ctw-design-team/aiot-mask-de10-nano-v2/SCHEMATIC/Prop123456.pdf

Object | Property Name | Property Value
GND : GND_19036 (Wire ID = 19050 ) | Name | GND_19036
Object | Property Name | Property Value
GND : GND_19036 (Wire ID = 19064 ) | Name | GND_19036
Object | Property Name | Property Value
GND : GND_19036 (Wire ID = 19078 ) | Name | GND_19036
Object | Property Name | Property Value
GND : GND_19036 (Wire ID = 19092 ) | Name | GND_19036
Object | Property Name | Property Value
GND : GND_19036 (Wire ID = 19106 ) | Name | GND_19036
Object | Property Name | Property Value
GND : GND_19036 (Wire ID = 19120 ) | Name | GND_19036
Object | Property Name | Property Value
GND : GND_19036 (Wire ID = 19134 ) | Name | GND_19036
Object | Property Name | Property Value
GND : GND_19036 (Wire ID = 19148 ) | Name | GND_19036
Object | Property Name | Property Value
GND : GND_19036 (Wire ID = 19162 ) | Name | GND_19036
Object | Property Name | Property Value
GND : GND_19036 (Wire ID = 19176 ) | Name | GND_19036
Object | Property Name | Property Value
GND : GND_19036 (Wire ID = 19190 ) | Name | GND_19036
Object | Property Name | Property Value
GND : GND_19036 (Wire ID = 19204 ) | Name | GND_19036
Object | Property Name | Property Value
GND : GND_19036 (Wire ID = 19218 ) | Name | GND_19036
Object | Property Name | Property Value
GND : GND_19036 (Wire ID = 19232 ) | Name | GND_19036
Object | Property Name | Property Value
GND : GND_19036 (Wire ID = 19246 ) | Name | GND_19036

Object | Property Name | Property Value
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
Object | Property Name | Property Value
ESP_EN : ESP_EN (Wire ID = 22253 ) | Name | ESP_EN
Object | Property Name | Property Value
V3V3_SYS : V3V3_SYS (Wire ID = 22288 ) | Name | V3V3_SYS
Object | Property Name | Property Value
ESP_EN : ESP_EN (Wire ID = 22326 ) | Name | ESP_EN

Object | Property Name | Property Value
ESP_EN : ESP_EN (Wire ID = 22330 ) | Name | ESP_EN
Object | Property Name | Property Value
GND : GND_19036 (Wire ID = 22450 ) | Name | GND_19036
Object | Property Name | Property Value
N22696 : N22696 (Wire ID = 22696 ) | Name | N22696
Object | Property Name | Property Value
ESP_IO0 : ESP_IO0 (Wire ID = 22700 ) | Name | ESP_IO0
Object | Property Name | Property Value
V3V3_SYS : V3V3_SYS (Wire ID = 22825 ) | Name | V3V3_SYS
Object | Property Name | Property Value
ESP_EN : ESP_EN (Wire ID = 22897 ) | Name | ESP_EN
Object | Property Name | Property Value
ESP_IO0 : ESP_IO0 (Wire ID = 22943 ) | Name | ESP_IO0
Object | Property Name | Property Value
N22977 : N22977 (Wire ID = 22977 ) | Name | N22977
Object | Property Name | Property Value
N22987 : N22987 (Wire ID = 22987 ) | Name | N22987
Object | Property Name | Property Value
GND : GND_19036 (Wire ID = 23323 ) | Name | GND_19036
Object | Property Name | Property Value
V3V3_SYS : V3V3_SYS (Wire ID = 27149 ) | Name | V3V3_SYS
Object | Property Name | Property Value
ESP_EN : ESP_EN (Wire ID = 37821 ) | Name | ESP_EN
Object | Property Name | Property Value
ESP_EN : ESP_EN (Wire ID = 37823 ) | Name | ESP_EN
Object | Property Name | Property Value
ESP_EN : ESP_EN (Wire ID = 37827 ) | Name | ESP_EN
Object | Property Name | Property Value
GND | Name | GND
Source Library | C:\CADENCE\SPB_22.1\TOOLS\CAPTURE\LIBRARY\CAPSYM.OLB
Source Symbol | GND

Object | Property Name | Property Value
GND | Name | GND
Source Library | C:\CADENCE\SPB_22.1\TOOLS\CAPTURE\LIBRARY\CAPSYM.OLB
Source Symbol | GND
Object | Property Name | Property Value
GND | Name | GND
Source Library | C:\CADENCE\SPB_22.1\TOOLS\CAPTURE\LIBRARY\CAPSYM.OLB
Source Symbol | GND
Object | Property Name | Property Value
GND | Name | GND
Source Library | C:\CADENCE\SPB_22.1\TOOLS\CAPTURE\LIBRARY\CAPSYM.OLB
Source Symbol | GND
Object | Property Name | Property Value
V3V3_SYS : | Name | V3V3_SYS
Source Library | C:\CADENCE\SPB_22.1\TOOLS\CAPTURE\LIBRARY\CAPSYM.OLB
Source Symbol | OFFPAGELEFT-L
Object | Property Name | Property Value
FPGA_TX_TO_ESP_RX : | Name | FPGA_TX_TO_ESP_RX
Source Library | C:\CADENCE\SPB_22.1\TOOLS\CAPTURE\LIBRARY\CAPSYM.OLB
Source Symbol | OFFPAGELEFT-L
Object | Property Name | Property Value
FPGA_RX_FROM_ESP_TX : | Name | FPGA_RX_FROM_ESP_TX
Source Library | C:\CADENCE\SPB_22.1\TOOLS\CAPTURE\LIBRARY\CAPSYM.OLB
Source Symbol | OFFPAGELEFT-L
Object | Property Name | Property Value
V3V3_SYS : | Name | V3V3_SYS
Source Library | C:\CADENCE\SPB_22.1\TOOLS\CAPTURE\LIBRARY\CAPSYM.OLB
Source Symbol | OFFPAGELEFT-L
Object | Property Name | Property Value
ESP_EN : | Name | ESP_EN
Source Library | C:\CADENCE\SPB_22.1\TOOLS\CAPTURE\LIBRARY\CAPSYM.OLB
Source Symbol | OFFPAGELEFT-L
Object | Property Name | Property Value
ESP_IO0 : | Name | ESP_IO0
Source Library | C:\CADENCE\SPB_22.1\TOOLS\CAPTURE\LIBRARY\CAPSYM.OLB
Source Symbol | OFFPAGELEFT-L
Object | Property Name | Property Value
V3V3_SYS : | Name | V3V3_SYS
Source Library | C:\CADENCE\SPB_22.1\TOOLS\CAPTURE\LIBRARY\CAPSYM.OLB
Source Symbol | OFFPAGELEFT-L

Object | Property Name | Property Value
ESP_EN : | Name | ESP_EN
Source Library | C:\CADENCE\SPB_22.1\TOOLS\CAPTURE\LIBRARY\CAPSYM.OLB
Source Symbol | OFFPAGELEFT-L
Object | Property Name | Property Value
ESP_IO0 : | Name | ESP_IO0
Source Library | C:\CADENCE\SPB_22.1\TOOLS\CAPTURE\LIBRARY\CAPSYM.OLB
Source Symbol | OFFPAGELEFT-L
Object | Property Name | Property Value
| Path Name | TitleBlock0
| Schematic Path | /
| ID | 102
| OrgAddr4
| OrgAddr3
| OrgAddr2
| OrgAddr1
| OrgName
| Cage Code
| RevCode
| Name | TitleBlock0
| Design Name | 123456
| Design File Name | C:\2 3 2026\SCHEMATIC\123456.DSN
| Design Create Date | Thursday, February 26, 2026
| Design Modify Date | Monday, March 02, 2026
| Design Create Time | 10:43:25
| Design Modify Time | 17:44:23
| Schematic Name | SCHEMATIC1
| Schematic Create Date | Thursday, February 26, 2026
| Schematic Modify Date | Monday, March 02, 2026
| Schematic Create Time | 10:43:26
| Schematic Modify Time | 10:09:44
| Schematic Page Count | 0
| Schematic Page Number | 0
| Page Size | A
| Page Create Date | Thursday, February 26, 2026
| Page Modify Date | Monday, March 02, 2026
| Page Create Time | 10:46:14
| Page Modify Time | 17:44:23

TitleBlock0 : TitleBlock0

Source Library | C:\CADENCE\SPB_22.1\TOOLS\CAPTURE\LIBRARY\CAPSYM.OLB
Source Symbol | TitleBlock0
Page Name | S4_ESP32_MODULE
Doc
Title
Page Number | 1
Page Count | 1

Object | Property Name | Property Value
INS21421 : C21 | Name | INS21421
| ID | 987
| Reference | C21
| Designator
| Part Reference | C21
| Value | 0.1uf
| Primitive | DEFAULT
| Implementation Type | <none>
| Implementation
| Implementation Path
| PCB Footprint | CAPC2012X94N
| OriginalSymbolOrigin | (0,10000)
Object | Property Name | Property Value
1 : C21/1 | Name | 1
| Number | 1
| Swap Id | -1
| Type | Passive
| Net Name | GND
| Order | 0
| Is No Connect | False
Object | Property Name | Property Value
2 : C21/2 | Name | 2
| Number | 2
| Swap Id | -1
| Type | Passive
| Net Name | V3V3_SYS
| Order | 1
| Is No Connect | False
Object | Property Name | Property Value
INS22237 : R13 | Name | INS22237
| ID | 1011
| Reference | R13
| Designator
| Part Reference | R13
| Value | 10k
| Primitive | DEFAULT
| Implementation Type | Schematic View
| Implementation | RC0805JR-070RL
| Implementation Path
| PCB Footprint | RC0805N_YAG
| Description | RES, 0, 5p, 0.125 W, 0805
| Manufacturer_Part_Number | RC0805JR-070RL
| Manufacturer_Name | Yageo
| Copyright | Copyright (C) 2026 Ultra Librarian. All rights reserved.

Object | Property Name | Property Value
1 : R13/1 | Name | 1
| Number | 1
| Swap Id | -1
| Type | Passive
| Net Name | ESP_EN
| Order | 0
| Is No Connect | False
Object | Property Name | Property Value
2 : R13/2 | Name | 2
| Number | 2
| Swap Id | -1
| Type | Passive
| Net Name | V3V3_SYS
| Order | 1
| Is No Connect | False
Object | Property Name | Property Value
INS22140 : R11 | Name | INS22140
| ID | 1000
| Reference | R11
| Designator
| Part Reference | R11
| Value | 0 Ohm
| Primitive | DEFAULT
| Implementation Type | Schematic View
| Implementation | RC0805JR-070RL
| Implementation Path
| PCB Footprint | RC0805N_YAG
| Description | RES, 0, 5p, 0.125 W, 0805
| Manufacturer_Part_Number | RC0805JR-070RL
| Manufacturer_Name | Yageo
| Copyright | Copyright (C) 2026 Ultra Librarian. All rights reserved.
Object | Property Name | Property Value
1 : R11/1 | Name | 1
| Number | 1
| Swap Id | -1
| Type | Passive
| Net Name | FPGA_TX_TO_ESP_RX
| Order | 0
| Is No Connect | False
Object | Property Name | Property Value
2 : R11/2 | Name | 2
| Number | 2
| Swap Id | -1
| Type | Passive
| Net Name | N22172
| Order | 1
| Is No Connect | False

Object | Property Name | Property Value
INS18912 : U4 | Name | INS18912
| ID | 867
| Reference | U4
| Designator
| Part Reference | U4
| Value | ESP32-WROOM-32
| Primitive | DEFAULT
| Implementation Type | <none>
| Implementation
| Implementation Path
| PCB Footprint | MODULE_ESP32-WROOM-32
| OriginalSymbolOrigin | (-60000,140000)
Object | Property Name | Property Value
GND : U4/GND | Name | GND
| Number | 1
| Swap Id | -1
| Type | Power
| Net Name | GND
| Order | 0
| Is No Connect | False
Object | Property Name | Property Value
3V3 : U4/3V3 | Name | 3V3
| Number | 2
| Swap Id | -1
| Type | Power
| Net Name | V3V3_SYS
| Order | 1
| Is No Connect | False
Object | Property Name | Property Value
EN : U4/EN | Name | EN
| Number | 3
| Swap Id | -1
| Type | Input
| Net Name | ESP_EN
| Order | 2
| Is No Connect | False
Object | Property Name | Property Value
SENSOR_VP : U4/SENSOR_VP | Name | SENSOR_VP
| Number | 4
| Swap Id | -1
| Type | Input
| Net Name
| Order | 3
| Is No Connect | True

Object | Property Name | Property Value
SENSOR_VN : U4/SENSOR_VN | Name | SENSOR_VN
| Number | 5
| Swap Id | -1
| Type | Input
| Net Name
| Order | 4
| Is No Connect | True
Object | Property Name | Property Value
IO34 : U4/IO34 | Name | IO34
| Number | 6
| Swap Id | -1
| Type | Input
| Net Name
| Order | 5
| Is No Connect | True
Object | Property Name | Property Value
IO35 : U4/IO35 | Name | IO35
| Number | 7
| Swap Id | -1
| Type | Input
| Net Name
| Order | 6
| Is No Connect | True
Object | Property Name | Property Value
IO32 : U4/IO32 | Name | IO32
| Number | 8
| Swap Id | -1
| Type | Bidirectional
| Net Name
| Order | 7
| Is No Connect | True
Object | Property Name | Property Value
IO33 : U4/IO33 | Name | IO33
| Number | 9
| Swap Id | -1
| Type | Bidirectional
| Net Name
| Order | 8
| Is No Connect | True
Object | Property Name | Property Value
IO25 : U4/IO25 | Name | IO25
| Number | 10
| Swap Id | -1
| Type | Bidirectional
| Net Name
| Order | 9
| Is No Connect | True

Object | Property Name | Property Value
IO26 : U4/IO26 | Name | IO26
| Number | 11
| Swap Id | -1
| Type | Bidirectional
| Net Name
| Order | 10
| Is No Connect | True
Object | Property Name | Property Value
IO27 : U4/IO27 | Name | IO27
| Number | 12
| Swap Id | -1
| Type | Bidirectional
| Net Name
| Order | 11
| Is No Connect | True
Object | Property Name | Property Value
IO14 : U4/IO14 | Name | IO14
| Number | 13
| Swap Id | -1
| Type | Bidirectional
| Net Name
| Order | 12
| Is No Connect | True
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
02 : J_PROG/02 | Name | 02
| Number | 02
| Swap Id | -1
| Type | Passive
| Net Name | ESP_EN
| Order | 1
| Is No Connect | False
Object | Property Name | Property Value
03 : J_PROG/03 | Name | 03
| Number | 03
| Swap Id | -1
| Type | Passive
| Net Name | N22987
| Order | 2
| Is No Connect | False

Object | Property Name | Property Value
04 : J_PROG/04 | Name | 04
| Number | 04
| Swap Id | -1
| Type | Passive
| Net Name | N22977
| Order | 3
| Is No Connect | False
Object | Property Name | Property Value
05 : J_PROG/05 | Name | 05
| Number | 05
| Swap Id | -1
| Type | Passive
| Net Name | GND
| Order | 4
| Is No Connect | False
Object | Property Name | Property Value
06 : J_PROG/06 | Name | 06
| Number | 06
| Swap Id | -1
| Type | Passive
| Net Name | V3V3_SYS
| Order | 5
| Is No Connect | False
Object | Property Name | Property Value
INS22678 : R14 | Name | INS22678
| ID | 1023
| Reference | R14
| Designator
| Part Reference | R14
| Value | 10K
| Primitive | DEFAULT
| Implementation Type | Schematic View
| Implementation | RC0805JR-070RL
| Implementation Path
| PCB Footprint | RC0805N_YAG
| Description | RES, 0, 5p, 0.125 W, 0805
| Manufacturer_Part_Number | RC0805JR-070RL
| Manufacturer_Name | Yageo
| Copyright | Copyright (C) 2026 Ultra Librarian. All rights reserved.
Object | Property Name | Property Value
1 : R14/1 | Name | 1
| Number | 1
| Swap Id | -1
| Type | Passive
| Net Name | ESP_IO0
| Order | 0
| Is No Connect | False

Object | Property Name | Property Value
2 : R14/2 | Name | 2
| Number | 2
| Swap Id | -1
| Type | Passive
| Net Name | N22696
| Order | 1
| Is No Connect | False
Object | Property Name | Property Value
INS22190 : R12 | Name | INS22190
| ID | 1007
| Reference | R12
| Designator
| Part Reference | R12
| Value | 0 Ohm
| Primitive | DEFAULT
| Implementation Type | Schematic View
| Implementation | RC0805JR-070RL
| Implementation Path
| PCB Footprint | RC0805N_YAG
| Description | RES, 0, 5p, 0.125 W, 0805
| Manufacturer_Part_Number | RC0805JR-070RL
| Manufacturer_Name | Yageo
| Copyright | Copyright (C) 2026 Ultra Librarian. All rights reserved.
Object | Property Name | Property Value
1 : R12/1 | Name | 1
| Number | 1
| Swap Id | -1
| Type | Passive
| Net Name | FPGA_RX_FROM_ESP_TX
| Order | 0
| Is No Connect | False
Object | Property Name | Property Value
2 : R12/2 | Name | 2
| Number | 2
| Swap Id | -1
| Type | Passive
| Net Name | N22206
| Order | 1
| Is No Connect | False

Object | Property Name | Property Value
INS21493 : C22 | Name | INS21493
| ID | 990
| Reference | C22
| Designator
| Part Reference | C22
| Value | 10uf
| Primitive | DEFAULT
| Implementation Type | <none>
| Implementation
| Implementation Path
| PCB Footprint | CAPC2012X94N
| OriginalSymbolOrigin | (0,10000)
Object | Property Name | Property Value
1 : C22/1 | Name | 1
| Number | 1
| Swap Id | -1
| Type | Passive
| Net Name | V3V3_SYS
| Order | 0
| Is No Connect | False
Object | Property Name | Property Value
2 : C22/2 | Name | 2
| Number | 2
| Swap Id | -1
| Type | Passive
| Net Name | GND
| Order | 1
| Is No Connect | False
Object | Property Name | Property Value
INS22310 : C23 | Name | INS22310
| ID | 1016
| Reference | C23
| Designator
| Part Reference | C23
| Value | 0.1uf
| Primitive | DEFAULT
| Implementation Type | <none>
| Implementation
| Implementation Path
| PCB Footprint | CAPC2012X94N
| OriginalSymbolOrigin | (0,10000)
Object | Property Name | Property Value
1 : C23/1 | Name | 1
| Number | 1
| Swap Id | -1
| Type | Passive
| Net Name | GND
| Order | 0
| Is No Connect | False

Object | Property Name | Property Value
2 : C23/2 | Name | 2
| Number | 2
| Swap Id | -1
| Type | Passive
| Net Name | ESP_EN
| Order | 1
| Is No Connect | False
