ctw-design-team/aiot-mask-de10-nano-v2/SCHEMATIC/PropS0_TOP.pdf

Object | Property Name | Property Value
Rectangle | Name | I01663
| Left | 20
| Top | 90
| Right | 100
| Bottom | 210
| Fill Style | Hollow Fill
| Hatch Style | Horizontal Hatch
Object | Property Name | Property Value
Rectangle | Name | I01669
| Left | 30
| Top | 250
| Right | 110
| Bottom | 300
| Fill Style | Hollow Fill
| Hatch Style | Horizontal Hatch
Object | Property Name | Property Value
Rectangle | Name | I01673
| Left | 30
| Top | 330
| Right | 170
| Bottom | 380
| Fill Style | Hollow Fill
| Hatch Style | Horizontal Hatch
Object | Property Name | Property Value
Rectangle | Name | I01677
| Left | 740
| Top | 50
| Right | 880
| Bottom | 420
| Fill Style | Hollow Fill
| Hatch Style | Horizontal Hatch
Object | Property Name | Property Value
POWER | Name | I01667
| Bounding Box Left | 20
| Bounding Box Right | 47
| Bounding Box Top | 70
| Bounding Box Bottom | 79
| Text | POWER
| Text Location X-Coordinate | 20
| Text Location Y-Coordinate | 70
| Font | Courier New

Object | Property Name | Property Value
SENSOR I2C | Name | I01671
| Bounding Box Left | 30
| Bounding Box Right | 82
| Bounding Box Top | 240
| Bounding Box Bottom | 249
| Text | SENSOR I2C
| Text Location X-Coordinate | 30
| Text Location Y-Coordinate | 240
| Font | Courier New
Object | Property Name | Property Value
ESP32 UART | Name | I01675
| Bounding Box Left | 30
| Bounding Box Right | 82
| Bounding Box Top | 320
| Bounding Box Bottom | 329
| Text | ESP32 UART
| Text Location X-Coordinate | 30
| Text Location Y-Coordinate | 320
| Font | Courier New
Object | Property Name | Property Value
CAMERA 0V2640 | Name | I01679
| Bounding Box Left | 740
| Bounding Box Right | 807
| Bounding Box Top | 40
| Bounding Box Bottom | 49
| Text | CAMERA 0V2640
| Text Location X-Coordinate | 740
| Text Location Y-Coordinate | 40
| Font | Courier New
Object | Property Name | Property Value
GND : GND (Wire ID = 2646 ) | Name | GND
Object | Property Name | Property Value
GND : GND (Wire ID = 3256 ) | Name | GND
Object | Property Name | Property Value
FPGA_RX_FROM_ESP_TX : FPGA_RX_FROM_ESP_TX (Wire ID = 8939 ) Name | | FPGA_RX_FROM_ESP_TX
Object | Property Name | Property Value
FPGA_RX_FROM_ESP_TX : FPGA_RX_FROM_ESP_TX (Wire ID = 8941 ) Name | | FPGA_RX_FROM_ESP_TX
Object | Property Name | Property Value
CAM_D0 : CAM_D0 (Wire ID = 9169 ) | Name | CAM_D0
Object | Property Name | Property Value
CAM_D1 : CAM_D1 (Wire ID = 9211 ) | Name | CAM_D1

Object | Property Name | Property Value
CAM_D2 : CAM_D2 (Wire ID = 9234 ) | Name | CAM_D2
Object | Property Name | Property Value
CAM_D3 : CAM_D3 (Wire ID = 9253 ) | Name | CAM_D3
Object | Property Name | Property Value
CAM_D5 : CAM_D5 (Wire ID = 9272 ) | Name | CAM_D5
Object | Property Name | Property Value
CAM_D4 : CAM_D4 (Wire ID = 9317 ) | Name | CAM_D4
Object | Property Name | Property Value
CAM_D6 : CAM_D6 (Wire ID = 9344 ) | Name | CAM_D6
Object | Property Name | Property Value
CAM_D7 : CAM_D7 (Wire ID = 9391 ) | Name | CAM_D7
Object | Property Name | Property Value
CAM_PCLK : CAM_PCLK (Wire ID = 9399 ) | Name | CAM_PCLK
Object | Property Name | Property Value
CAM_HSYNC : CAM_HSYNC (Wire ID = 9475 ) | Name | CAM_HSYNC
Object | Property Name | Property Value
CAM_VSYNC : CAM_VSYNC (Wire ID = 9507 ) | Name | CAM_VSYNC
Object | Property Name | Property Value
CAM_XCLK : CAM_XCLK (Wire ID = 9553 ) | Name | CAM_XCLK
Object | Property Name | Property Value
CAM_RESET : CAM_RESET (Wire ID = 9574 ) | Name | CAM_RESET
Object | Property Name | Property Value
CAM_PWDN : CAM_PWDN (Wire ID = 9593 ) | Name | CAM_PWDN
Object | Property Name | Property Value
I2C_SCL : I2C_SCL (Wire ID = 9616 ) | Name | I2C_SCL
Object | Property Name | Property Value
FPGA_TX_TO_ESP_RX : FPGA_TX_TO_ESP_RX (Wire ID = 9699 ) Name | | FPGA_TX_TO_ESP_RX
Object | Property Name | Property Value
FPGA_TX_TO_ESP_RX : FPGA_TX_TO_ESP_RX (Wire ID = 9717 ) Name | | FPGA_TX_TO_ESP_RX

Object | Property Name | Property Value
V5_IN : V5_IN (Wire ID = 9875 ) | Name | V5_IN
Object | Property Name | Property Value
ESP_EN : ESP_EN (Wire ID = 31366 ) | Name | ESP_EN
Object | Property Name | Property Value
ESP_IO0 : ESP_IO0 (Wire ID = 31376 ) | Name | ESP_IO0
Object | Property Name | Property Value
I2C_SDA : I2C_SDA (Wire ID = 31483 ) | Name | I2C_SDA
Object | Property Name | Property Value
DE10_VCC3P3 : DE10_VCC3P3 (Wire ID = 37924 ) | Name | DE10_VCC3P3
Object | Property Name | Property Value
DE10_VCC3P3 : DE10_VCC3P3 (Wire ID = 37932 ) | Name | DE10_VCC3P3
Object | Property Name | Property Value
DE10_VCC3P3 : DE10_VCC3P3 (Wire ID = 37934 ) | Name | DE10_VCC3P3
Object | Property Name | Property Value
V3V3_SYS : | Name | V3V3_SYS
Source Library | C:\CADENCE\SPB_22.1\TOOLS\CAPTURE\LIBRARY\CAPSYM.OLB
Source Symbol | OFFPAGELEFT-L
Object | Property Name | Property Value
V2V8_CAM : | Name | V2V8_CAM
Source Library | C:\CADENCE\SPB_22.1\TOOLS\CAPTURE\LIBRARY\CAPSYM.OLB
Source Symbol | OFFPAGELEFT-L
Object | Property Name | Property Value
V1V2_CAM : | Name | V1V2_CAM
Source Library | C:\CADENCE\SPB_22.1\TOOLS\CAPTURE\LIBRARY\CAPSYM.OLB
Source Symbol | OFFPAGELEFT-L
Object | Property Name | Property Value
GND : | Name | GND
Source Library | C:\CADENCE\SPB_22.1\TOOLS\CAPTURE\LIBRARY\CAPSYM.OLB
Source Symbol | OFFPAGELEFT-L
Object | Property Name | Property Value
I2C_SCL : | Name | I2C_SCL
Source Library | C:\CADENCE\SPB_22.1\TOOLS\CAPTURE\LIBRARY\CAPSYM.OLB
Source Symbol | OFFPAGELEFT-L

Object | Property Name | Property Value
I2C_SDA : | Name | I2C_SDA
Source Library | C:\CADENCE\SPB_22.1\TOOLS\CAPTURE\LIBRARY\CAPSYM.OLB
Source Symbol | OFFPAGELEFT-L
Object | Property Name | Property Value
FPGA_TX_TO_ESP_RX : | Name | FPGA_TX_TO_ESP_RX
Source Library | C:\CADENCE\SPB_22.1\TOOLS\CAPTURE\LIBRARY\CAPSYM.OLB
Source Symbol | OFFPAGELEFT-L
Object | Property Name | Property Value
FPGA_RX_FROM_ESP_TX : | Name | FPGA_RX_FROM_ESP_TX
Source Library | C:\CADENCE\SPB_22.1\TOOLS\CAPTURE\LIBRARY\CAPSYM.OLB
Source Symbol | OFFPAGELEFT-L
Object | Property Name | Property Value
CAM_D0 : | Name | CAM_D0
Source Library | C:\CADENCE\SPB_22.1\TOOLS\CAPTURE\LIBRARY\CAPSYM.OLB
Source Symbol | OFFPAGELEFT-L
Object | Property Name | Property Value
CAM_D1 : | Name | CAM_D1
Source Library | C:\CADENCE\SPB_22.1\TOOLS\CAPTURE\LIBRARY\CAPSYM.OLB
Source Symbol | OFFPAGELEFT-L
Object | Property Name | Property Value
CAM_D2 : | Name | CAM_D2
Source Library | C:\CADENCE\SPB_22.1\TOOLS\CAPTURE\LIBRARY\CAPSYM.OLB
Source Symbol | OFFPAGELEFT-L
Object | Property Name | Property Value
CAM_D3 : | Name | CAM_D3
Source Library | C:\CADENCE\SPB_22.1\TOOLS\CAPTURE\LIBRARY\CAPSYM.OLB
Source Symbol | OFFPAGELEFT-L
Object | Property Name | Property Value
CAM_D4 : | Name | CAM_D4
Source Library | C:\CADENCE\SPB_22.1\TOOLS\CAPTURE\LIBRARY\CAPSYM.OLB
Source Symbol | OFFPAGELEFT-L
Object | Property Name | Property Value
CAM_D5 : | Name | CAM_D5
Source Library | C:\CADENCE\SPB_22.1\TOOLS\CAPTURE\LIBRARY\CAPSYM.OLB
Source Symbol | OFFPAGELEFT-L
Object | Property Name | Property Value
CAM_D6 : | Name | CAM_D6
Source Library | C:\CADENCE\SPB_22.1\TOOLS\CAPTURE\LIBRARY\CAPSYM.OLB
Source Symbol | OFFPAGELEFT-L

Object | Property Name | Property Value
CAM_D7 : | Name | CAM_D7
Source Library | C:\CADENCE\SPB_22.1\TOOLS\CAPTURE\LIBRARY\CAPSYM.OLB
Source Symbol | OFFPAGELEFT-L
Object | Property Name | Property Value
CAM_PCLK : | Name | CAM_PCLK
Source Library | C:\CADENCE\SPB_22.1\TOOLS\CAPTURE\LIBRARY\CAPSYM.OLB
Source Symbol | OFFPAGELEFT-L
Object | Property Name | Property Value
CAM_HSYNC : | Name | CAM_HSYNC
Source Library | C:\CADENCE\SPB_22.1\TOOLS\CAPTURE\LIBRARY\CAPSYM.OLB
Source Symbol | OFFPAGELEFT-L
Object | Property Name | Property Value
CAM_VSYNC : | Name | CAM_VSYNC
Source Library | C:\CADENCE\SPB_22.1\TOOLS\CAPTURE\LIBRARY\CAPSYM.OLB
Source Symbol | OFFPAGELEFT-L
Object | Property Name | Property Value
CAM_XCLK : | Name | CAM_XCLK
Source Library | C:\CADENCE\SPB_22.1\TOOLS\CAPTURE\LIBRARY\CAPSYM.OLB
Source Symbol | OFFPAGELEFT-L
Object | Property Name | Property Value
CAM_RESET : | Name | CAM_RESET
Source Library | C:\CADENCE\SPB_22.1\TOOLS\CAPTURE\LIBRARY\CAPSYM.OLB
Source Symbol | OFFPAGELEFT-L
Object | Property Name | Property Value
CAM_PWDN : | Name | CAM_PWDN
Source Library | C:\CADENCE\SPB_22.1\TOOLS\CAPTURE\LIBRARY\CAPSYM.OLB
Source Symbol | OFFPAGELEFT-L
Object | Property Name | Property Value
CAM_SCCB_SCL : | Name | CAM_SCCB_SCL
Source Library | C:\CADENCE\SPB_22.1\TOOLS\CAPTURE\LIBRARY\CAPSYM.OLB
Source Symbol | OFFPAGELEFT-L
Object | Property Name | Property Value
CAM_SCCB_SDA : | Name | CAM_SCCB_SDA
Source Library | C:\CADENCE\SPB_22.1\TOOLS\CAPTURE\LIBRARY\CAPSYM.OLB
Source Symbol | OFFPAGELEFT-L
Object | Property Name | Property Value
GND : | Name | GND
Source Library | C:\CADENCE\SPB_22.1\TOOLS\CAPTURE\LIBRARY\CAPSYM.OLB
Source Symbol | OFFPAGELEFT-L

Object | Property Name | Property Value
GND : | Name | GND
Source Library | C:\CADENCE\SPB_22.1\TOOLS\CAPTURE\LIBRARY\CAPSYM.OLB
Source Symbol | OFFPAGELEFT-L
Object | Property Name | Property Value
FPGA_TX_TO_ESP_RX : | Name | FPGA_TX_TO_ESP_RX
Source Library | C:\CADENCE\SPB_22.1\TOOLS\CAPTURE\LIBRARY\CAPSYM.OLB
Source Symbol | OFFPAGELEFT-L
Object | Property Name | Property Value
FPGA_RX_FROM_ESP_TX : | Name | FPGA_RX_FROM_ESP_TX
Source Library | C:\CADENCE\SPB_22.1\TOOLS\CAPTURE\LIBRARY\CAPSYM.OLB
Source Symbol | OFFPAGELEFT-L
Object | Property Name | Property Value
CAM_D0 : | Name | CAM_D0
Source Library | C:\CADENCE\SPB_22.1\TOOLS\CAPTURE\LIBRARY\CAPSYM.OLB
Source Symbol | OFFPAGELEFT-L
Object | Property Name | Property Value
CAM_D1 : | Name | CAM_D1
Source Library | C:\CADENCE\SPB_22.1\TOOLS\CAPTURE\LIBRARY\CAPSYM.OLB
Source Symbol | OFFPAGELEFT-L
Object | Property Name | Property Value
CAM_D2 : | Name | CAM_D2
Source Library | C:\CADENCE\SPB_22.1\TOOLS\CAPTURE\LIBRARY\CAPSYM.OLB
Source Symbol | OFFPAGELEFT-L
Object | Property Name | Property Value
CAM_D3 : | Name | CAM_D3
Source Library | C:\CADENCE\SPB_22.1\TOOLS\CAPTURE\LIBRARY\CAPSYM.OLB
Source Symbol | OFFPAGELEFT-L
Object | Property Name | Property Value
CAM_D5 : | Name | CAM_D5
Source Library | C:\CADENCE\SPB_22.1\TOOLS\CAPTURE\LIBRARY\CAPSYM.OLB
Source Symbol | OFFPAGELEFT-L
Object | Property Name | Property Value
CAM_D4 : | Name | CAM_D4
Source Library | C:\CADENCE\SPB_22.1\TOOLS\CAPTURE\LIBRARY\CAPSYM.OLB
Source Symbol | OFFPAGELEFT-L
Object | Property Name | Property Value
CAM_D6 : | Name | CAM_D6
Source Library | C:\CADENCE\SPB_22.1\TOOLS\CAPTURE\LIBRARY\CAPSYM.OLB
Source Symbol | OFFPAGELEFT-L

Object | Property Name | Property Value
CAM_PCLK : | Name | CAM_PCLK
Source Library | C:\CADENCE\SPB_22.1\TOOLS\CAPTURE\LIBRARY\CAPSYM.OLB
Source Symbol | OFFPAGELEFT-L
Object | Property Name | Property Value
CAM_VSYNC : | Name | CAM_VSYNC
Source Library | C:\CADENCE\SPB_22.1\TOOLS\CAPTURE\LIBRARY\CAPSYM.OLB
Source Symbol | OFFPAGELEFT-L
Object | Property Name | Property Value
CAM_XCLK : | Name | CAM_XCLK
Source Library | C:\CADENCE\SPB_22.1\TOOLS\CAPTURE\LIBRARY\CAPSYM.OLB
Source Symbol | OFFPAGELEFT-L
Object | Property Name | Property Value
CAM_HSYNC : | Name | CAM_HSYNC
Source Library | C:\CADENCE\SPB_22.1\TOOLS\CAPTURE\LIBRARY\CAPSYM.OLB
Source Symbol | OFFPAGELEFT-L
Object | Property Name | Property Value
CAM_D7 : | Name | CAM_D7
Source Library | C:\CADENCE\SPB_22.1\TOOLS\CAPTURE\LIBRARY\CAPSYM.OLB
Source Symbol | OFFPAGELEFT-L
Object | Property Name | Property Value
CAM_RESET : | Name | CAM_RESET
Source Library | C:\CADENCE\SPB_22.1\TOOLS\CAPTURE\LIBRARY\CAPSYM.OLB
Source Symbol | OFFPAGELEFT-L
Object | Property Name | Property Value
CAM_PWDN : | Name | CAM_PWDN
Source Library | C:\CADENCE\SPB_22.1\TOOLS\CAPTURE\LIBRARY\CAPSYM.OLB
Source Symbol | OFFPAGELEFT-L
Object | Property Name | Property Value
V5_IN : | Name | V5_IN
Source Library | C:\CADENCE\SPB_22.1\TOOLS\CAPTURE\LIBRARY\CAPSYM.OLB
Source Symbol | OFFPAGELEFT-L
Object | Property Name | Property Value
V5_IN : | Name | V5_IN
Source Library | C:\CADENCE\SPB_22.1\TOOLS\CAPTURE\LIBRARY\CAPSYM.OLB
Source Symbol | OFFPAGELEFT-L
Object | Property Name | Property Value
ESP_EN : | Name | ESP_EN
Source Library | C:\CADENCE\SPB_22.1\TOOLS\CAPTURE\LIBRARY\CAPSYM.OLB
Source Symbol | OFFPAGELEFT-L

Object | Property Name | Property Value
ESP_IO0 : | Name | ESP_IO0
Source Library | C:\CADENCE\SPB_22.1\TOOLS\CAPTURE\LIBRARY\CAPSYM.OLB
Source Symbol | OFFPAGELEFT-L
Object | Property Name | Property Value
I2C_SCL : | Name | I2C_SCL
Source Library | C:\CADENCE\SPB_22.1\TOOLS\CAPTURE\LIBRARY\CAPSYM.OLB
Source Symbol | OFFPAGELEFT-L
Object | Property Name | Property Value
I2C_SDA : | Name | I2C_SDA
Source Library | C:\CADENCE\SPB_22.1\TOOLS\CAPTURE\LIBRARY\CAPSYM.OLB
Source Symbol | OFFPAGELEFT-L
Object | Property Name | Property Value
DE10_VCC3P3 : | Name | DE10_VCC3P3
Source Library | C:\CADENCE\SPB_22.1\TOOLS\CAPTURE\LIBRARY\CAPSYM.OLB
Source Symbol | OFFPAGELEFT-L

Object | Property Name | Property Value
| Path Name | TitleBlock0
| Schematic Path | /
| ID | 197
| Title | S0_TOP
| RevCode
| Cage Code
| OrgName
| OrgAddr1
| OrgAddr2
| OrgAddr3
| OrgAddr4
| Name | TitleBlock0
| Design Name | 123456
| Design File Name | C:\2 3 2026\SCHEMATIC\123456.DSN
| Design Create Date | Thursday, February 26, 2026
| Design Modify Date | Tuesday, March 03, 2026
| Design Create Time | 10:43:25
| Design Modify Time | 11:20:44
| Schematic Name | SCHEMATIC1
| Schematic Create Date | Thursday, February 26, 2026
| Schematic Modify Date | Monday, March 02, 2026
| Schematic Create Time | 10:43:26
| Schematic Modify Time | 11:20:46
| Schematic Page Count | 0
| Schematic Page Number | 0
| Page Size | A
| Page Create Date | Thursday, February 26, 2026
| Page Modify Date | Monday, March 02, 2026
| Page Create Time | 10:56:03
| Page Modify Time | 17:04:33

TitleBlock0 : TitleBlock0

Source Library | C:\CADENCE\SPB_22.1\TOOLS\CAPTURE\LIBRARY\CAPSYM.OLB
Source Symbol | TitleBlock0
Page Name | S0_TOP
Doc
Page Number | 1
Page Count | 1
Object | Property Name | Property Value
INS1021 : JP1 | Name | INS1021
| ID | 198
| Reference | JP1
| Designator
| Part Reference | JP1
| Value | TSW-120-07-G-D-LL
| Primitive | DEFAULT
| Implementation Type | <none>
| Implementation
| Implementation Path
| PCB Footprint | SAMTEC_TSW-120-07-G-D-LL
| OriginalSymbolOrigin | (-30000,110000)

Object | Property Name | Property Value
01 : JP1/01 | Name | 01
| Number | 01
| Swap Id | -1
| Type | Passive
| Net Name | FPGA_TX_TO_ESP_RX
| Order | 0
| Is No Connect | True
Object | Property Name | Property Value
02 : JP1/02 | Name | 02
| Number | 02
| Swap Id | -1
| Type | Passive
| Net Name | FPGA_RX_FROM_ESP_TX
| Order | 1
| Is No Connect | True
Object | Property Name | Property Value
03 : JP1/03 | Name | 03
| Number | 03
| Swap Id | -1
| Type | Passive
| Net Name | ESP_EN
| Order | 2
| Is No Connect | True
Object | Property Name | Property Value
04 : JP1/04 | Name | 04
| Number | 04
| Swap Id | -1
| Type | Passive
| Net Name | ESP_IO0
| Order | 3
| Is No Connect | True
Object | Property Name | Property Value
05 : JP1/05 | Name | 05
| Number | 05
| Swap Id | -1
| Type | Passive
| Net Name
| Order | 4
| Is No Connect | True
Object | Property Name | Property Value
06 : JP1/06 | Name | 06
| Number | 06
| Swap Id | -1
| Type | Passive
| Net Name
| Order | 5
| Is No Connect | True

Object | Property Name | Property Value
07 : JP1/07 | Name | 07
| Number | 07
| Swap Id | -1
| Type | Passive
| Net Name
| Order | 6
| Is No Connect | True
Object | Property Name | Property Value
08 : JP1/08 | Name | 08
| Number | 08
| Swap Id | -1
| Type | Passive
| Net Name
| Order | 7
| Is No Connect | True
Object | Property Name | Property Value
09 : JP1/09 | Name | 09
| Number | 09
| Swap Id | -1
| Type | Passive
| Net Name
| Order | 8
| Is No Connect | True
Object | Property Name | Property Value
10 : JP1/10 | Name | 10
| Number | 10
| Swap Id | -1
| Type | Passive
| Net Name
| Order | 9
| Is No Connect | True
Object | Property Name | Property Value
11 : JP1/11 | Name | 11
| Number | 11
| Swap Id | -1
| Type | Passive
| Net Name | V5_IN
| Order | 10
| Is No Connect | True
Object | Property Name | Property Value
12 : JP1/12 | Name | 12
| Number | 12
| Swap Id | -1
| Type | Passive
| Net Name
| Order | 11
| Is No Connect | True

Object | Property Name | Property Value
13 : JP1/13 | Name | 13
| Number | 13
| Swap Id | -1
| Type | Passive
| Net Name
| Order | 12
| Is No Connect | True
Object | Property Name | Property Value
14 : JP1/14 | Name | 14
| Number | 14
| Swap Id | -1
| Type | Passive
| Net Name
| Order | 13
| Is No Connect | True
Object | Property Name | Property Value
15 : JP1/15 | Name | 15
| Number | 15
| Swap Id | -1
| Type | Passive
| Net Name
| Order | 14
| Is No Connect | True
Object | Property Name | Property Value
16 : JP1/16 | Name | 16
| Number | 16
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
35 : JP7/35 | Name | 35
| Number | 35
| Swap Id | -1
| Type | Passive
| Net Name
| Order | 34
| Is No Connect | True
Object | Property Name | Property Value
36 : JP7/36 | Name | 36
| Number | 36
| Swap Id | -1
| Type | Passive
| Net Name
| Order | 35
| Is No Connect | True

Object | Property Name | Property Value
37 : JP7/37 | Name | 37
| Number | 37
| Swap Id | -1
| Type | Passive
| Net Name
| Order | 36
| Is No Connect | True
Object | Property Name | Property Value
38 : JP7/38 | Name | 38
| Number | 38
| Swap Id | -1
| Type | Passive
| Net Name
| Order | 37
| Is No Connect | True
Object | Property Name | Property Value
39 : JP7/39 | Name | 39
| Number | 39
| Swap Id | -1
| Type | Passive
| Net Name
| Order | 38
| Is No Connect | True
Object | Property Name | Property Value
40 : JP7/40 | Name | 40
| Number | 40
| Swap Id | -1
| Type | Passive
| Net Name
| Order | 39
| Is No Connect | True
