ctw-design-team/aiot-mask-de10-nano-v2/SCHEMATIC/PropS1_POWER_TREE.pdf

Object | Property Name | Property Value
MOUNT ONLY ONE: V5->3V3 OR DE10_3V3 | Name | I12386
| Bounding Box Left | 190
| Bounding Box Right | 367
| Bounding Box Top | 90
| Bounding Box Bottom | 99
| Text | MOUNT ONLY ONE: V5->3V3 OR DE10_3V3
| Text Location X-Coordinate | 190
| Text Location Y-Coordinate | 90
| Font | Courier New
Object | Property Name | Property Value
V5_IN : V5_IN (Wire ID = 11490 ) | Name | V5_IN
Object | Property Name | Property Value
GND : GND (Wire ID = 11636 ) | Name | GND
Object | Property Name | Property Value
GND : GND (Wire ID = 11654 ) | Name | GND
Object | Property Name | Property Value
V5_IN : V5_IN (Wire ID = 11662 ) | Name | V5_IN
Object | Property Name | Property Value
V5_IN : V5_IN (Wire ID = 11666 ) | Name | V5_IN
Object | Property Name | Property Value
GND : GND (Wire ID = 11673 ) | Name | GND
Object | Property Name | Property Value
V5_IN : V5_IN (Wire ID = 11805 ) | Name | V5_IN
Object | Property Name | Property Value
GND : GND (Wire ID = 11814 ) | Name | GND
Object | Property Name | Property Value
GND : GND (Wire ID = 11858 ) | Name | GND
Object | Property Name | Property Value
GND : GND (Wire ID = 11877 ) | Name | GND
Object | Property Name | Property Value
GND : GND (Wire ID = 12041 ) | Name | GND
Object | Property Name | Property Value
V3V3_SYS : V3V3_SYS (Wire ID = 12055 ) | Name | V3V3_SYS

Object | Property Name | Property Value
V3V3_SYS : V3V3_SYS (Wire ID = 12057 ) | Name | V3V3_SYS
Object | Property Name | Property Value
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
Object | Property Name | Property Value
V1V2_CAM : V1V2_CAM (Wire ID = 13982 ) | Name | V1V2_CAM
Object | Property Name | Property Value
V1V2_CAM : V1V2_CAM (Wire ID = 13992 ) | Name | V1V2_CAM
Object | Property Name | Property Value
V3V3_CAM : V3V3_CAM (Wire ID = 14107 ) | Name | V3V3_CAM

Object | Property Name | Property Value
V3V3_CAM : V3V3_CAM (Wire ID = 14115 ) | Name | V3V3_CAM
Object | Property Name | Property Value
GND : GND (Wire ID = 14132 ) | Name | GND
Object | Property Name | Property Value
V3V3_CAM : V3V3_CAM (Wire ID = 14195 ) | Name | V3V3_CAM
Object | Property Name | Property Value
V3V3_CAM : V3V3_CAM (Wire ID = 14199 ) | Name | V3V3_CAM
Object | Property Name | Property Value
GND : GND (Wire ID = 14214 ) | Name | GND
Object | Property Name | Property Value
V5_IN : V5_IN (Wire ID = 36909 ) | Name | V5_IN
Object | Property Name | Property Value
V5_IN : V5_IN (Wire ID = 36913 ) | Name | V5_IN
Object | Property Name | Property Value
V5_IN : V5_IN (Wire ID = 36917 ) | Name | V5_IN
Object | Property Name | Property Value
V3V3_SYS : V3V3_SYS (Wire ID = 36957 ) | Name | V3V3_SYS
Object | Property Name | Property Value
V3V3_SYS : V3V3_SYS (Wire ID = 36961 ) | Name | V3V3_SYS
Object | Property Name | Property Value
V3V3_CAM : V3V3_CAM (Wire ID = 36981 ) | Name | V3V3_CAM
Object | Property Name | Property Value
V2V8_CAM : V2V8_CAM (Wire ID = 37007 ) | Name | V2V8_CAM
Object | Property Name | Property Value
GND : GND (Wire ID = 37019 ) | Name | GND
Object | Property Name | Property Value
GND : GND (Wire ID = 37028 ) | Name | GND
Object | Property Name | Property Value
GND : GND (Wire ID = 37030 ) | Name | GND

Object | Property Name | Property Value
V1V2_CAM : V1V2_CAM (Wire ID = 37109 ) | Name | V1V2_CAM
Object | Property Name | Property Value
V1V2_CAM : V1V2_CAM (Wire ID = 37113 ) | Name | V1V2_CAM
Object | Property Name | Property Value
V1V2_CAM : V1V2_CAM (Wire ID = 37115 ) | Name | V1V2_CAM
Object | Property Name | Property Value
V2V8_CAM : | Name | V2V8_CAM
Source Library | C:\CADENCE\SPB_22.1\TOOLS\CAPTURE\LIBRARY\CAPSYM.OLB
Source Symbol | OFFPAGELEFT-L
Object | Property Name | Property Value
V3V3_SYS : | Name | V3V3_SYS
Source Library | C:\CADENCE\SPB_22.1\TOOLS\CAPTURE\LIBRARY\CAPSYM.OLB
Source Symbol | OFFPAGELEFT-L
Object | Property Name | Property Value
V5_IN : | Name | V5_IN
Source Library | C:\CADENCE\SPB_22.1\TOOLS\CAPTURE\LIBRARY\CAPSYM.OLB
Source Symbol | OFFPAGELEFT-L
Object | Property Name | Property Value
GND : | Name | GND
Source Library | C:\CADENCE\SPB_22.1\TOOLS\CAPTURE\LIBRARY\CAPSYM.OLB
Source Symbol | OFFPAGELEFT-L
Object | Property Name | Property Value
V3V3_CAM : | Name | V3V3_CAM
Source Library | C:\CADENCE\SPB_22.1\TOOLS\CAPTURE\LIBRARY\CAPSYM.OLB
Source Symbol | OFFPAGELEFT-L
Object | Property Name | Property Value
V3V3_CAM : | Name | V3V3_CAM
Source Library | C:\CADENCE\SPB_22.1\TOOLS\CAPTURE\LIBRARY\CAPSYM.OLB
Source Symbol | OFFPAGELEFT-L
Object | Property Name | Property Value
GND : | Name | GND
Source Library | C:\CADENCE\SPB_22.1\TOOLS\CAPTURE\LIBRARY\CAPSYM.OLB
Source Symbol | OFFPAGELEFT-L
Object | Property Name | Property Value
V1V2_CAM : | Name | V1V2_CAM
Source Library | C:\CADENCE\SPB_22.1\TOOLS\CAPTURE\LIBRARY\CAPSYM.OLB
Source Symbol | OFFPAGELEFT-L

Object | Property Name | Property Value
V3V3_CAM : | Name | V3V3_CAM
Source Library | C:\CADENCE\SPB_22.1\TOOLS\CAPTURE\LIBRARY\CAPSYM.OLB
Source Symbol | OFFPAGELEFT-L
Object | Property Name | Property Value
GND : | Name | GND
Source Library | C:\CADENCE\SPB_22.1\TOOLS\CAPTURE\LIBRARY\CAPSYM.OLB
Source Symbol | OFFPAGELEFT-L
Object | Property Name | Property Value
| Path Name | TitleBlock0
| Schematic Path | /
| ID | 101
| Title | S1_POWER_TREE
| OrgAddr4
| OrgAddr3
| OrgAddr2
| OrgAddr1
| OrgName
| Cage Code
| RevCode
| Name | TitleBlock0
| Design Name | 123456
| Design File Name | C:\2 3 2026\SCHEMATIC\123456.DSN
| Design Create Date | Thursday, February 26, 2026
| Design Modify Date | Tuesday, March 03, 2026
| Design Create Time | 10:43:25
| Design Modify Time | 11:20:44
| Schematic Name | SCHEMATIC1
| Schematic Create Date | Thursday, February 26, 2026
| Schematic Modify Date | Tuesday, March 03, 2026
| Schematic Create Time | 10:43:26
| Schematic Modify Time | 11:20:46
| Schematic Page Count | 0
| Schematic Page Number | 0
| Page Size | A
| Page Create Date | Thursday, February 26, 2026
| Page Modify Date | Tuesday, March 03, 2026
| Page Create Time | 10:45:37
| Page Modify Time | 11:14:38

TitleBlock0 : TitleBlock0

Source Library | C:\CADENCE\SPB_22.1\TOOLS\CAPTURE\LIBRARY\CAPSYM.OLB
Source Symbol | TitleBlock0
Page Name | S1_POWER_TREE
Doc
Page Number | 1
Page Count | 1

Object | Property Name | Property Value
INS11412 : U1 | Name | INS11412
| ID | 579
| Reference | U1
| Designator
| Part Reference | U1
| Value | PMIC-XC6206P
| Primitive | DEFAULT
| Implementation Type | <none>
| Implementation
| Implementation Path
| PCB Footprint | SOT-23
| OriginalSymbolOrigin | (-40000,20000)
Object | Property Name | Property Value
VSS : U1/VSS | Name | VSS
| Number | 1
| Swap Id | -1
| Type | Output
| Net Name | GND
| Order | 0
| Is No Connect | False
Object | Property Name | Property Value
VOUT : U1/VOUT | Name | VOUT
| Number | 2
| Swap Id | -1
| Type | Output
| Net Name | N12343
| Order | 1
| Is No Connect | False
Object | Property Name | Property Value
VIN : U1/VIN | Name | VIN
| Number | 3
| Swap Id | -1
| Type | Input
| Net Name | V5_IN
| Order | 2
| Is No Connect | False
Object | Property Name | Property Value
INS11789 : C4 | Name | INS11789
| ID | 597
| Reference | C4
| Designator
| Part Reference | C4
| Value | 0.1uf
| Primitive | DEFAULT
| Implementation Type | <none>
| Implementation
| Implementation Path
| PCB Footprint | CAPC2012X94N
| OriginalSymbolOrigin | (0,10000)

Object | Property Name | Property Value
1 : C4/1 | Name | 1
| Number | 1
| Swap Id | -1
| Type | Passive
| Net Name | GND
| Order | 0
| Is No Connect | False
Object | Property Name | Property Value
2 : C4/2 | Name | 2
| Number | 2
| Swap Id | -1
| Type | Passive
| Net Name | V3V3_SYS
| Order | 1
| Is No Connect | False
Object | Property Name | Property Value
INS12657 : C6 | Name | INS12657
| ID | 619
| Reference | C6
| Designator
| Part Reference | C6
| Value | 0.1uf
| Primitive | DEFAULT
| Implementation Type | <none>
| Implementation
| Implementation Path
| PCB Footprint | CAPC2012X94N
| OriginalSymbolOrigin | (0,10000)
Object | Property Name | Property Value
1 : C6/1 | Name | 1
| Number | 1
| Swap Id | -1
| Type | Passive
| Net Name | V3V3_SYS
| Order | 0
| Is No Connect | False
Object | Property Name | Property Value
2 : C6/2 | Name | 2
| Number | 2
| Swap Id | -1
| Type | Passive
| Net Name | V3V3_CAM
| Order | 1
| Is No Connect | False

Object | Property Name | Property Value
INS36851 : TP4 | Name | INS36851
| ID | 1146
| Reference | TP4
| Designator
| Part Reference | TP4
| Value | TP_V2V8_CAM
| Primitive | DEFAULT
| Implementation Type | <none>
| Implementation
| Implementation Path
| PCB Footprint
Object | Property Name | Property Value
1 : TP4/1 | Name | 1
| Number | 1
| Swap Id | -1
| Type | Passive
| Net Name | V2V8_CAM
| Order | 0
| Is No Connect | False
Object | Property Name | Property Value
INS11519 : C2 | Name | INS11519
| ID | 588
| Reference | C2
| Designator
| Part Reference | C2
| Value | 10uf
| Primitive | DEFAULT
| Implementation Type | <none>
| Implementation
| Implementation Path
| PCB Footprint | CAPC2012X94N
| OriginalSymbolOrigin | (0,10000)
Object | Property Name | Property Value
1 : C2/1 | Name | 1
| Number | 1
| Swap Id | -1
| Type | Passive
| Net Name | V5_IN
| Order | 0
| Is No Connect | False
Object | Property Name | Property Value
2 : C2/2 | Name | 2
| Number | 2
| Swap Id | -1
| Type | Passive
| Net Name | GND
| Order | 1
| Is No Connect | False

Object | Property Name | Property Value
INS11503 : C1 | Name | INS11503
| ID | 585
| Reference | C1
| Designator
| Part Reference | C1
| Value | 10uf
| Primitive | DEFAULT
| Implementation Type | <none>
| Implementation
| Implementation Path
| PCB Footprint | CAPC2012X94N
| OriginalSymbolOrigin | (0,10000)
Object | Property Name | Property Value
1 : C1/1 | Name | 1
| Number | 1
| Swap Id | -1
| Type | Passive
| Net Name | GND
| Order | 0
| Is No Connect | False
Object | Property Name | Property Value
2 : C1/2 | Name | 2
| Number | 2
| Swap Id | -1
| Type | Passive
| Net Name | V3V3_SYS
| Order | 1
| Is No Connect | False
Object | Property Name | Property Value
INS12268 : R2 | Name | INS12268
| ID | 607
| Reference | R2
| Designator
| Part Reference | R2
| Value | 0 ohm
| Primitive | DEFAULT
| Implementation Type | Schematic View
| Implementation | RC0805JR-070RL
| Implementation Path
| PCB Footprint | RC0805N_YAG
| Description | RES, 0, 5p, 0.125 W, 0805
| Manufacturer_Part_Number | RC0805JR-070RL
| Manufacturer_Name | Yageo
| Copyright | Copyright (C) 2026 Ultra Librarian. All rights reserved.

Object | Property Name | Property Value
1 : R2/1 | Name | 1
| Number | 1
| Swap Id | -1
| Type | Passive
| Net Name | V3V3_SYS
| Order | 0
| Is No Connect | False
Object | Property Name | Property Value
2 : R2/2 | Name | 2
| Number | 2
| Swap Id | -1
| Type | Passive
| Net Name | N12343
| Order | 1
| Is No Connect | False
Object | Property Name | Property Value
INS13269 : U2 | Name | INS13269
| ID | 627
| Reference | U2
| Designator
| Part Reference | U2
| Value | 2.8V
| Primitive | DEFAULT
| Implementation Type | <none>
| Implementation
| Implementation Path
| PCB Footprint | SOT-23
| OriginalSymbolOrigin | (-40000,20000)
Object | Property Name | Property Value
VSS : U2/VSS | Name | VSS
| Number | 1
| Swap Id | -1
| Type | Output
| Net Name | GND
| Order | 0
| Is No Connect | False
Object | Property Name | Property Value
VOUT : U2/VOUT | Name | VOUT
| Number | 2
| Swap Id | -1
| Type | Output
| Net Name | V2V8_CAM
| Order | 1
| Is No Connect | False

Object | Property Name | Property Value
VIN : U2/VIN | Name | VIN
| Number | 3
| Swap Id | -1
| Type | Input
| Net Name | V3V3_CAM
| Order | 2
| Is No Connect | False
Object | Property Name | Property Value
INS13610 : U3 | Name | INS13610
| ID | 640
| Reference | U3
| Designator
| Part Reference | U3
| Value | 1.2V
| Primitive | DEFAULT
| Implementation Type | <none>
| Implementation
| Implementation Path
| PCB Footprint | SOT-23
| OriginalSymbolOrigin | (-40000,20000)
Object | Property Name | Property Value
VSS : U3/VSS | Name | VSS
| Number | 1
| Swap Id | -1
| Type | Output
| Net Name | GND
| Order | 0
| Is No Connect | False
Object | Property Name | Property Value
VOUT : U3/VOUT | Name | VOUT
| Number | 2
| Swap Id | -1
| Type | Output
| Net Name | V1V2_CAM
| Order | 1
| Is No Connect | False
Object | Property Name | Property Value
VIN : U3/VIN | Name | VIN
| Number | 3
| Swap Id | -1
| Type | Input
| Net Name | V3V3_CAM
| Order | 2
| Is No Connect | False

Object | Property Name | Property Value
INS14175 : C12 | Name | INS14175
| ID | 660
| Reference | C12
| Designator
| Part Reference | C12
| Value | 4.7 uf
| Primitive | DEFAULT
| Implementation Type | <none>
| Implementation
| Implementation Path
| PCB Footprint | CAPC2012X94N
| OriginalSymbolOrigin | (0,10000)
Object | Property Name | Property Value
1 : C12/1 | Name | 1
| Number | 1
| Swap Id | -1
| Type | Passive
| Net Name | V3V3_CAM
| Order | 0
| Is No Connect | False
Object | Property Name | Property Value
2 : C12/2 | Name | 2
| Number | 2
| Swap Id | -1
| Type | Passive
| Net Name | GND
| Order | 1
| Is No Connect | False
Object | Property Name | Property Value
INS14091 : C11 | Name | INS14091
| ID | 657
| Reference | C11
| Designator
| Part Reference | C11
| Value | 4.7 uf
| Primitive | DEFAULT
| Implementation Type | <none>
| Implementation
| Implementation Path
| PCB Footprint | CAPC2012X94N
| OriginalSymbolOrigin | (0,10000)
Object | Property Name | Property Value
1 : C11/1 | Name | 1
| Number | 1
| Swap Id | -1
| Type | Passive
| Net Name | V3V3_CAM
| Order | 0
| Is No Connect | False

Object | Property Name | Property Value
2 : C11/2 | Name | 2
| Number | 2
| Swap Id | -1
| Type | Passive
| Net Name
| Order | 1
| Is No Connect | False
Object | Property Name | Property Value
INS36873 : TP5 | Name | INS36873
| ID | 1148
| Reference | TP5
| Designator
| Part Reference | TP5
| Value | TP_V1V2_CAM
| Primitive | DEFAULT
| Implementation Type | <none>
| Implementation
| Implementation Path
| PCB Footprint
Object | Property Name | Property Value
1 : TP5/1 | Name | 1
| Number | 1
| Swap Id | -1
| Type | Passive
| Net Name | V1V2_CAM
| Order | 0
| Is No Connect | False
Object | Property Name | Property Value
INS11763 : C3 | Name | INS11763
| ID | 594
| Reference | C3
| Designator
| Part Reference | C3
| Value | 0.1uf
| Primitive | DEFAULT
| Implementation Type | <none>
| Implementation
| Implementation Path
| PCB Footprint | CAPC2012X94N
| OriginalSymbolOrigin | (0,10000)
Object | Property Name | Property Value
1 : C3/1 | Name | 1
| Number | 1
| Swap Id | -1
| Type | Passive
| Net Name | V5_IN
| Order | 0
| Is No Connect | False

Object | Property Name | Property Value
2 : C3/2 | Name | 2
| Number | 2
| Swap Id | -1
| Type | Passive
| Net Name | GND
| Order | 1
| Is No Connect | False
Object | Property Name | Property Value
INS36807 : TP2 | Name | INS36807
| ID | 1142
| Reference | TP2
| Designator
| Part Reference | TP2
| Value | TP_V3V3_SYS
| Primitive | DEFAULT
| Implementation Type | <none>
| Implementation
| Implementation Path
| PCB Footprint
Object | Property Name | Property Value
1 : TP2/1 | Name | 1
| Number | 1
| Swap Id | -1
| Type | Passive
| Net Name | V3V3_SYS
| Order | 0
| Is No Connect | False
Object | Property Name | Property Value
INS12631 : C5 | Name | INS12631
| ID | 616
| Reference | C5
| Designator
| Part Reference | C5
| Value | 4.7 uf
| Primitive | DEFAULT
| Implementation Type | <none>
| Implementation
| Implementation Path
| PCB Footprint | CAPC2012X94N
| OriginalSymbolOrigin | (0,10000)
Object | Property Name | Property Value
1 : C5/1 | Name | 1
| Number | 1
| Swap Id | -1
| Type | Passive
| Net Name | V3V3_SYS
| Order | 0
| Is No Connect | False

Object | Property Name | Property Value
2 : C5/2 | Name | 2
| Number | 2
| Swap Id | -1
| Type | Passive
| Net Name | V3V3_CAM
| Order | 1
| Is No Connect | False
Object | Property Name | Property Value
INS13416 : C8 | Name | INS13416
| ID | 635
| Reference | C8
| Designator
| Part Reference | C8
| Value | 0.1uf
| Primitive | DEFAULT
| Implementation Type | <none>
| Implementation
| Implementation Path
| PCB Footprint | CAPC2012X94N
| OriginalSymbolOrigin | (0,10000)
Object | Property Name | Property Value
1 : C8/1 | Name | 1
| Number | 1
| Swap Id | -1
| Type | Passive
| Net Name | GND
| Order | 0
| Is No Connect | False
Object | Property Name | Property Value
2 : C8/2 | Name | 2
| Number | 2
| Swap Id | -1
| Type | Passive
| Net Name | V2V8_CAM
| Order | 1
| Is No Connect | False
Object | Property Name | Property Value
INS36895 : TP6 | Name | INS36895
| ID | 1150
| Reference | TP6
| Designator
| Part Reference | TP6
| Value | TP_GND
| Primitive | DEFAULT
| Implementation Type | <none>
| Implementation
| Implementation Path
| PCB Footprint

Object | Property Name | Property Value
1 : TP6/1 | Name | 1
| Number | 1
| Swap Id | -1
| Type | Passive
| Net Name | GND
| Order | 0
| Is No Connect | False
Object | Property Name | Property Value
INS13400 : C7 | Name | INS13400
| ID | 632
| Reference | C7
| Designator
| Part Reference | C7
| Value | 4.7 uf
| Primitive | DEFAULT
| Implementation Type | <none>
| Implementation
| Implementation Path
| PCB Footprint | CAPC2012X94N
| OriginalSymbolOrigin | (0,10000)
Object | Property Name | Property Value
1 : C7/1 | Name | 1
| Number | 1
| Swap Id | -1
| Type | Passive
| Net Name | GND
| Order | 0
| Is No Connect | False
Object | Property Name | Property Value
2 : C7/2 | Name | 2
| Number | 2
| Swap Id | -1
| Type | Passive
| Net Name | V2V8_CAM
| Order | 1
| Is No Connect | False
Object | Property Name | Property Value
INS12482 : L1 | Name | INS12482
| ID | 611
| Reference | L1
| Designator
| Part Reference | L1
| Value | B82477R4154M100
| Primitive | DEFAULT
| Implementation Type | <none>
| Implementation
| Implementation Path
| PCB Footprint | IND_B82477R4154M100
| OriginalSymbolOrigin | (-30000,10000)

Object | Property Name | Property Value
1 : L1/1 | Name | 1
| Number | 1
| Swap Id | -1
| Type | Passive
| Net Name | V3V3_SYS
| Order | 0
| Is No Connect | False
Object | Property Name | Property Value
2 : L1/2 | Name | 2
| Number | 2
| Swap Id | -1
| Type | Passive
| Net Name | V3V3_CAM
| Order | 1
| Is No Connect | False
Object | Property Name | Property Value
INS13842 : C10 | Name | INS13842
| ID | 650
| Reference | C10
| Designator
| Part Reference | C10
| Value | 0.1uf
| Primitive | DEFAULT
| Implementation Type | <none>
| Implementation
| Implementation Path
| PCB Footprint | CAPC2012X94N
| OriginalSymbolOrigin | (0,10000)
Object | Property Name | Property Value
1 : C10/1 | Name | 1
| Number | 1
| Swap Id | -1
| Type | Passive
| Net Name | GND
| Order | 0
| Is No Connect | False
Object | Property Name | Property Value
2 : C10/2 | Name | 2
| Number | 2
| Swap Id | -1
| Type | Passive
| Net Name | V1V2_CAM
| Order | 1
| Is No Connect | False

Object | Property Name | Property Value
INS36829 : TP3 | Name | INS36829
| ID | 1144
| Reference | TP3
| Designator
| Part Reference | TP3
| Value | TP_V3V3_CAM
| Primitive | DEFAULT
| Implementation Type | <none>
| Implementation
| Implementation Path
| PCB Footprint
Object | Property Name | Property Value
1 : TP3/1 | Name | 1
| Number | 1
| Swap Id | -1
| Type | Passive
| Net Name | V3V3_CAM
| Order | 0
| Is No Connect | False
Object | Property Name | Property Value
INS35554 : TP1 | Name | INS35554
| ID | 1134
| Reference | TP1
| Designator
| Part Reference | TP1
| Value | TP_V5_IN
| Primitive | DEFAULT
| Implementation Type | <none>
| Implementation
| Implementation Path
| PCB Footprint
Object | Property Name | Property Value
1 : TP1/1 | Name | 1
| Number | 1
| Swap Id | -1
| Type | Passive
| Net Name | V5_IN
| Order | 0
| Is No Connect | False

Object | Property Name | Property Value
INS13810 : C9 | Name | INS13810
| ID | 647
| Reference | C9
| Designator
| Part Reference | C9
| Value | 4.7 uf
| Primitive | DEFAULT
| Implementation Type | <none>
| Implementation
| Implementation Path
| PCB Footprint | CAPC2012X94N
| OriginalSymbolOrigin | (0,10000)
Object | Property Name | Property Value
1 : C9/1 | Name | 1
| Number | 1
| Swap Id | -1
| Type | Passive
| Net Name | GND
| Order | 0
| Is No Connect | False
Object | Property Name | Property Value
2 : C9/2 | Name | 2
| Number | 2
| Swap Id | -1
| Type | Passive
| Net Name | V1V2_CAM
| Order | 1
| Is No Connect | False
