ctw-design-team/aiot-mask-de10-nano-v2/SCHEMATIC/PropS2_CAMERA_OV2640_FPC.pdf

Object | Property Name | Property Value
GND : GND (Wire ID = 15300 ) | Name | GND
Object | Property Name | Property Value
V2V8_CAM : V2V8_CAM (Wire ID = 15533 ) | Name | V2V8_CAM
Object | Property Name | Property Value
V2V8_CAM : V2V8_CAM (Wire ID = 15535 ) | Name | V2V8_CAM
Object | Property Name | Property Value
V2V8_CAM : V2V8_CAM (Wire ID = 15540 ) | Name | V2V8_CAM
Object | Property Name | Property Value
V2V8_CAM : V2V8_CAM (Wire ID = 15550 ) | Name | V2V8_CAM
Object | Property Name | Property Value
V2V8_CAM : V2V8_CAM (Wire ID = 15561 ) | Name | V2V8_CAM
Object | Property Name | Property Value
GND : GND (Wire ID = 15571 ) | Name | GND
Object | Property Name | Property Value
GND : GND (Wire ID = 15576 ) | Name | GND
Object | Property Name | Property Value
GND : GND (Wire ID = 15582 ) | Name | GND
Object | Property Name | Property Value
GND : GND (Wire ID = 15592 ) | Name | GND
Object | Property Name | Property Value
GND : GND (Wire ID = 15604 ) | Name | GND
Object | Property Name | Property Value
V1V2_CAM : V1V2_CAM (Wire ID = 15684 ) | Name | V1V2_CAM
Object | Property Name | Property Value
V1V2_CAM : V1V2_CAM (Wire ID = 15688 ) | Name | V1V2_CAM
Object | Property Name | Property Value
V1V2_CAM : V1V2_CAM (Wire ID = 15703 ) | Name | V1V2_CAM
Object | Property Name | Property Value
GND : GND (Wire ID = 15727 ) | Name | GND

Object | Property Name | Property Value
GND : GND (Wire ID = 15731 ) | Name | GND
Object | Property Name | Property Value
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
Object | Property Name | Property Value
N33833 : N33833 (Wire ID = 33835 ) | Name | N33833
Object | Property Name | Property Value
N33833 : N33833 (Wire ID = 33840 ) | Name | N33833
Object | Property Name | Property Value
GND : GND (Wire ID = 34032 ) | Name | GND

Object | Property Name | Property Value
GND : GND (Wire ID = 34034 ) | Name | GND
Object | Property Name | Property Value
V3V3_CAM : V3V3_CAM (Wire ID = 34063 ) | Name | V3V3_CAM
Object | Property Name | Property Value
CAM_SCCB_SDA : CAM_SCCB_SDA (Wire ID = 34370 )Name | | CAM_SCCB_SDA
Object | Property Name | Property Value
CAM_SCCB_SDA : CAM_SCCB_SDA (Wire ID = 34372 )Name | | CAM_SCCB_SDA
Object | Property Name | Property Value
V1V2_CAM : V1V2_CAM (Wire ID = 34476 ) | Name | V1V2_CAM
Object | Property Name | Property Value
CAM_PCLK : CAM_PCLK (Wire ID = 34520 ) | Name | CAM_PCLK
Object | Property Name | Property Value
CAM_D2 : CAM_D2 (Wire ID = 34576 ) | Name | CAM_D2
Object | Property Name | Property Value
CAM_D5 : CAM_D5 (Wire ID = 34729 ) | Name | CAM_D5
Object | Property Name | Property Value
CAM_D6 : CAM_D6 (Wire ID = 34739 ) | Name | CAM_D6
Object | Property Name | Property Value
CAM_D6 : CAM_D6 (Wire ID = 34741 ) | Name | CAM_D6
Object | Property Name | Property Value
CAM_XCLK : CAM_XCLK (Wire ID = 35250 ) | Name | CAM_XCLK
Object | Property Name | Property Value
GND : GND (Wire ID = 35479 ) | Name | GND
Object | Property Name | Property Value
GND : GND (Wire ID = 35483 ) | Name | GND
Object | Property Name | Property Value
GND : GND (Wire ID = 35485 ) | Name | GND
Object | Property Name | Property Value
GND : GND (Wire ID = 35513 ) | Name | GND

Object | Property Name | Property Value
GND : GND (Wire ID = 35515 ) | Name | GND
Object | Property Name | Property Value
CAM_HSYNC : CAM_HSYNC (Wire ID = 37246 ) | Name | CAM_HSYNC
Object | Property Name | Property Value
CAM_PCLK : CAM_PCLK (Wire ID = 37268 ) | Name | CAM_PCLK
Object | Property Name | Property Value
CAM_VSYNC : CAM_VSYNC (Wire ID = 37313 ) | Name | CAM_VSYNC
Object | Property Name | Property Value
CAM_XCLK : CAM_XCLK (Wire ID = 37362 ) | Name | CAM_XCLK
Object | Property Name | Property Value
GND | Name | GND
Source Library | C:\CADENCE\SPB_22.1\TOOLS\CAPTURE\LIBRARY\CAPSYM.OLB
Source Symbol | GND
Object | Property Name | Property Value
GND : | Name | GND
Source Library | C:\CADENCE\SPB_22.1\TOOLS\CAPTURE\LIBRARY\CAPSYM.OLB
Source Symbol | OFFPAGELEFT-L
Object | Property Name | Property Value
GND : | Name | GND
Source Library | C:\CADENCE\SPB_22.1\TOOLS\CAPTURE\LIBRARY\CAPSYM.OLB
Source Symbol | OFFPAGELEFT-L
Object | Property Name | Property Value
V3V3_CAM : | Name | V3V3_CAM
Source Library | C:\CADENCE\SPB_22.1\TOOLS\CAPTURE\LIBRARY\CAPSYM.OLB
Source Symbol | OFFPAGELEFT-L
Object | Property Name | Property Value
V2V8_CAM : | Name | V2V8_CAM
Source Library | C:\CADENCE\SPB_22.1\TOOLS\CAPTURE\LIBRARY\CAPSYM.OLB
Source Symbol | OFFPAGELEFT-L
Object | Property Name | Property Value
V1V2_CAM : | Name | V1V2_CAM
Source Library | C:\CADENCE\SPB_22.1\TOOLS\CAPTURE\LIBRARY\CAPSYM.OLB
Source Symbol | OFFPAGELEFT-L
Object | Property Name | Property Value
CAM_SCCB_SDA : | Name | CAM_SCCB_SDA
Source Library | C:\CADENCE\SPB_22.1\TOOLS\CAPTURE\LIBRARY\CAPSYM.OLB
Source Symbol | OFFPAGELEFT-L

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

Object | Property Name | Property Value
| Path Name | TitleBlock0
| Schematic Path | /
| ID | 1210
| Title | S2_CAMERA_OV2640
| RevCode
| Cage Code
| OrgName
| OrgAddr1
| OrgAddr2
| OrgAddr3
| OrgAddr4
| Name | TitleBlock0
| Design Name | 123456
| Design File Name | C:\2 3 2026\SCHEMATIC\123456.DSN
| Design Create Date | Thursday, February 26, 2026
| Design Modify Date | Tuesday, March 03, 2026
| Design Create Time | 10:43:25
| Design Modify Time | 11:20:44
| Schematic Name | SCHEMATIC1
| Schematic Create Date | Thursday, February 26, 2026
| Schematic Modify Date | Tuesday, March 03, 2026
| Schematic Create Time | 10:43:26
| Schematic Modify Time | 11:20:46
| Schematic Page Count | 0
| Schematic Page Number | 0
| Page Size | A
| Page Create Date | Thursday, February 26, 2026
| Page Modify Date | Tuesday, March 03, 2026
| Page Create Time | 10:43:25
| Page Modify Time | 11:20:44

TitleBlock0 : TitleBlock0

Source Library | C:\CADENCE\SPB_22.1\TOOLS\CAPTURE\LIBRARY\CAPSYM.OLB
Source Symbol | TitleBlock0
Page Name | S2_CAMERA_OV2640_FPC
Doc
Page Number | 1
Page Count | 1
Object | Property Name | Property Value
INS32919 : R22 | Name | INS32919
| ID | 1104
| Reference | R22
| Designator
| Part Reference | R22
| Value | 33 Ohm
| Primitive | DEFAULT
| Implementation Type | <none>
| Implementation
| Implementation Path
| PCB Footprint | R0603
| OriginalSymbolOrigin | (-15000,10000)

Object | Property Name | Property Value
1 : R22/1 | Name | 1
| Number | 1
| Swap Id | -1
| Type | Passive
| Net Name | CAM_D3
| Order | 0
| Is No Connect | False
Object | Property Name | Property Value
2 : R22/2 | Name | 2
| Number | 2
| Swap Id | -1
| Type | Passive
| Net Name | N33809
| Order | 1
| Is No Connect | False
Object | Property Name | Property Value
INS37172 : TP8 | Name | INS37172
| ID | 1157
| Reference | TP8
| Designator
| Part Reference | TP8
| Value | TP_VSYNC
| Primitive | DEFAULT
| Implementation Type | <none>
| Implementation
| Implementation Path
| PCB Footprint
Object | Property Name | Property Value
1 : TP8/1 | Name | 1
| Number | 1
| Swap Id | -1
| Type | Passive
| Net Name | CAM_VSYNC
| Order | 0
| Is No Connect | False
Object | Property Name | Property Value
INS32971 : R24 | Name | INS32971
| ID | 1110
| Reference | R24
| Designator
| Part Reference | R24
| Value | 33 Ohm
| Primitive | DEFAULT
| Implementation Type | <none>
| Implementation
| Implementation Path
| PCB Footprint | R0603
| OriginalSymbolOrigin | (-15000,10000)

Object | Property Name | Property Value
1 : R24/1 | Name | 1
| Number | 1
| Swap Id | -1
| Type | Passive
| Net Name | CAM_D2
| Order | 0
| Is No Connect | False
Object | Property Name | Property Value
2 : R24/2 | Name | 2
| Number | 2
| Swap Id | -1
| Type | Passive
| Net Name | N33833
| Order | 1
| Is No Connect | False
Object | Property Name | Property Value
INS17027 : R4 | Name | INS17027
| ID | 810
| Reference | R4
| Designator
| Part Reference | R4
| Value | 0 Ohm
| Primitive | DEFAULT
| Implementation Type | Schematic View
| Implementation | RC0805JR-070RL
| Implementation Path
| PCB Footprint | RC0805N_YAG
| Description | RES, 0, 5p, 0.125 W, 0805
| Manufacturer_Part_Number | RC0805JR-070RL
| Manufacturer_Name | Yageo
| Copyright | Copyright (C) 2026 Ultra Librarian. All rights reserved.
Object | Property Name | Property Value
1 : R4/1 | Name | 1
| Number | 1
| Swap Id | -1
| Type | Passive
| Net Name | N17349
| Order | 0
| Is No Connect | False
Object | Property Name | Property Value
2 : R4/2 | Name | 2
| Number | 2
| Swap Id | -1
| Type | Passive
| Net Name | CAM_PCLK
| Order | 1
| Is No Connect | False

Object | Property Name | Property Value
INS15668 : C16 | Name | INS15668
| ID | 775
| Reference | C16
| Designator
| Part Reference | C16
| Value | 4.7 uf
| Primitive | DEFAULT
| Implementation Type | <none>
| Implementation
| Implementation Path
| PCB Footprint | CAPC2012X94N
| OriginalSymbolOrigin | (0,10000)
Object | Property Name | Property Value
1 : C16/1 | Name | 1
| Number | 1
| Swap Id | -1
| Type | Passive
| Net Name | GND
| Order | 0
| Is No Connect | False
Object | Property Name | Property Value
2 : C16/2 | Name | 2
| Number | 2
| Swap Id | -1
| Type | Passive
| Net Name | V1V2_CAM
| Order | 1
| Is No Connect | False
Object | Property Name | Property Value
INS17011 : R3 | Name | INS17011
| ID | 807
| Reference | R3
| Designator
| Part Reference | R3
| Value | 0 Ohm
| Primitive | DEFAULT
| Implementation Type | Schematic View
| Implementation | RC0805JR-070RL
| Implementation Path
| PCB Footprint | RC0805N_YAG
| Description | RES, 0, 5p, 0.125 W, 0805
| Manufacturer_Part_Number | RC0805JR-070RL
| Manufacturer_Name | Yageo
| Copyright | Copyright (C) 2026 Ultra Librarian. All rights reserved.

Object | Property Name | Property Value
1 : R3/1 | Name | 1
| Number | 1
| Swap Id | -1
| Type | Passive
| Net Name | N17329
| Order | 0
| Is No Connect | False
Object | Property Name | Property Value
2 : R3/2 | Name | 2
| Number | 2
| Swap Id | -1
| Type | Passive
| Net Name | CAM_XCLK
| Order | 1
| Is No Connect | False
Object | Property Name | Property Value
INS15804 : C18 | Name | INS15804
| ID | 782
| Reference | C18
| Designator
| Part Reference | C18
| Value | 4.7 uf
| Primitive | DEFAULT
| Implementation Type | <none>
| Implementation
| Implementation Path
| PCB Footprint | CAPC2012X94N
| OriginalSymbolOrigin | (0,10000)
Object | Property Name | Property Value
1 : C18/1 | Name | 1
| Number | 1
| Swap Id | -1
| Type | Passive
| Net Name | V3V3_CAM
| Order | 0
| Is No Connect | False
Object | Property Name | Property Value
2 : C18/2 | Name | 2
| Number | 2
| Swap Id | -1
| Type | Passive
| Net Name | GND
| Order | 1
| Is No Connect | False

Object | Property Name | Property Value
INS15161 : J1 | Name | INS15161
| ID | 731
| Reference | J1
| Designator
| Part Reference | J1
| Value | 2-1734839-4
| Primitive | DEFAULT
| Implementation Type | <none>
| Implementation
| Implementation Path
| PCB Footprint | TE_2-1734839-4
| OriginalSymbolOrigin | (-40000,130000)
Object | Property Name | Property Value
SHIELD : J1/SHIELD | Name | SHIELD
| Number | SH1
| Swap Id | -1
| Type | Passive
| Net Name | GND
| Order | 0
| Is No Connect | True
Object | Property Name | Property Value
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
INS32893 : R21 | Name | INS32893
| ID | 1101
| Reference | R21
| Designator
| Part Reference | R21
| Value | 33 Ohm
| Primitive | DEFAULT
| Implementation Type | <none>
| Implementation
| Implementation Path
| PCB Footprint | R0603
| OriginalSymbolOrigin | (-15000,10000)

Object | Property Name | Property Value
1 : R21/1 | Name | 1
| Number | 1
| Swap Id | -1
| Type | Passive
| Net Name | CAM_D0
| Order | 0
| Is No Connect | False
Object | Property Name | Property Value
2 : R21/2 | Name | 2
| Number | 2
| Swap Id | -1
| Type | Passive
| Net Name | N33780
| Order | 1
| Is No Connect | False
Object | Property Name | Property Value
INS32945 : R23 | Name | INS32945
| ID | 1107
| Reference | R23
| Designator
| Part Reference | R23
| Value | 33 Ohm
| Primitive | DEFAULT
| Implementation Type | <none>
| Implementation
| Implementation Path
| PCB Footprint | R0603
| OriginalSymbolOrigin | (-15000,10000)
Object | Property Name | Property Value
1 : R23/1 | Name | 1
| Number | 1
| Swap Id | -1
| Type | Passive
| Net Name | CAM_D1
| Order | 0
| Is No Connect | False
Object | Property Name | Property Value
2 : R23/2 | Name | 2
| Number | 2
| Swap Id | -1
| Type | Passive
| Net Name | N33821
| Order | 1
| Is No Connect | False

Object | Property Name | Property Value
INS15487 : C13 | Name | INS15487
| ID | 767
| Reference | C13
| Designator
| Part Reference | C13
| Value | 4.7 uf
| Primitive | DEFAULT
| Implementation Type | <none>
| Implementation
| Implementation Path
| PCB Footprint | CAPC2012X94N
| OriginalSymbolOrigin | (0,10000)
Object | Property Name | Property Value
1 : C13/1 | Name | 1
| Number | 1
| Swap Id | -1
| Type | Passive
| Net Name | GND
| Order | 0
| Is No Connect | False
Object | Property Name | Property Value
2 : C13/2 | Name | 2
| Number | 2
| Swap Id | -1
| Type | Passive
| Net Name | V2V8_CAM
| Order | 1
| Is No Connect | False
Object | Property Name | Property Value
INS37216 : TP10 | Name | INS37216
| ID | 1161
| Reference | TP10
| Designator
| Part Reference | TP10
| Value | TP_PCLK
| Primitive | DEFAULT
| Implementation Type | <none>
| Implementation
| Implementation Path
| PCB Footprint
Object | Property Name | Property Value
1 : TP10/1 | Name | 1
| Number | 1
| Swap Id | -1
| Type | Passive
| Net Name | CAM_PCLK
| Order | 0
| Is No Connect | False

Object | Property Name | Property Value
INS15778 : C17 | Name | INS15778
| ID | 779
| Reference | C17
| Designator
| Part Reference | C17
| Value | 0.1uf
| Primitive | DEFAULT
| Implementation Type | <none>
| Implementation
| Implementation Path
| PCB Footprint | CAPC2012X94N
| OriginalSymbolOrigin | (0,10000)
Object | Property Name | Property Value
1 : C17/1 | Name | 1
| Number | 1
| Swap Id | -1
| Type | Passive
| Net Name | V3V3_CAM
| Order | 0
| Is No Connect | False
Object | Property Name | Property Value
2 : C17/2 | Name | 2
| Number | 2
| Swap Id | -1
| Type | Passive
| Net Name | GND
| Order | 1
| Is No Connect | False
Object | Property Name | Property Value
INS15642 : C15 | Name | INS15642
| ID | 772
| Reference | C15
| Designator
| Part Reference | C15
| Value | 0.1uf
| Primitive | DEFAULT
| Implementation Type | <none>
| Implementation
| Implementation Path
| PCB Footprint | CAPC2012X94N
| OriginalSymbolOrigin | (0,10000)
Object | Property Name | Property Value
1 : C15/1 | Name | 1
| Number | 1
| Swap Id | -1
| Type | Passive
| Net Name | GND
| Order | 0
| Is No Connect | False

Object | Property Name | Property Value
2 : C15/2 | Name | 2
| Number | 2
| Swap Id | -1
| Type | Passive
| Net Name | V1V2_CAM
| Order | 1
| Is No Connect | False
Object | Property Name | Property Value
INS15507 : C14 | Name | INS15507
| ID | 764
| Reference | C14
| Designator
| Part Reference | C14
| Value | 0.1uf
| Primitive | DEFAULT
| Implementation Type | <none>
| Implementation
| Implementation Path
| PCB Footprint | CAPC2012X94N
| OriginalSymbolOrigin | (0,10000)
Object | Property Name | Property Value
1 : C14/1 | Name | 1
| Number | 1
| Swap Id | -1
| Type | Passive
| Net Name | GND
| Order | 0
| Is No Connect | False
Object | Property Name | Property Value
2 : C14/2 | Name | 2
| Number | 2
| Swap Id | -1
| Type | Passive
| Net Name | V2V8_CAM
| Order | 1
| Is No Connect | False
Object | Property Name | Property Value
INS32815 : R18 | Name | INS32815
| ID | 1092
| Reference | R18
| Designator
| Part Reference | R18
| Value | 33 Ohm
| Primitive | DEFAULT
| Implementation Type | <none>
| Implementation
| Implementation Path
| PCB Footprint | R0603
| OriginalSymbolOrigin | (-15000,10000)

Object | Property Name | Property Value
1 : R18/1 | Name | 1
| Number | 1
| Swap Id | -1
| Type | Passive
| Net Name | CAM_D6
| Order | 0
| Is No Connect | False
Object | Property Name | Property Value
2 : R18/2 | Name | 2
| Number | 2
| Swap Id | -1
| Type | Passive
| Net Name | N33743
| Order | 1
| Is No Connect | False
Object | Property Name | Property Value
INS32867 : R20 | Name | INS32867
| ID | 1098
| Reference | R20
| Designator
| Part Reference | R20
| Value | 33 Ohm
| Primitive | DEFAULT
| Implementation Type | <none>
| Implementation
| Implementation Path
| PCB Footprint | R0603
| OriginalSymbolOrigin | (-15000,10000)
Object | Property Name | Property Value
1 : R20/1 | Name | 1
| Number | 1
| Swap Id | -1
| Type | Passive
| Net Name | CAM_D4
| Order | 0
| Is No Connect | False
Object | Property Name | Property Value
2 : R20/2 | Name | 2
| Number | 2
| Swap Id | -1
| Type | Passive
| Net Name | N33771
| Order | 1
| Is No Connect | False
