ctw-design-team/aiot-mask-de10-nano-v2/SCHEMATIC/PropS3_SCCB_LEVEL_SHIFTER.pdf

Object | Property Name | Property Value
V2V8_CAM : V2V8_CAM (Wire ID = 17898 ) | Name | V2V8_CAM
Object | Property Name | Property Value
V2V8_CAM : V2V8_CAM (Wire ID = 17902 ) | Name | V2V8_CAM
Object | Property Name | Property Value
V2V8_CAM : V2V8_CAM (Wire ID = 17904 ) | Name | V2V8_CAM
Object | Property Name | Property Value
V2V8_CAM : V2V8_CAM (Wire ID = 18082 ) | Name | V2V8_CAM
Object | Property Name | Property Value
V2V8_CAM : V2V8_CAM (Wire ID = 18086 ) | Name | V2V8_CAM
Object | Property Name | Property Value
CAM_SCCB_SCL : CAM_SCCB_SCL (Wire ID = 18115 )Name | | CAM_SCCB_SCL
Object | Property Name | Property Value
CAM_SCCB_SCL : CAM_SCCB_SCL (Wire ID = 18117 )Name | | CAM_SCCB_SCL
Object | Property Name | Property Value
CAM_SIOD : CAM_SIOD (Wire ID = 18126 ) | Name | CAM_SIOD
Object | Property Name | Property Value
CAM_SIOD : CAM_SIOD (Wire ID = 18128 ) | Name | CAM_SIOD
Object | Property Name | Property Value
CAM_SIOC : CAM_SIOC (Wire ID = 18151 ) | Name | CAM_SIOC
Object | Property Name | Property Value
CAM_SCCB_SDA : CAM_SCCB_SDA (Wire ID = 18159 )Name | | CAM_SCCB_SDA
Object | Property Name | Property Value
CAM_SCCB_SCL : CAM_SCCB_SCL (Wire ID = 18299 )Name | | CAM_SCCB_SCL
Object | Property Name | Property Value
CAM_SCCB_SDA : CAM_SCCB_SDA (Wire ID = 18333 )Name | | CAM_SCCB_SDA
Object | Property Name | Property Value
CAM_SCCB_SDA : CAM_SCCB_SDA (Wire ID = 18337 )Name | | CAM_SCCB_SDA
Object | Property Name | Property Value
CAM_SCCB_SDA : CAM_SCCB_SDA (Wire ID = 18343 )Name | | CAM_SCCB_SDA

Object | Property Name | Property Value
CAM_SCCB_SDA : CAM_SCCB_SDA (Wire ID = 18345 )Name | | CAM_SCCB_SDA
Object | Property Name | Property Value
V3V3_SYS : V3V3_SYS (Wire ID = 18370 ) | Name | V3V3_SYS
Object | Property Name | Property Value
V3V3_SYS : V3V3_SYS (Wire ID = 18391 ) | Name | V3V3_SYS
Object | Property Name | Property Value
V2V8_CAM : V2V8_CAM (Wire ID = 18459 ) | Name | V2V8_CAM
Object | Property Name | Property Value
CAM_SIOD : CAM_SIOD (Wire ID = 18470 ) | Name | CAM_SIOD
Object | Property Name | Property Value
CAM_SIOD : CAM_SIOD (Wire ID = 18474 ) | Name | CAM_SIOD
Object | Property Name | Property Value
V2V8_CAM : V2V8_CAM (Wire ID = 18528 ) | Name | V2V8_CAM
Object | Property Name | Property Value
CAM_SIOC : CAM_SIOC (Wire ID = 18554 ) | Name | CAM_SIOC
Object | Property Name | Property Value
CAM_SIOC : CAM_SIOC (Wire ID = 18556 ) | Name | CAM_SIOC
Object | Property Name | Property Value
CAM_SIOC : CAM_SIOC (Wire ID = 18560 ) | Name | CAM_SIOC
Object | Property Name | Property Value
CAM_SCCB_SCL : CAM_SCCB_SCL (Wire ID = 39867 )Name | | CAM_SCCB_SCL
Object | Property Name | Property Value
TP_CAM_SCCB_SDA : TP_CAM_SCCB_SDA (Wire ID = 39893 ) Name | | TP_CAM_SCCB_SDA
Object | Property Name | Property Value
CAM_SIOC : CAM_SIOC (Wire ID = 39909 ) | Name | CAM_SIOC
Object | Property Name | Property Value
CAM_SIOD : CAM_SIOD (Wire ID = 39921 ) | Name | CAM_SIOD
Object | Property Name | Property Value
V2V8_CAM : | Name | V2V8_CAM
Source Library | C:\CADENCE\SPB_22.1\TOOLS\CAPTURE\LIBRARY\CAPSYM.OLB
Source Symbol | OFFPAGELEFT-L

Object | Property Name | Property Value
CAM_SCCB_SDA : | Name | CAM_SCCB_SDA
Source Library | C:\CADENCE\SPB_22.1\TOOLS\CAPTURE\LIBRARY\CAPSYM.OLB
Source Symbol | OFFPAGELEFT-L
Object | Property Name | Property Value
CAM_SIOD : | Name | CAM_SIOD
Source Library | C:\CADENCE\SPB_22.1\TOOLS\CAPTURE\LIBRARY\CAPSYM.OLB
Source Symbol | OFFPAGELEFT-L
Object | Property Name | Property Value
CAM_SIOC : | Name | CAM_SIOC
Source Library | C:\CADENCE\SPB_22.1\TOOLS\CAPTURE\LIBRARY\CAPSYM.OLB
Source Symbol | OFFPAGELEFT-L
Object | Property Name | Property Value
CAM_SCCB_SCL : | Name | CAM_SCCB_SCL
Source Library | C:\CADENCE\SPB_22.1\TOOLS\CAPTURE\LIBRARY\CAPSYM.OLB
Source Symbol | OFFPAGELEFT-L
Object | Property Name | Property Value
V3V3_SYS : | Name | V3V3_SYS
Source Library | C:\CADENCE\SPB_22.1\TOOLS\CAPTURE\LIBRARY\CAPSYM.OLB
Source Symbol | OFFPAGELEFT-L
Object | Property Name | Property Value
V3V3_SYS : | Name | V3V3_SYS
Source Library | C:\CADENCE\SPB_22.1\TOOLS\CAPTURE\LIBRARY\CAPSYM.OLB
Source Symbol | OFFPAGELEFT-L
Object | Property Name | Property Value
V2V8_CAM : | Name | V2V8_CAM
Source Library | C:\CADENCE\SPB_22.1\TOOLS\CAPTURE\LIBRARY\CAPSYM.OLB
Source Symbol | OFFPAGELEFT-L
Object | Property Name | Property Value
V2V8_CAM : | Name | V2V8_CAM
Source Library | C:\CADENCE\SPB_22.1\TOOLS\CAPTURE\LIBRARY\CAPSYM.OLB
Source Symbol | OFFPAGELEFT-L
Object | Property Name | Property Value
TP_CAM_SCCB_SCL : | Name | TP_CAM_SCCB_SCL
Source Library | C:\CADENCE\SPB_22.1\TOOLS\CAPTURE\LIBRARY\CAPSYM.OLB
Source Symbol | OFFPAGELEFT-L
Object | Property Name | Property Value
TP_CAM_SCCB_SDA : | Name | TP_CAM_SCCB_SDA
Source Library | C:\CADENCE\SPB_22.1\TOOLS\CAPTURE\LIBRARY\CAPSYM.OLB
Source Symbol | OFFPAGELEFT-L

Object | Property Name | Property Value
TP_CAM_SIOC : | Name | TP_CAM_SIOC
Source Library | C:\CADENCE\SPB_22.1\TOOLS\CAPTURE\LIBRARY\CAPSYM.OLB
Source Symbol | OFFPAGELEFT-L
Object | Property Name | Property Value
TP_CAM_SIOD : | Name | TP_CAM_SIOD
Source Library | C:\CADENCE\SPB_22.1\TOOLS\CAPTURE\LIBRARY\CAPSYM.OLB
Source Symbol | OFFPAGELEFT-L
Object | Property Name | Property Value
| Path Name | TitleBlock0
| Schematic Path | /
| ID | 520
| Title | S3_SCCB_LEVEL_SHIFTER
| OrgAddr4
| OrgAddr3
| OrgAddr2
| OrgAddr1
| OrgName
| Cage Code
| RevCode
| Name | TitleBlock0
| Design Name | 123456
| Design File Name | C:\2 3 2026\SCHEMATIC\123456.DSN
| Design Create Date | Thursday, February 26, 2026
| Design Modify Date | Tuesday, March 03, 2026
| Design Create Time | 10:43:25
| Design Modify Time | 11:20:44
| Schematic Name | SCHEMATIC1
| Schematic Create Date | Thursday, February 26, 2026
| Schematic Modify Date | Tuesday, March 03, 2026
| Schematic Create Time | 10:43:26
| Schematic Modify Time | 11:20:46
| Schematic Page Count | 0
| Schematic Page Number | 0
| Page Size | A
| Page Create Date | Sunday, March 01, 2026
| Page Modify Date | Tuesday, March 03, 2026
| Page Create Time | 17:31:16
| Page Modify Time | 10:43:29

TitleBlock0 : TitleBlock0

Source Library | C:\CADENCE\SPB_22.1\TOOLS\CAPTURE\LIBRARY\CAPSYM.OLB
Source Symbol | TitleBlock0
Page Name | S3_SCCB_LEVEL_SHIFTER
Doc
Page Number | 1
Page Count | 1

Object | Property Name | Property Value
INS18435 : R7 | Name | INS18435
| ID | 854
| Reference | R7
| Designator
| Part Reference | R7
| Value | 2K2
| Primitive | DEFAULT
| Implementation Type | Schematic View
| Implementation | RC0805JR-070RL
| Implementation Path
| PCB Footprint | RC0805N_YAG
| Description | RES, 0, 5p, 0.125 W, 0805
| Manufacturer_Part_Number | RC0805JR-070RL
| Manufacturer_Name | Yageo
| Copyright | Copyright (C) 2026 Ultra Librarian. All rights reserved.
Object | Property Name | Property Value
1 : R7/1 | Name | 1
| Number | 1
| Swap Id | -1
| Type | Passive
| Net Name | CAM_SIOD
| Order | 0
| Is No Connect | False
Object | Property Name | Property Value
2 : R7/2 | Name | 2
| Number | 2
| Swap Id | -1
| Type | Passive
| Net Name | V2V8_CAM
| Order | 1
| Is No Connect | False
Object | Property Name | Property Value
INS18283 : R5 | Name | INS18283
| ID | 845
| Reference | R5
| Designator
| Part Reference | R5
| Value | 2K2
| Primitive | DEFAULT
| Implementation Type | Schematic View
| Implementation | RC0805JR-070RL
| Implementation Path
| PCB Footprint | RC0805N_YAG
| Description | RES, 0, 5p, 0.125 W, 0805
| Manufacturer_Part_Number | RC0805JR-070RL
| Manufacturer_Name | Yageo
| Copyright | Copyright (C) 2026 Ultra Librarian. All rights reserved.

Object | Property Name | Property Value
1 : R5/1 | Name | 1
| Number | 1
| Swap Id | -1
| Type | Passive
| Net Name | CAM_SCCB_SCL
| Order | 0
| Is No Connect | False
Object | Property Name | Property Value
2 : R5/2 | Name | 2
| Number | 2
| Swap Id | -1
| Type | Passive
| Net Name | V3V3_SYS
| Order | 1
| Is No Connect | False
Object | Property Name | Property Value
INS18317 : R6 | Name | INS18317
| ID | 848
| Reference | R6
| Designator
| Part Reference | R6
| Value | 2K2
| Primitive | DEFAULT
| Implementation Type | Schematic View
| Implementation | RC0805JR-070RL
| Implementation Path
| PCB Footprint | RC0805N_YAG
| Description | RES, 0, 5p, 0.125 W, 0805
| Manufacturer_Part_Number | RC0805JR-070RL
| Manufacturer_Name | Yageo
| Copyright | Copyright (C) 2026 Ultra Librarian. All rights reserved.
Object | Property Name | Property Value
1 : R6/1 | Name | 1
| Number | 1
| Swap Id | -1
| Type | Passive
| Net Name | V3V3_SYS
| Order | 0
| Is No Connect | False
Object | Property Name | Property Value
2 : R6/2 | Name | 2
| Number | 2
| Swap Id | -1
| Type | Passive
| Net Name | CAM_SCCB_SDA
| Order | 1
| Is No Connect | False

Object | Property Name | Property Value
INS18510 : R8 | Name | INS18510
| ID | 857
| Reference | R8
| Designator
| Part Reference | R8
| Value | 2K2
| Primitive | DEFAULT
| Implementation Type | Schematic View
| Implementation | RC0805JR-070RL
| Implementation Path
| PCB Footprint | RC0805N_YAG
| Description | RES, 0, 5p, 0.125 W, 0805
| Manufacturer_Part_Number | RC0805JR-070RL
| Manufacturer_Name | Yageo
| Copyright | Copyright (C) 2026 Ultra Librarian. All rights reserved.
Object | Property Name | Property Value
1 : R8/1 | Name | 1
| Number | 1
| Swap Id | -1
| Type | Passive
| Net Name | CAM_SIOC
| Order | 0
| Is No Connect | False
Object | Property Name | Property Value
2 : R8/2 | Name | 2
| Number | 2
| Swap Id | -1
| Type | Passive
| Net Name | V2V8_CAM
| Order | 1
| Is No Connect | False
Object | Property Name | Property Value
INS17880 : Q2 | Name | INS17880
| ID | 819
| Reference | Q2
| Designator
| Part Reference | Q2
| Value | EMOS-ND
| Primitive | DEFAULT
| Implementation Type | <none>
| Implementation
| Implementation Path
| PCB Footprint | SSOT-3
SnapEDA_Link | https://www.snapeda.com/parts/FDN337N/Onsemi/view-part/?ref=snap
Description | N-Channel 30V 2.2A (Ta) 500mW (Ta) Surface Mount SuperSOT-3
Package | TO-236-3 ON
MF | ON Semiconductor
MP | FDN337N
Check_prices | https://www.snapeda.com/parts/FDN337N/Onsemi/view-part/?ref=eda
OriginalSymbolOrigin | (-20000,20000)

Object | Property Name | Property Value
G : Q2/G | Name | G
| Number | 1
| Swap Id | -1
| Type | Passive
| Net Name | V2V8_CAM
| Order | 0
| Is No Connect | False
Object | Property Name | Property Value
S : Q2/S | Name | S
| Number | 2
| Swap Id | -1
| Type | Passive
| Net Name | CAM_SIOD
| Order | 1
| Is No Connect | False
Object | Property Name | Property Value
D : Q2/D | Name | D
| Number | 3
| Swap Id | -1
| Type | Passive
| Net Name | CAM_SCCB_SDA
| Order | 2
| Is No Connect | False
Object | Property Name | Property Value
INS17850 : Q1 | Name | INS17850
| ID | 815
| Reference | Q1
| Designator
| Part Reference | Q1
| Value | EMOS-ND
| Primitive | DEFAULT
| Implementation Type | <none>
| Implementation
| Implementation Path
| PCB Footprint | SSOT-3
SnapEDA_Link | https://www.snapeda.com/parts/FDN337N/Onsemi/view-part/?ref=snap
Description | N-Channel 30V 2.2A (Ta) 500mW (Ta) Surface Mount SuperSOT-3
Package | TO-236-3 ON
MF | ON Semiconductor
MP | FDN337N
Check_prices | https://www.snapeda.com/parts/FDN337N/Onsemi/view-part/?ref=eda
OriginalSymbolOrigin | (-20000,20000)
Object | Property Name | Property Value
G : Q1/G | Name | G
| Number | 1
| Swap Id | -1
| Type | Passive
| Net Name | V2V8_CAM
| Order | 0
| Is No Connect | False

Object | Property Name | Property Value
S : Q1/S | Name | S
| Number | 2
| Swap Id | -1
| Type | Passive
| Net Name | CAM_SIOC
| Order | 1
| Is No Connect | False
Object | Property Name | Property Value
D : Q1/D | Name | D
| Number | 3
| Swap Id | -1
| Type | Passive
| Net Name | CAM_SCCB_SCL
| Order | 2
| Is No Connect | False
