ctw-design-team/aiot-mask-de10-nano-v2/SCHEMATIC/PropS5_SENSORS_I2C.pdf

Object | Property Name | Property Value
I2C_SCL : I2C_SCL (Wire ID = 27286 ) | Name | I2C_SCL
Object | Property Name | Property Value
V3V3_SYS : V3V3_SYS (Wire ID = 27290 ) | Name | V3V3_SYS
Object | Property Name | Property Value
V3V3_SYS : V3V3_SYS (Wire ID = 27292 ) | Name | V3V3_SYS
Object | Property Name | Property Value
V3V3_SYS : V3V3_SYS (Wire ID = 27297 ) | Name | V3V3_SYS
Object | Property Name | Property Value
I2C_SDA : I2C_SDA (Wire ID = 27306 ) | Name | I2C_SDA
Object | Property Name | Property Value
GND : GND_19036 (Wire ID = 27349 ) | Name | GND_19036
Object | Property Name | Property Value
I2C_SDA : I2C_SDA (Wire ID = 27394 ) | Name | I2C_SDA
Object | Property Name | Property Value
I2C_SCL : I2C_SCL (Wire ID = 27414 ) | Name | I2C_SCL
Object | Property Name | Property Value
V3V3_SYS : V3V3_SYS (Wire ID = 27436 ) | Name | V3V3_SYS
Object | Property Name | Property Value
V3V3_SYS : V3V3_SYS (Wire ID = 27438 ) | Name | V3V3_SYS
Object | Property Name | Property Value
V3V3_SYS : V3V3_SYS (Wire ID = 27547 ) | Name | V3V3_SYS
Object | Property Name | Property Value
V3V3_SYS : V3V3_SYS (Wire ID = 27577 ) | Name | V3V3_SYS
Object | Property Name | Property Value
V3V3_SYS : V3V3_SYS (Wire ID = 27581 ) | Name | V3V3_SYS
Object | Property Name | Property Value
GND : GND_19036 (Wire ID = 27594 ) | Name | GND_19036
Object | Property Name | Property Value
GND : GND_19036 (Wire ID = 27598 ) | Name | GND_19036

Object | Property Name | Property Value
V3V3_SYS : V3V3_SYS (Wire ID = 27640 ) | Name | V3V3_SYS
Object | Property Name | Property Value
V3V3_SYS : V3V3_SYS (Wire ID = 27642 ) | Name | V3V3_SYS
Object | Property Name | Property Value
I2C_SCL : I2C_SCL (Wire ID = 37429 ) | Name | I2C_SCL
Object | Property Name | Property Value
I2C_SDA : I2C_SDA (Wire ID = 37441 ) | Name | I2C_SDA
Object | Property Name | Property Value
GND | Name | GND
Source Library | C:\CADENCE\SPB_22.1\TOOLS\CAPTURE\LIBRARY\CAPSYM.OLB
Source Symbol | GND
Object | Property Name | Property Value
V3V3_SYS : | Name | V3V3_SYS
Source Library | C:\CADENCE\SPB_22.1\TOOLS\CAPTURE\LIBRARY\CAPSYM.OLB
Source Symbol | OFFPAGELEFT-L
Object | Property Name | Property Value
I2C_SCL : | Name | I2C_SCL
Source Library | C:\CADENCE\SPB_22.1\TOOLS\CAPTURE\LIBRARY\CAPSYM.OLB
Source Symbol | OFFPAGELEFT-L
Object | Property Name | Property Value
I2C_SDA : | Name | I2C_SDA
Source Library | C:\CADENCE\SPB_22.1\TOOLS\CAPTURE\LIBRARY\CAPSYM.OLB
Source Symbol | OFFPAGELEFT-L
Object | Property Name | Property Value
I2C_SDA : | Name | I2C_SDA
Source Library | C:\CADENCE\SPB_22.1\TOOLS\CAPTURE\LIBRARY\CAPSYM.OLB
Source Symbol | OFFPAGELEFT-L
Object | Property Name | Property Value
I2C_SCL : | Name | I2C_SCL
Source Library | C:\CADENCE\SPB_22.1\TOOLS\CAPTURE\LIBRARY\CAPSYM.OLB
Source Symbol | OFFPAGELEFT-L
Object | Property Name | Property Value
V3V3_SYS : | Name | V3V3_SYS
Source Library | C:\CADENCE\SPB_22.1\TOOLS\CAPTURE\LIBRARY\CAPSYM.OLB
Source Symbol | OFFPAGELEFT-L

Object | Property Name | Property Value
| Path Name | TitleBlock0
| Schematic Path | /
| ID | 505
| Title | S5_SENSORS_I2C
| OrgAddr4
| OrgAddr3
| OrgAddr2
| OrgAddr1
| OrgName
| Cage Code
| RevCode
| Name | TitleBlock0
| Design Name | 123456
| Design File Name | C:\2 3 2026\SCHEMATIC\123456.DSN
| Design Create Date | Thursday, February 26, 2026
| Design Modify Date | Tuesday, March 03, 2026
| Design Create Time | 10:43:25
| Design Modify Time | 11:20:44
| Schematic Name | SCHEMATIC1
| Schematic Create Date | Thursday, February 26, 2026
| Schematic Modify Date | Tuesday, March 03, 2026
| Schematic Create Time | 10:43:26
| Schematic Modify Time | 11:20:46
| Schematic Page Count | 0
| Schematic Page Number | 0
| Page Size | A
| Page Create Date | Sunday, March 01, 2026
| Page Modify Date | Tuesday, March 03, 2026
| Page Create Time | 17:02:12
| Page Modify Time | 10:52:55

TitleBlock0 : TitleBlock0

Source Library | C:\CADENCE\SPB_22.1\TOOLS\CAPTURE\LIBRARY\CAPSYM.OLB
Source Symbol | TitleBlock0
Page Name | S5_SENSORS_I2C
Doc
Page Number | 1
Page Count | 1
Object | Property Name | Property Value
INS27323 : J_SENSOR | Name | INS27323
| ID | 1058
| Reference | J_SENSOR
| Designator
| Part Reference | J_SENSOR
| Value | TS-104-G-AA
| Primitive | DEFAULT
| Implementation Type | <none>
| Implementation
| Implementation Path
| PCB Footprint | SAMTEC_TS-104-G-AA
| OriginalSymbolOrigin | (-30000,30000)

Object | Property Name | Property Value
01 : J_SENSOR/01 | Name | 01
| Number | 01
| Swap Id | -1
| Type | Passive
| Net Name | V3V3_SYS
| Order | 0
| Is No Connect | False
Object | Property Name | Property Value
02 : J_SENSOR/02 | Name | 02
| Number | 02
| Swap Id | -1
| Type | Passive
| Net Name | GND
| Order | 1
| Is No Connect | False
Object | Property Name | Property Value
03 : J_SENSOR/03 | Name | 03
| Number | 03
| Swap Id | -1
| Type | Passive
| Net Name | I2C_SCL
| Order | 2
| Is No Connect | False
Object | Property Name | Property Value
04 : J_SENSOR/04 | Name | 04
| Number | 04
| Swap Id | -1
| Type | Passive
| Net Name | I2C_SDA
| Order | 3
| Is No Connect | False
Object | Property Name | Property Value
INS27264 : R16 | Name | INS27264
| ID | 1055
| Reference | R16
| Designator
| Part Reference | R16
| Value | 4K7
| Primitive | DEFAULT
| Implementation Type | Schematic View
| Implementation | RC0805JR-070RL
| Implementation Path
| DNP | YES
| PCB Footprint | RC0805N_YAG
| Description | RES, 0, 5p, 0.125 W, 0805
| Manufacturer_Part_Number | RC0805JR-070RL
| Manufacturer_Name | Yageo
| Copyright | Copyright (C) 2026 Ultra Librarian. All rights reserved.

Object | Property Name | Property Value
1 : R16/1 | Name | 1
| Number | 1
| Swap Id | -1
| Type | Passive
| Net Name | V3V3_SYS
| Order | 0
| Is No Connect | False
Object | Property Name | Property Value
2 : R16/2 | Name | 2
| Number | 2
| Swap Id | -1
| Type | Passive
| Net Name | I2C_SDA
| Order | 1
| Is No Connect | False
Object | Property Name | Property Value
INS37401 : TP12 | Name | INS37401
| ID | 1173
| Reference | TP12
| Designator
| Part Reference | TP12
| Value | TP_I2C_SDA
| Primitive | DEFAULT
| Implementation Type | <none>
| Implementation
| Implementation Path
| PCB Footprint
Object | Property Name | Property Value
1 : TP12/1 | Name | 1
| Number | 1
| Swap Id | -1
| Type | Passive
| Net Name | I2C_SDA
| Order | 0
| Is No Connect | False
Object | Property Name | Property Value
INS37387 : TP11 | Name | INS37387
| ID | 1171
| Reference | TP11
| Designator
| Part Reference | TP11
| Value | TP_I2C_SCL
| Primitive | DEFAULT
| Implementation Type | <none>
| Implementation
| Implementation Path
| PCB Footprint

Object | Property Name | Property Value
1 : TP11/1 | Name | 1
| Number | 1
| Swap Id | -1
| Type | Passive
| Net Name | I2C_SCL
| Order | 0
| Is No Connect | False
Object | Property Name | Property Value
INS27527 : C24 | Name | INS27527
| ID | 1067
| Reference | C24
| Designator
| Part Reference | C24
| Value | 0.1UF
| Primitive | DEFAULT
| Implementation Type | <none>
| Implementation
| Implementation Path
| PCB Footprint | CAPC2012X94N
| OriginalSymbolOrigin | (0,10000)
Object | Property Name | Property Value
1 : C24/1 | Name | 1
| Number | 1
| Swap Id | -1
| Type | Passive
| Net Name | V3V3_SYS
| Order | 0
| Is No Connect | False
Object | Property Name | Property Value
2 : C24/2 | Name | 2
| Number | 2
| Swap Id | -1
| Type | Passive
| Net Name | GND
| Order | 1
| Is No Connect | False

Object | Property Name | Property Value
INS27238 : R15 | Name | INS27238
| ID | 1052
| Reference | R15
| Designator
| Part Reference | R15
| Value | 4K7
| Primitive | DEFAULT
| Implementation Type | Schematic View
| Implementation | RC0805JR-070RL
| Implementation Path
| DNP | YES
| PCB Footprint | RC0805N_YAG
| Description | RES, 0, 5p, 0.125 W, 0805
| Manufacturer_Part_Number | RC0805JR-070RL
| Manufacturer_Name | Yageo
| Copyright | Copyright (C) 2026 Ultra Librarian. All rights reserved.
Object | Property Name | Property Value
1 : R15/1 | Name | 1
| Number | 1
| Swap Id | -1
| Type | Passive
| Net Name | V3V3_SYS
| Order | 0
| Is No Connect | False
Object | Property Name | Property Value
2 : R15/2 | Name | 2
| Number | 2
| Swap Id | -1
| Type | Passive
| Net Name | I2C_SCL
| Order | 1
| Is No Connect | False
