ctw-design-team/aiot-mask-de10-nano-v2/DATASHEET/Schematic_AHT20.png

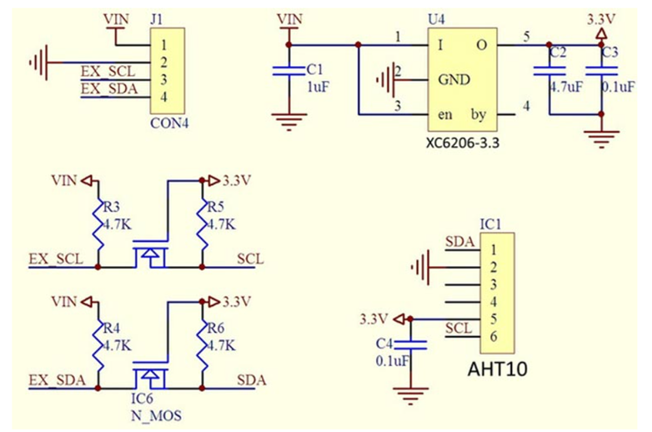
DATASHEET/Schematic_AHT20.png
