ctw-design-team/aiot-mask-de10-nano-v2/SCHEMATIC/123456.png

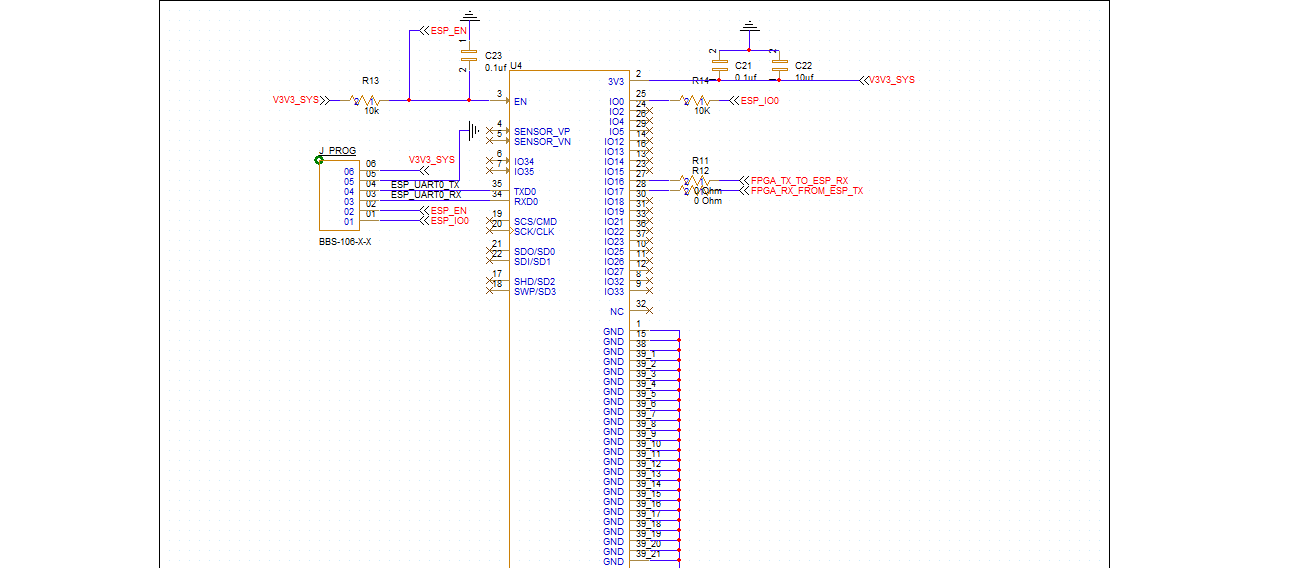
SCHEMATIC/123456.png
