ctw-design-team/aiot-mask-de10-nano-v2/BOM/BOM.xlsx

Tuesday, March 03, 2026
Bill Of Materials March 4,2026 23:16:06 | Page1
Item | Quantity | Reference | Value | PCB Footprint
1 | 3 | C1 | 10uf | CAPC2012X94N
 |  | C2 | 10uf | CAPC2012X94N
 |  | C22 | 10uf | CAPC2012X94N
2 | 11 | C3 | 0.1uf | CAPC2012X94N
 |  | C4 | 0.1uf | CAPC2012X94N
 |  | C6 | 0.1uf | CAPC2012X94N
 |  | C8 | 0.1uf | CAPC2012X94N
 |  | C10 | 0.1uf | CAPC2012X94N
 |  | C14 | 0.1uf | CAPC2012X94N
 |  | C15 | 0.1uf | CAPC2012X94N
 |  | C17 | 0.1uf | CAPC2012X94N
 |  | C21 | 0.1uf | CAPC2012X94N
 |  | C23 | 0.1uf | CAPC2012X94N
 |  | C24 | 0.1UF | CAPC2012X94N
3 | 8 | C5 | 4.7 uf | CAPC2012X94N
 |  | C7 | 4.7 uf | CAPC2012X94N
 |  | C9 | 4.7 uf | CAPC2012X94N
 |  | C11 | 4.7 uf | CAPC2012X94N
 |  | C12 | 4.7 uf | CAPC2012X94N
 |  | C13 | 4.7 uf | CAPC2012X94N
 |  | C16 | 4.7 uf | CAPC2012X94N
 |  | C18 | 4.7 uf | CAPC2012X94N
4 | 2 | JP1 | TSW-120-07-G-D-LL | SAMTEC_TSW-120-07-G-D-LL
 |  | JP7 | TSW-120-07-G-D-LL | SAMTEC_TSW-120-07-G-D-LL
5 | 1 | J_PROG | BBS-106-X-X | SAMTEC_BBS-106-X-X
6 | 1 | J_SENSOR | TS-104-G-AA | SAMTEC_TS-104-G-AA
7 | 1 | J1 | 2-1734839-4 | TE_2-1734839-4
8 | 1 | L1 | B82477R4154M100 | IND_B82477R4154M100
9 | 2 | Q1 | EMOS-ND | SSOT-3
 |  | Q2 | EMOS-ND | SSOT-3
10 | 5 | R2 | 0 ohm | RC0805N_YAG
 |  | R3 | 0 Ohm | RC0805N_YAG
 |  | R4 | 0 Ohm | RC0805N_YAG
 |  | R11 | 0 Ohm | RC0805N_YAG
 |  | R12 | 0 Ohm | RC0805N_YAG
11 | 4 | R5 | 2K2 | RC0805N_YAG
 |  | R6 | 2K2 | RC0805N_YAG
 |  | R7 | 2K2 | RC0805N_YAG
 |  | R8 | 2K2 | RC0805N_YAG
12 | 2 | R13 | 10k | RC0805N_YAG
 |  | R14 | 10K | RC0805N_YAG
13 | 2 | R15 | 4K7 | RC0805N_YAG
 |  | R16 | 4K7 | RC0805N_YAG
14 | 8 | R17 | 33 Ohm | R0603
 |  | R18 | 33 Ohm | R0603
 |  | R19 | 33 Ohm | R0603
 |  | R20 | 33 Ohm | R0603
 |  | R21 | 33 Ohm | R0603
 |  | R22 | 33 Ohm | R0603
 |  | R23 | 33 Ohm | R0603
 |  | R24 | 33 Ohm | R0603
15 | 1 | TP1 | TP_V5_IN
16 | 1 | TP2 | TP_V3V3_SYS
17 | 1 | TP3 | TP_V3V3_CAM
18 | 1 | TP4 | TP_V2V8_CAM
19 | 1 | TP5 | TP_V1V2_CAM
20 | 1 | TP6 | TP_GND
21 | 1 | TP7 | TP_HSYNC
22 | 1 | TP8 | TP_VSYNC
23 | 1 | TP9 | TP_XCLK
24 | 1 | TP10 | TP_PCLK
25 | 1 | TP11 | TP_I2C_SCL
26 | 1 | TP12 | TP_I2C_SDA
27 | 1 | U1 | PMIC-XC6206P | SOT-23
28 | 1 | U2 | 2.8V | SOT-23
29 | 1 | U3 | 1.2V | SOT-23
30 | 1 | U4 | ESP32-WROOM-32 | MODULE_ESP32-WROOM-32
