ctw-design-team/aiot-mask-de10-nano-v2/FOOTPRINT/FDN337N.STEP

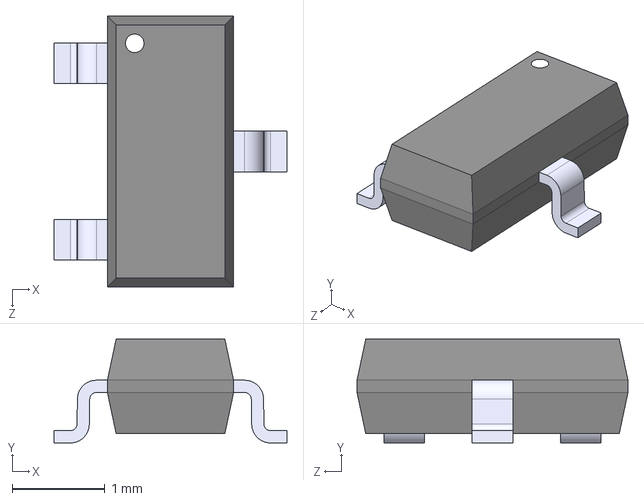
[picture p3: CAD file, 2026-03-16]
FOOTPRINT/FDN337N.STEP
2.51 x 1.12 x 2.92 mm
