ctw-design-team/aiot-mask-de10-nano-v2/SCHEMATIC/SMASeries_LTF.step

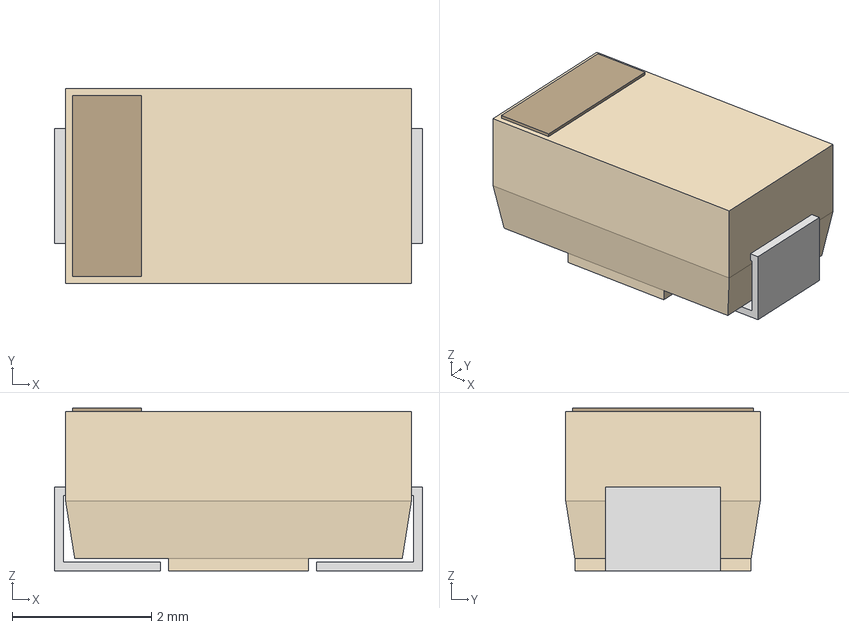
[picture p4: CAD file, 2026-03-16]
SCHEMATIC/SMASeries_LTF.step
5.28 x 2.79 x 2.34 mm
