ctw-design-team/aiot-mask-de10-nano-v2/SYMBOL/BH1750FVI-TR--3DModel-STEP-56544.STEP

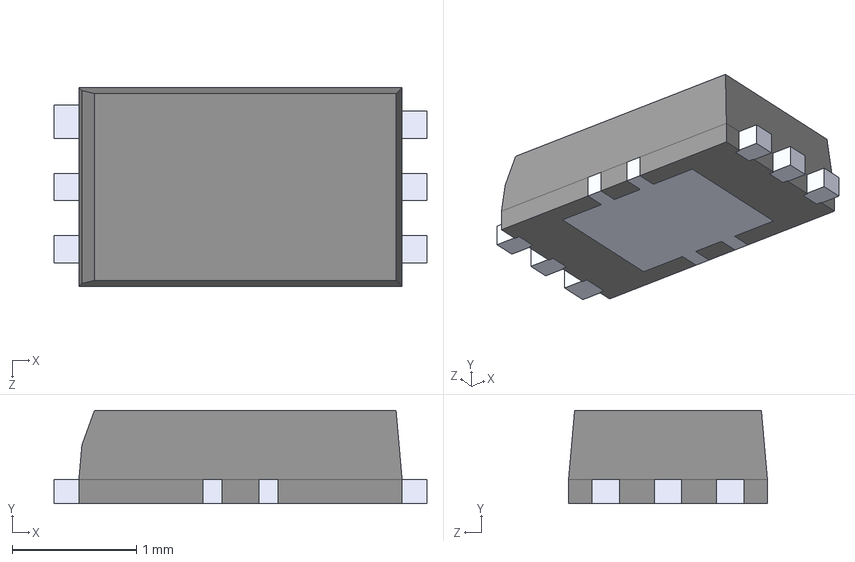
[picture p5: CAD file, 2026-03-16]
SYMBOL/BH1750FVI-TR--3DModel-STEP-56544.STEP
3.00 x 0.75 x 1.60 mm
