ctw-design-team/aiot-mask-de10-nano-v2/SCHEMATIC/S2_CAMERA_OV2640_FPC.DXF

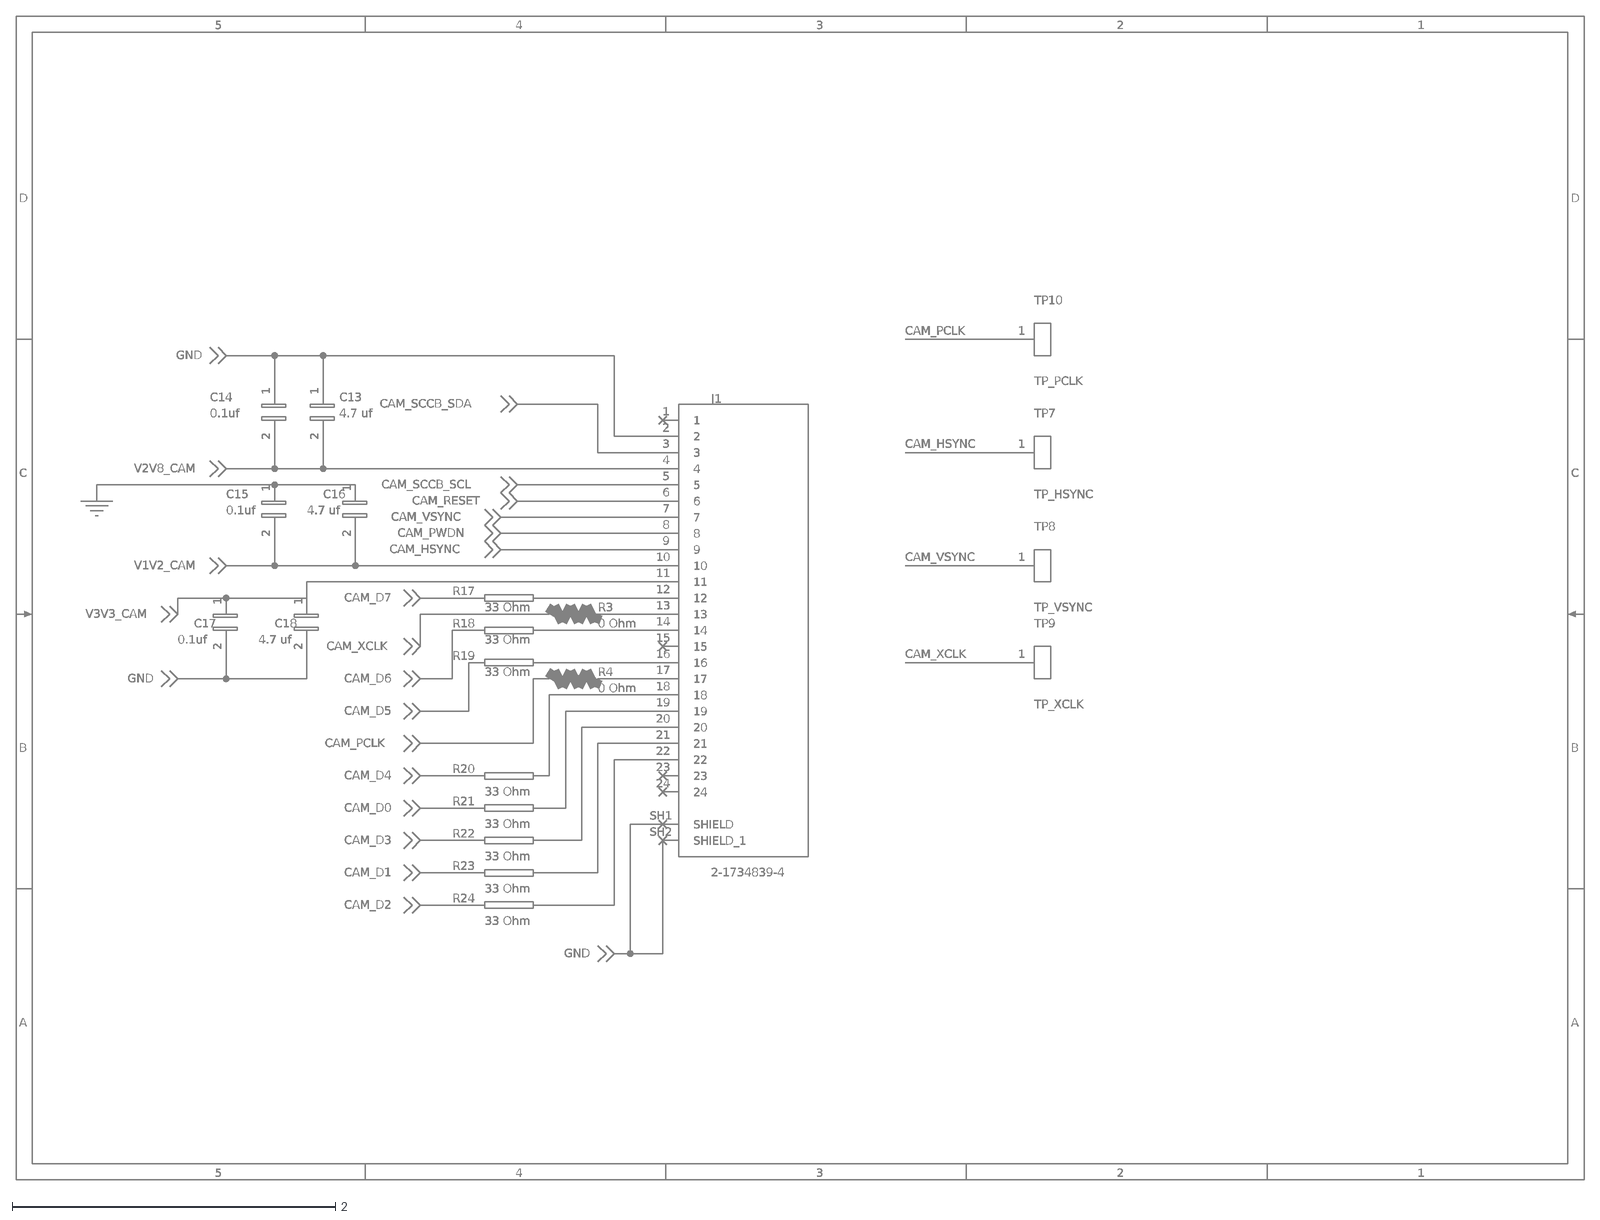
[picture p6: CAD file, 2026-03-16]
SCHEMATIC/S2_CAMERA_OV2640_FPC.DXF
5
4
3
2
1
D
C
B
A
R22
33 Ohm
TP8
TP_VSYNC
R24
0 Ohm
R4
J1
2-1734839-4
SHIELD
SH1
SHIELD_1
SH2
6
7
8
9
10
11
12
13
14
15
16
17
18
19
20
21
22
23
24
C18
4.7 uf
R3
C16
TP7
TP_HSYNC
R17
TP9
TP_XCLK
R19
R21
R23
C13
TP10
TP_PCLK
C15
0.1uf
C17
C14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
