ctw-design-team/aiot-mask-de10-nano-v2/SYMBOL/AHT20--3DModel-STEP-269445.STEP

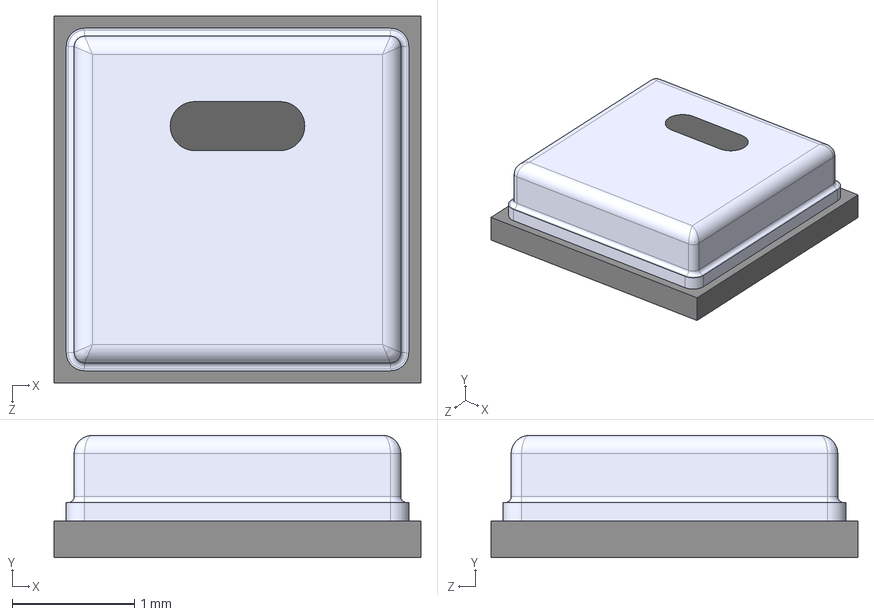
[picture p7: CAD file, 2026-03-16]
SYMBOL/AHT20--3DModel-STEP-269445.STEP
3.00 x 1.00 x 3.00 mm
