ctw-design-team/aiot-mask-de10-nano-v2/SCHEMATIC/FH34SRJ-24S-0.5SH(99).STEP

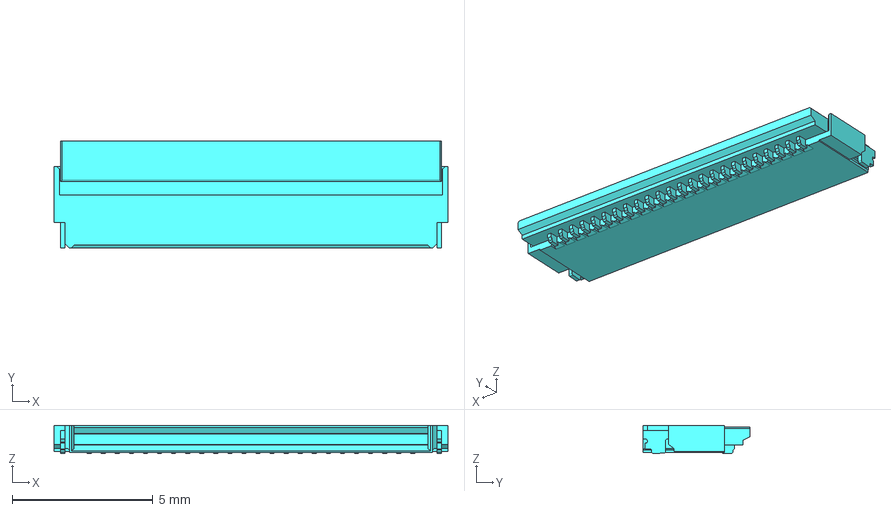
[picture p8: CAD file, 2026-03-16]
SCHEMATIC/FH34SRJ-24S-0.5SH(99).STEP
14.0 x 3.80 x 1.00 mm
