ctw-design-team/aiot-mask-de10-nano-v2/FOOTPRINT/XC6206P332MR-G.STEP

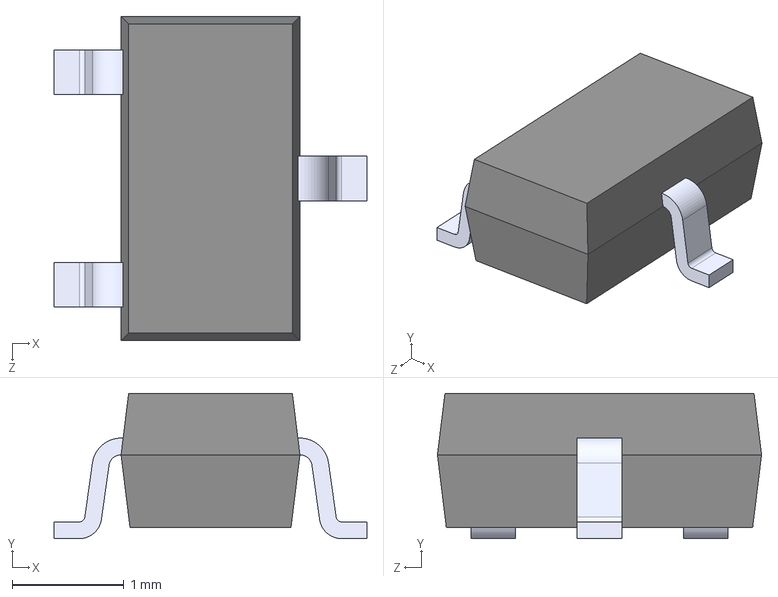
[picture p9: CAD file, 2026-03-16]
FOOTPRINT/XC6206P332MR-G.STEP
2.80 x 1.30 x 2.90 mm
