ctw-design-team/aiot-mask-de10-nano-v2/SCHEMATIC/TD-120-G-AA.stp

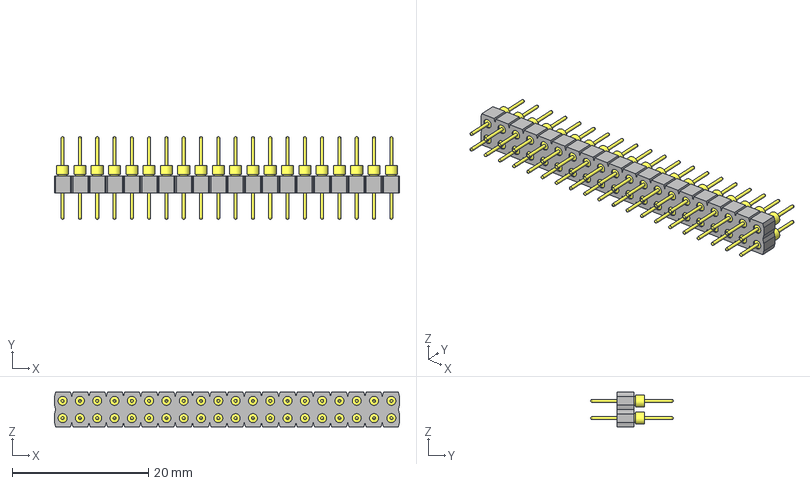
[picture p10: CAD file, 2026-03-16]
SCHEMATIC/TD-120-G-AA.stp
50.6 x 12.1 x 5.08 mm
TD-120-G-AA_socket
-101-G-AA_pins x 40
