ctw-design-team/aiot-mask-de10-nano-v2/FOOTPRINT/RC0805N_YAG.step

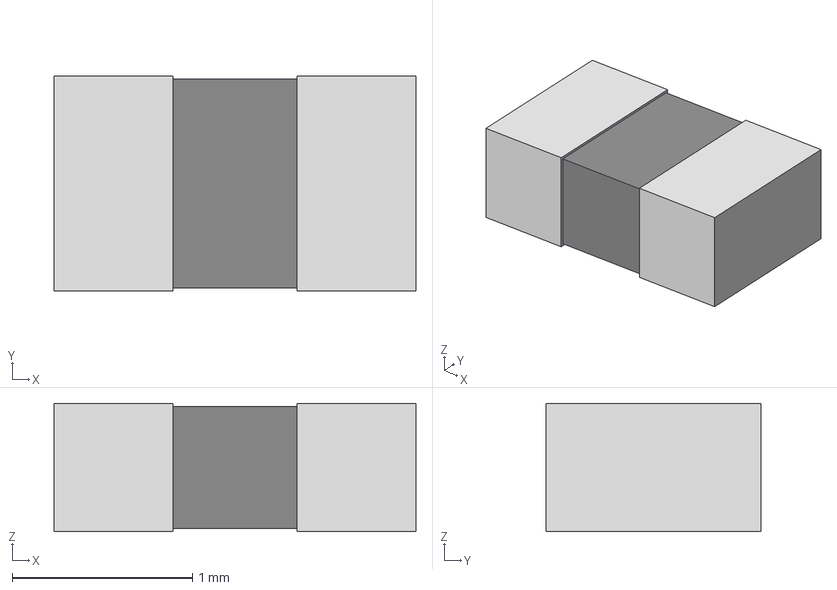
[picture p11: CAD file, 2026-03-16]
FOOTPRINT/RC0805N_YAG.step
2.01 x 1.19 x 0.711 mm
