ctw-design-team/aiot-mask-de10-nano-v2/SCHEMATIC/ESP-WROOM-32--3DModel-STEP-56544.STEP

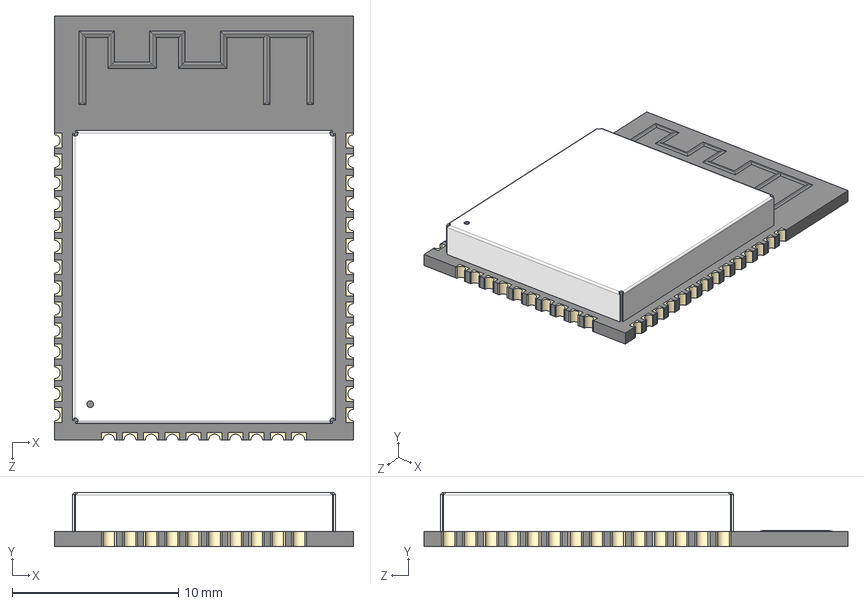
[picture p12: CAD file, 2026-03-16]
SCHEMATIC/ESP-WROOM-32--3DModel-STEP-56544.STEP
18.0 x 3.25 x 25.5 mm
