ctw-design-team/aiot-mask-de10-nano-v2/SCHEMATIC/0805YC103J4T2A.STEP

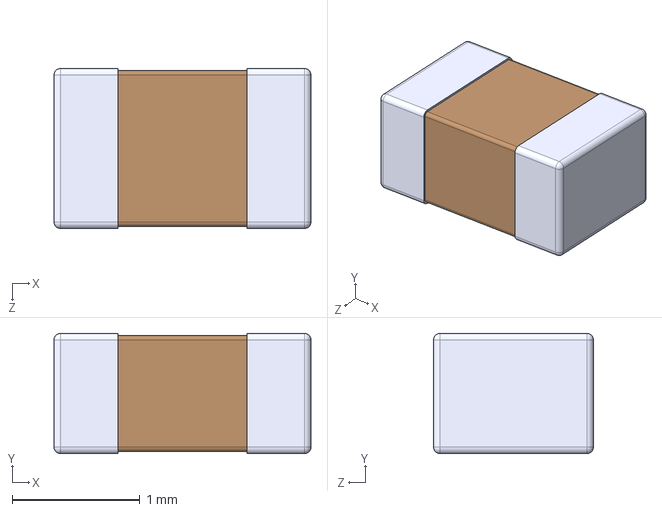
[picture p13: CAD file, 2026-03-16]
SCHEMATIC/0805YC103J4T2A.STEP
2.01 x 0.94 x 1.25 mm
