ctw-design-team/aiot-mask-de10-nano-v2/SCHEMATIC/S5_SENSORS_I2C.DXF

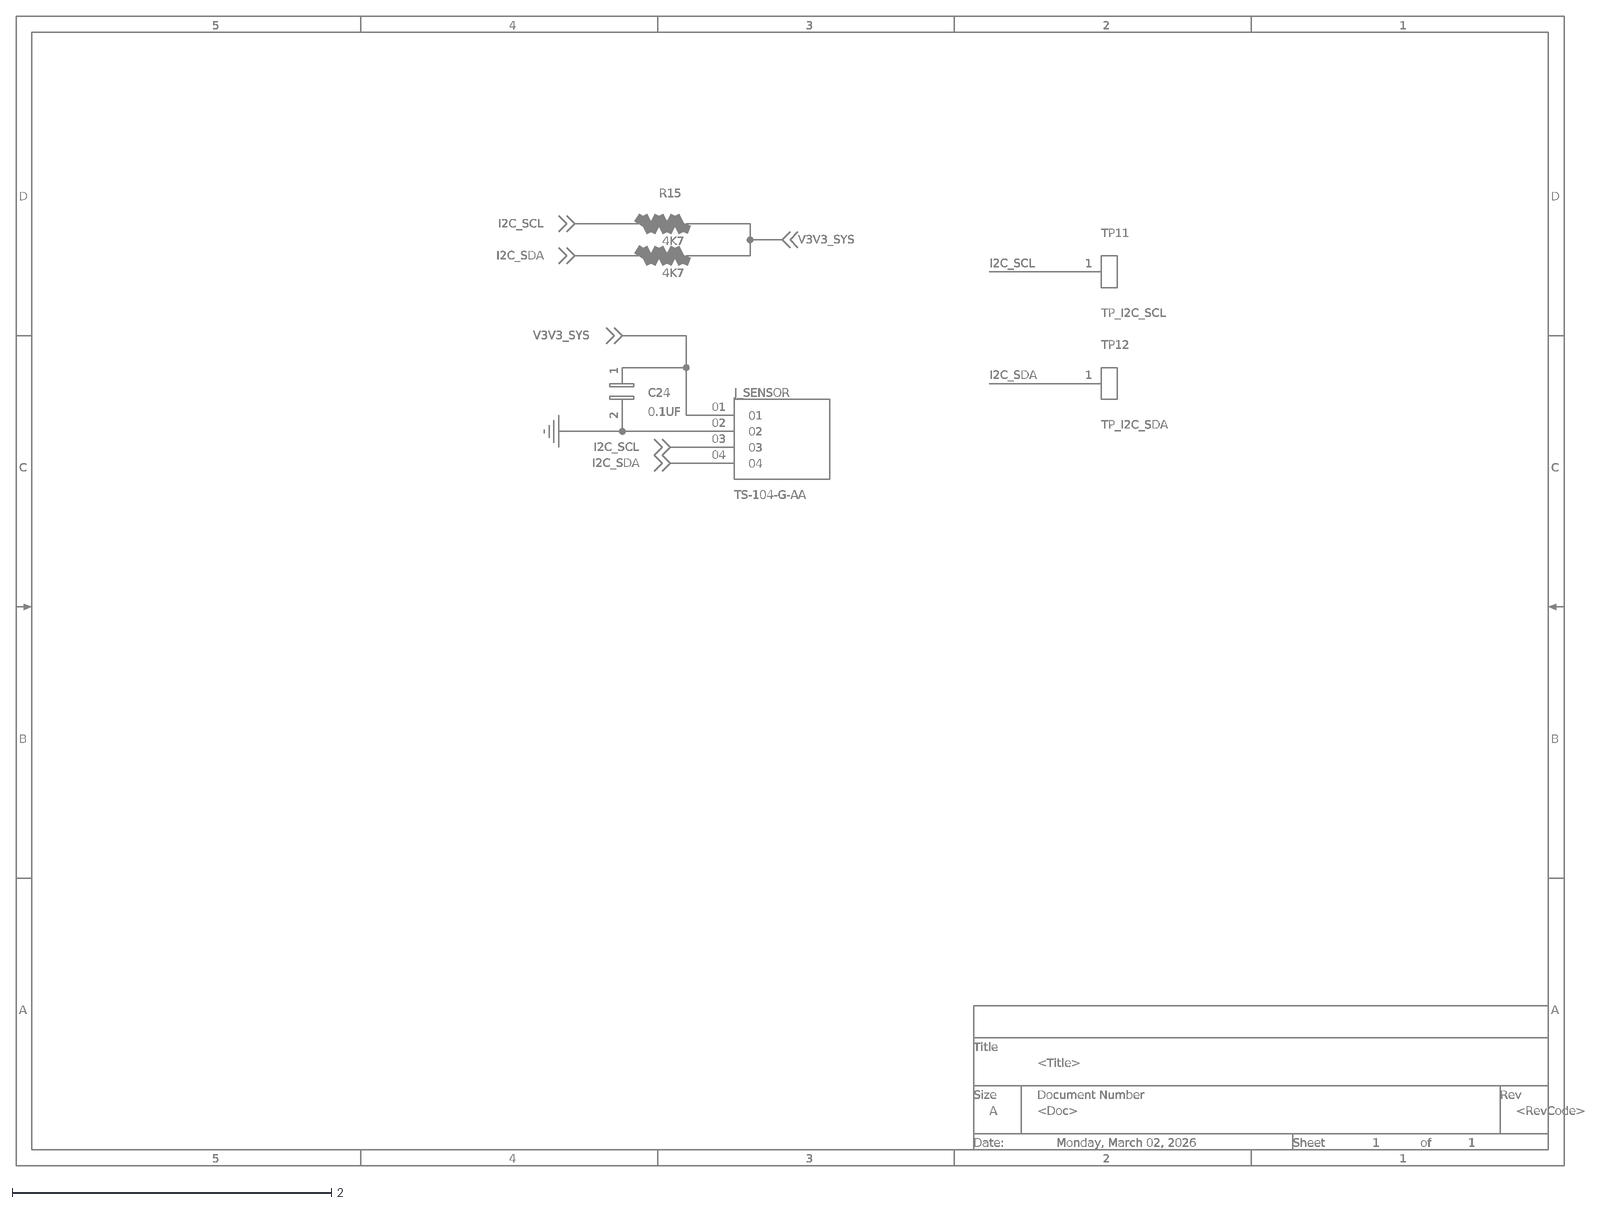
[picture p14: CAD file, 2026-03-16]
SCHEMATIC/S5_SENSORS_I2C.DXF
5
4
3
2
1
D
C
B
A
<Doc>
<RevCode>
<Title>
Monday, March 02, 2026
Title
Size
Document Number
Rev
Date:
Sheet
of
J_SENSOR
TS-104-G-AA
01
02
03
04
4K7
R16
TP12
TP_I2C_SDA
TP11
TP_I2C_SCL
R15
C24
0.1UF
I2C_SCL
I2C_SDA
V3V3_SYS
