ctw-design-team/aiot-mask-de10-nano-v2/FOOTPRINT/FCB-0402-101A.stp

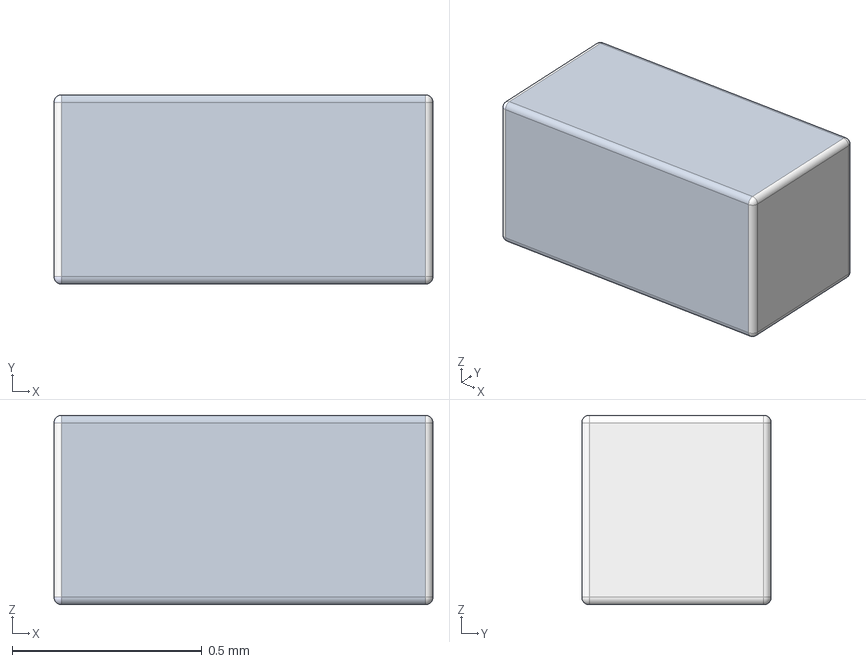
[picture p15: CAD file, 2026-03-16]
FOOTPRINT/FCB-0402-101A.stp
1.00 x 0.5 x 0.5 mm
