ctw-design-team/aiot-mask-de10-nano-v2/FOOTPRINT/SOT-223_3MC_MCH.step

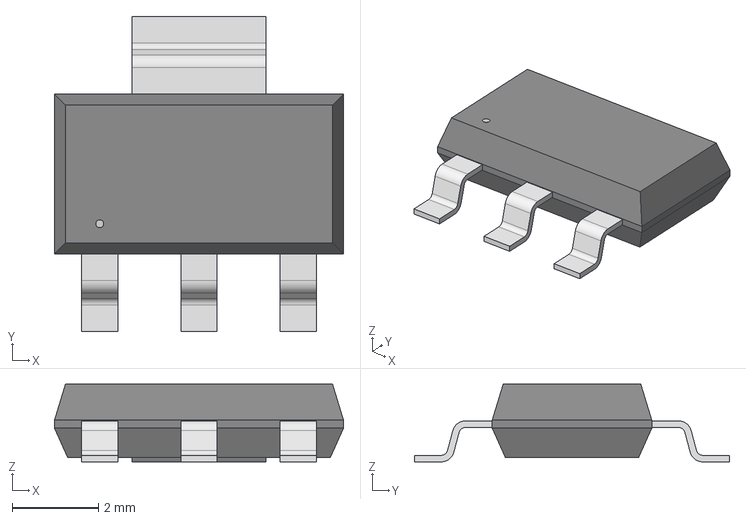
[picture p16: CAD file, 2026-03-16]
FOOTPRINT/SOT-223_3MC_MCH.step
6.70 x 7.30 x 1.80 mm
