ctw-design-team/aiot-mask-de10-nano-v2/(list of files, cad)

Other CAD files:
FOOTPRINT/capc2012x94n.psm
FOOTPRINT/con40_2x20_tu_hts_sai.psm
FOOTPRINT/fb_fcb-0402-101a.psm
FOOTPRINT/hrs_fh34srj-24s-05sh99.psm
FOOTPRINT/ind_b82477r4154m100.psm
FOOTPRINT/module_esp32-wroom-32.psm
FOOTPRINT/pson100p300x300x110-6n.psm
FOOTPRINT/r0603.psm
FOOTPRINT/rc0805n_yag-l.psm
FOOTPRINT/rc0805n_yag-m.psm
FOOTPRINT/rc0805n_yag.psm
FOOTPRINT/samtec_bbs-106-x-x.psm
FOOTPRINT/samtec_ts-104-g-aa.psm
FOOTPRINT/samtec_tsw-120-07-g-d-ll.psm
FOOTPRINT/smaseries_ltf-l.psm
FOOTPRINT/smaseries_ltf-m.psm
FOOTPRINT/smaseries_ltf.psm
FOOTPRINT/sot-223_3mc_mch-l.psm
FOOTPRINT/sot-223_3mc_mch-m.psm
FOOTPRINT/sot-223_3mc_mch.psm
FOOTPRINT/sot-23.psm
FOOTPRINT/ssot-3.psm
FOOTPRINT/te_2-1734839-4.psm
FOOTPRINT/tp_1mm.psm
FOOTPRINT/tp_new.psm
FOOTPRINT/xdcr_bh1750fvi-tr.psm
SCHEMATIC/capc2012x94n.psm
SCHEMATIC/con40_2x20_tu_hts_sai.psm
SCHEMATIC/hrs_fh34srj-24s-05sh99.psm
SCHEMATIC/module_esp32-wroom-32.psm
SCHEMATIC/pson100p300x300x110-6n.psm
SCHEMATIC/r0603.psm
SCHEMATIC/rc0805n_yag-l.psm
SCHEMATIC/rc0805n_yag-m.psm
SCHEMATIC/rc0805n_yag.psm
SCHEMATIC/samtec_bbs-106-x-x.psm
SCHEMATIC/samtec_ts-104-g-aa.psm
SCHEMATIC/samtec_tsw-120-07-g-d-ll.psm
SCHEMATIC/smaseries_ltf-l.psm
SCHEMATIC/smaseries_ltf-m.psm
SCHEMATIC/smaseries_ltf.psm
SCHEMATIC/sot-23.psm
SCHEMATIC/ssot-3.psm
SCHEMATIC/te_2-1734839-4.psm
SCHEMATIC/xdcr_bh1750fvi-tr.psm
