ctw-design-team/aiot-mask-de10-nano-v2/Manual/AIoT_Vision_Mask_Lab_Manual.docx

TÀI LIỆU HƯỚNG DẪN THỰC HÀNH
HỆ THỐNG NHÚNG VÀ IoT ỨNG DỤNG
AIoT VISION MASK TRÊN DE10-NANO

Bản dành cho sinh viên - manual 2 phần: Sensor + MQTT và Camera AI + FPGA DE10

Mục đích của tài liệu này

Tài liệu dùng để hướng dẫn sinh viên thao tác đúng theo thứ tự phần cứng - phần mềm - mạng.

Phần 1 tập trung vào chuỗi dữ liệu cảm biến và vai trò của ESP32 như MQTT gateway.

Phần 2 tập trung vào camera OV2640, khối xử lý trên FPGA DE10-Nano, và quy trình nạp cấu hình qua cổng Joint Test Action Group (JTAG).

Manual giả định giảng viên đã cung cấp sẵn file cấu hình .sof cho từng bài lab.

Phiên bản: v7.3 | Ngày cập nhật: 17-03-2026

Tài liệu này ưu tiên tính chính xác thao tác trong phòng lab, vì vậy mỗi bước đều nêu rõ vai trò của DE10-Nano, ESP32 gateway, bus cảm biến, camera và đường truyền MQTT.

# Mục lục nhanh

• 0. Kiến trúc dùng chung và quy ước đọc manual

• 1. Quy trình nạp cấu hình DE10-Nano qua cổng Joint Test Action Group (JTAG)

• 2. Phần 1 - Hệ thống IoT cơ bản: Sensor + ESP32 + MQTT -> Web

• 3. Phần 2 - Hệ thống AI Camera Edge: OV2640 + FPGA DE10 + AI Light + MQTT -> Web

• 4. Phụ lục - Checklist cho sinh viên và lưu ý cho giảng viên

Cách đọc tài liệu để tránh nhầm kiến trúc

Một dây nối vật lý và một luồng dữ liệu logic không phải lúc nào cũng giống nhau.

Trong manual này, DE10-Nano là endpoint xử lý phần cứng; ESP32 là gateway mạng.

Vì vậy sinh viên phải tách bạch ba lớp: mapping phần cứng, luồng runtime, và luồng đẩy dữ liệu lên web.

# 0. Kiến trúc dùng chung và quy ước đọc manual

Manual này sử dụng một kiến trúc nhất quán cho cả hai bài lab. Board DE10-Nano đóng vai trò nền phần cứng và endpoint xử lý. Mask board đặt phía trên DE10-Nano, mang theo các khối ngoại vi như cụm cảm biến, camera, mạch chuyển mức và khối ESP32 gateway. ESP32 không phải là nơi xử lý AI trong bài lab này; ESP32 chủ yếu giữ kết nối Wi-Fi, nhận dữ liệu runtime từ DE10-Nano qua Universal Asynchronous Receiver/Transmitter (UART) và publish lên Message Queuing Telemetry Transport (MQTT).

Khối | Vai trò chính trong bài lab | Điểm sinh viên cần nhớ
DE10-Nano | Nhận cấu hình .sof qua JTAG; thực thi logic phần cứng; đọc hoặc gom dữ liệu runtime; xuất kết quả qua UART. | Nếu mất nguồn thì cấu hình .sof bị mất và phải nạp lại.
Mask board | Mang power tree, connector, bus cảm biến, bus camera và mạch chuyển mức. | Không xem mask như kit độc lập; luôn đặt trong ngữ cảnh gắn trên DE10-Nano.
ESP32 gateway | Nhận payload runtime qua UART, kết nối Wi-Fi, publish MQTT, hỗ trợ quan sát trên web. | Không nhầm UART runtime với cổng debug hoặc cổng nạp.
AHT20 / BH1750 | Cấp dữ liệu nhiệt độ, độ ẩm và độ sáng cho bài lab môi trường. | Bus Inter-Integrated Circuit (I2C) dùng mức 3.3 V và cần Ground chung.
OV2640 | Cấp dữ liệu hình ảnh qua bus song song 8-bit và nhận cấu hình qua bus SCCB. | Phía camera có miền 2.8 V; không được ép mức 3.3 V trực tiếp vào chân 2.8 V.

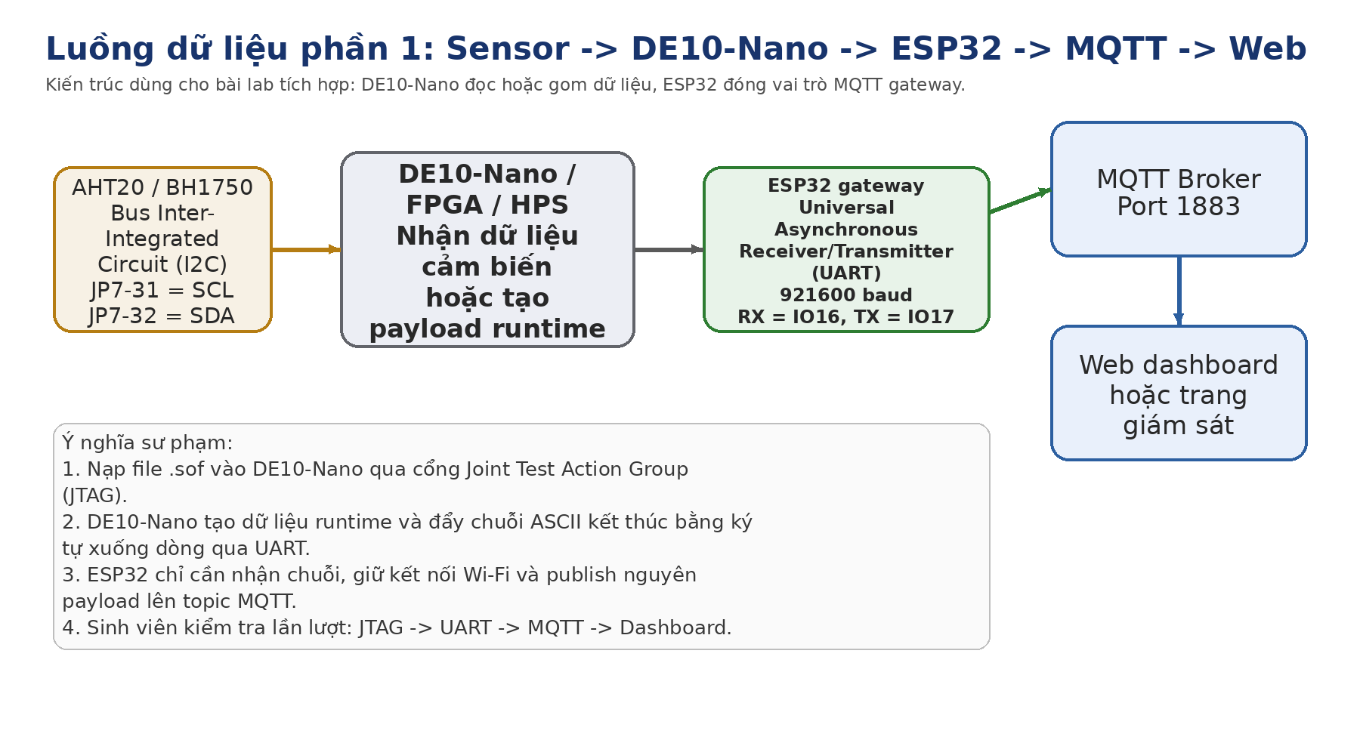
[picture p17: figure]

Hình 1. Luồng dữ liệu của phần 1.

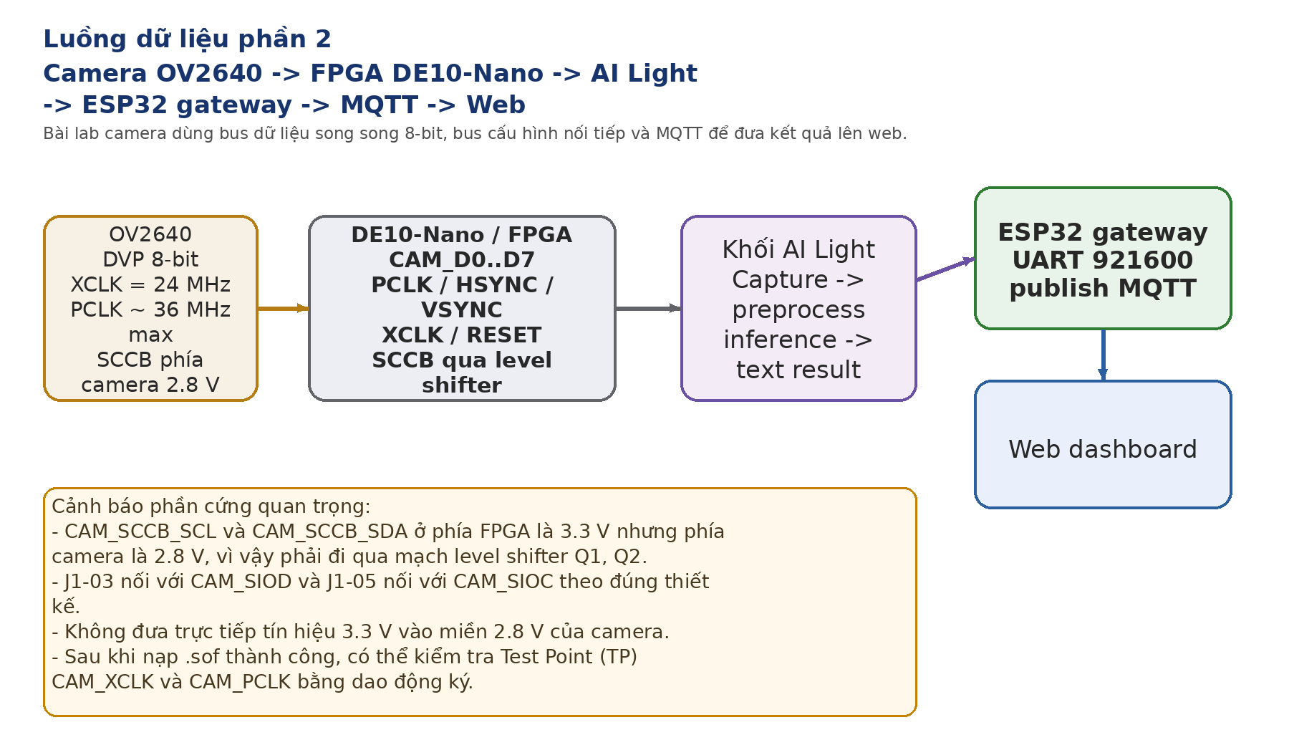
[picture p18: figure]

Hình 2. Luồng dữ liệu của phần 2.

# 1. Quy trình nạp cấu hình DE10-Nano qua cổng Joint Test Action Group (JTAG)

Quy trình này dùng cho cả bài lab cảm biến và bài lab camera. Sinh viên cần hiểu rằng file .sof là cấu hình tạm thời cho FPGA. Sau khi tắt nguồn hoặc reset mạnh hệ thống, cấu hình này không còn hiệu lực. Vì vậy nếu board không hoạt động như mong đợi sau khi mất nguồn, bước đầu tiên phải kiểm tra lại là nạp lại file .sof.

## 1.1. Chuẩn bị trước khi nạp

• Board DE10-Nano đã được cấp nguồn đúng theo yêu cầu của bộ kit.

• Cáp Universal Serial Bus (USB) nối từ máy tính vào cổng USB-Blaster II / JTAG của board.

• Máy tính đã cài Intel Quartus Prime và đã có sẵn file .sof cho bài lab.

• Mask board gắn chắc chắn, không lệch header, không chạm chập cơ khí.

## 1.2. Trình tự thao tác trong Intel Quartus Prime

1. Mở Intel Quartus Prime, sau đó vào Tools -> Programmer.

2. Nhấn Hardware Setup..., chọn đúng thiết bị DE-SoC [USB-1] hoặc tên cáp USB-Blaster đang xuất hiện trên máy tính, rồi đóng cửa sổ Hardware Setup.

3. Nhấn Add File..., chọn file .sof mà giảng viên cung cấp cho đúng bài lab.

4. Kiểm tra cột Program/Configure đã được đánh dấu ở cùng hàng với file .sof.

5. Nhấn Start và quan sát thanh Progress.

6. Khi trạng thái hiển thị 100% (Successful), coi như FPGA đã nhận cấu hình thành công.

7. Giữ nguyên nguồn và tiếp tục các bước của bài lab. Nếu power-cycle board, phải nạp lại .sof.

Những lỗi rất hay gặp khi nạp JTAG

Không thấy thiết bị trong Hardware Setup: kiểm tra lại cáp USB-Blaster, driver, quyền truy cập thiết bị, và nguồn board.

Nhấn Start nhưng không chạy: thường do chưa chọn đúng hardware hoặc chưa tick Program/Configure.

Nạp xong nhưng hệ thống không có phản ứng: có thể đã chọn nhầm file .sof hoặc file không khớp project.

Lúc đầu chạy được, sau đó mất tác dụng sau khi tắt nguồn: đây là hành vi bình thường của file .sof.

## 1.3. Checklist xác nhận nạp thành công

Hạng mục | Dấu hiệu đúng | Nếu sai thì làm gì
Quartus Programmer | Progress = 100% (Successful). | Quay lại kiểm tra Hardware Setup và file .sof.
Cáp JTAG | Tên cáp xuất hiện trong Hardware Setup. | Thử cắm lại cáp, đổi cổng USB, kiểm tra driver.
Board sau nạp | Có tín hiệu runtime hoặc tín hiệu test point đúng với bài lab. | Kiểm tra lại file cấu hình và trạng thái nguồn.

# 2. Phần 1 - Hệ thống IoT cơ bản: Sensor + ESP32 + MQTT -> Web

## 2.1. Mục tiêu

• Hiểu kiến trúc cấp nguồn và giao tiếp Inter-Integrated Circuit (I2C) cho cụm cảm biến môi trường AHT20 và BH1750.

• Thiết lập giao tiếp runtime giữa DE10-Nano và ESP32 gateway qua Universal Asynchronous Receiver/Transmitter (UART) ở 921600 baud.

• Nạp code cho ESP32 để giữ kết nối Wi-Fi, publish dữ liệu lên MQTT Broker và quan sát trên web dashboard.

• Phân biệt rõ ba điểm kiểm tra: sensor side, UART side và MQTT side.

## 2.2. Luồng dữ liệu của phần 1

Trong bài lab này, cụm cảm biến được xem là nguồn dữ liệu đầu vào của hệ thống phần cứng. Dữ liệu được đọc hoặc gom lại ở phía DE10-Nano, sau đó đẩy sang ESP32 gateway qua UART. ESP32 không cần hiểu chi tiết cách đọc từng thanh ghi cảm biến; nhiệm vụ của ESP32 là nhận chuỗi runtime, đóng vai trò cầu nối mạng và publish nguyên payload lên MQTT.

## 2.3. Thông số kỹ thuật cần nhớ

Thông số | Giá trị dùng trong manual | Ý nghĩa thực hành
Nguồn hệ vi điều khiển | V3V3_SYS = 3.3 V | Mức nguồn chính cho ESP32 gateway và các khối 3.3 V.
Khả năng cấp của rail 3.3 V | Tối đa khoảng 1000 mA | Đủ cho ESP32 và tải cảm biến trong bài lab.
Dòng tiêu thụ đỉnh của ESP32 khi RF hoạt động | Khoảng 379 mA | Phải đảm bảo rail 3.3 V không sụt áp khi kết nối Wi-Fi.
I2C mặc định | 100 kHz | Mức an toàn để bring-up và kiểm tra nhanh.
I2C tối đa khuyến nghị | 400 kHz | Chỉ tăng sau khi wiring và pull-up đã ổn.
Điện trở kéo lên bus I2C | 4.7 kΩ | Với dây ngắn, đây là giá trị khởi đầu an toàn.
Dòng qua mỗi pull-up khi bus ở mức LOW | Khoảng 0.702 mA | Dùng để ước lượng tải và kiểm tra mức logic.
UART runtime | 921600 baud | Sai baudrate sẽ gây rác dữ liệu hoặc mất khung.
Chu kỳ lấy mẫu AHT20 | Lớn hơn 1 giây | Giảm khả năng tự gia nhiệt và đọc sai.

## 2.4. Mapping phần cứng cho phần 1

Nhóm | Tên tín hiệu / net | Kết nối | Ghi chú
Nguồn | 5V_IN | JP1-11 hoặc JP7-11 | Đi vào power tree của mask; không đưa trực tiếp vào chân 3.3 V logic.
Nguồn | 3V3 | JP1-29 hoặc JP7-29 | Mức 3.3 V tham chiếu trên header; dùng để đối chiếu và debug.
Nguồn | GND | JP1-12 / JP1-30 / JP7-12 / JP7-30 | Ground chung cho toàn hệ thống.
I2C cảm biến | I2C_SCL | JP7-31 | Bus cảm biến ở mức 3.3 V.
I2C cảm biến | I2C_SDA | JP7-32 | Bus cảm biến ở mức 3.3 V.
Runtime UART | FPGA_TX_TO_ESP_RX | ESP32 IO16 | DE10-Nano phát, ESP32 nhận.
Runtime UART | FPGA_RX_FROM_ESP_TX | ESP32 IO17 | DE10-Nano nhận, ESP32 phát.
Debug | ESP_UART0_TX/RX | Cổng debug / nạp của ESP32 | Tách riêng với UART runtime 921600.

Cảnh báo điện áp

Bus I2C của cảm biến chạy ở miền 3.3 V. Không cấp 5 V trực tiếp vào AHT20, BH1750 hoặc vào các chân I/O của FPGA / ESP32.

Chỉ dùng 5 V ở đầu vào power tree của mask theo đúng thiết kế. Từ đó mới tạo các rail 3.3 V, 2.8 V, 1.2 V nếu project yêu cầu.

Nếu đo thấy rail 3.3 V thấp bất thường khi ESP32 kết nối Wi-Fi, phải dừng thí nghiệm và kiểm tra lại nguồn.

## 2.5. Chuẩn bị phần mềm và MQTT

• Nạp cấu hình .sof tương ứng bài lab cảm biến cho DE10-Nano theo Mục 1.

• Chuẩn bị tài khoản Wi-Fi và địa chỉ MQTT Broker mà giảng viên cung cấp. Nếu bộ môn có MQTT Broker nội bộ, ưu tiên dùng đúng địa chỉ IP hoặc domain của hệ thống đó.

• Tạo sẵn topic ví dụ aiot_mask/sensor_data hoặc topic chuẩn của lớp nếu giảng viên yêu cầu, ví dụ nhom_1/sensor_data.

• Nếu lớp có web dashboard có sẵn, sinh viên cần điền đúng MQTT Broker, đúng port và đúng topic mà dashboard đang lắng nghe.

## 2.6. Code mẫu cho ESP32 gateway

Đoạn mã dưới đây dùng cho kịch bản DE10-Nano đã tạo ra chuỗi runtime hoàn chỉnh. ESP32 chỉ việc nhận chuỗi đó và publish lên MQTT. Sinh viên phải thay đúng SSID, password, địa chỉ IP của MQTT Broker và topic chuẩn của lớp nếu giảng viên đã quy định.

### Mã nguồn ESP32 gateway (Wi-Fi + UART + MQTT)

#include <WiFi.h>

#include <PubSubClient.h>

// Thông số mạng và Broker (Sinh viên cần cập nhật đúng thông số của Lab)

const char* ssid = "LAB_WIFI_SSID";

const char* password = "LAB_WIFI_PASSWORD";

const char* mqtt_server = "192.168.1.xxx"; // Thay bằng IP của MQTT Broker

WiFiClient espClient;

PubSubClient client(espClient);

// Khởi tạo UART 2 cho giao tiếp với FPGA (RX=IO16, TX=IO17)

HardwareSerial FPGASerial(2);

void setup() {

Serial.begin(115200); // Dùng để debug trên máy tính

FPGASerial.begin(921600, SERIAL_8N1, 16, 17); // Giao tiếp Runtime với FPGA

WiFi.begin(ssid, password);

while (WiFi.status() != WL_CONNECTED) {

delay(500);

}

client.setServer(mqtt_server, 1883);

}

void reconnect() {

while (!client.connected()) {

if (client.connect("DE10_ESP32_Gateway")) {

// Đăng ký topic nhận lệnh (nếu có)

// client.subscribe("aiot_mask/control");

} else {

delay(5000);

}

}

}

void loop() {

if (!client.connected()) reconnect();

client.loop();

// Đọc dữ liệu Payload (JSON) từ FPGA và đẩy lên MQTT

if (FPGASerial.available()) {

String payload = FPGASerial.readStringUntil('\n');

client.publish("aiot_mask/sensor_data", payload.c_str());

}

}

## 2.7. Giải thích mã nguồn

• HardwareSerial FPGASerial(2) khởi tạo cổng UART runtime tách biệt với cổng debug Serial.

• FPGASerial.begin(921600, SERIAL_8N1, 16, 17) là dòng quan trọng nhất của phần phần cứng. Sai chân hoặc sai baudrate sẽ gây rác dữ liệu.

• client.publish("aiot_mask/sensor_data", payload.c_str()) publish nguyên dòng runtime lên topic MQTT. Nếu lớp đã có topic chuẩn như nhom_1/sensor_data, phải đổi đúng theo dashboard hoặc broker của môn học.

• Payload tốt nhất nên kết thúc bằng ký tự xuống dòng để ESP32 đọc từng khung rõ ràng.

## 2.8. Gợi ý định dạng payload

Ví dụ payload | Khi nào dùng | Ưu điểm
{"temp_c":29.4,"humidity_rh":62.1,"lux":415.0} | Dùng khi dashboard xử lý JavaScript hoặc Node-RED. | Dễ parse và dễ mở rộng thêm trường.
T=29.4,H=62.1,L=415 | Dùng cho bài lab rất cơ bản. | Nhìn trực tiếp trên Serial Monitor hoặc MQTT client rất nhanh.

Lưu ý rất quan trọng về JSON: nếu sinh viên tự đóng gói chuỗi ở phía FPGA hoặc logic phần cứng, phải giữ đúng cặp dấu ngoặc nhọn {}, dấu hai chấm :, dấu phẩy , và đặc biệt là dấu ngoặc kép "" quanh tên trường JSON. Chỉ cần thiếu một dấu ngoặc kép, payload có thể vẫn nhìn giống chuỗi ASCII nhưng sẽ không còn là JSON hợp lệ để dashboard hoặc script parse đúng.

## 2.9. Trình tự thực hành cho sinh viên

1. Nạp file .sof cho bài lab cảm biến vào DE10-Nano theo Mục 1.

2. Cấp nguồn cho hệ thống và quan sát trạng thái board.

3. Nạp code ESP32 gateway bằng cổng nạp / debug của chính module ESP32.

4. Mở Serial Monitor ở 115200 baud để kiểm tra ESP32 đã kết nối Wi-Fi hay chưa.

5. Quan sát xem có payload đi từ DE10-Nano sang ESP32 qua UART hay không.

6. Kiểm tra MQTT Broker hoặc web dashboard để xác nhận topic đang nhận dữ liệu mới.

7. Ghi lại kết quả thực nghiệm: độ trễ, chu kỳ cập nhật và giá trị đo.

## 2.10. Kết quả mong đợi và xử lý lỗi

Hiện tượng quan sát | Nguyên nhân thường gặp | Cách xử lý đầu tiên
ESP32 không lên Wi-Fi | Sai SSID / password hoặc nguồn 3.3 V không ổn. | Kiểm tra log debug, kiểm tra rail 3.3 V.
ESP32 lên Wi-Fi nhưng topic MQTT không có dữ liệu | Không có payload UART hoặc broker sai địa chỉ. | Kiểm tra trước ở Serial Monitor và thông số mqtt_server.
Payload UART bị rác | Sai baudrate 921600 hoặc dây RX/TX nhầm. | Kiểm tra lại IO16 / IO17 và thông số SERIAL_8N1.
Dashboard có kết nối nhưng số liệu không đổi | DE10-Nano không tạo payload mới hoặc đang publish sai topic. | Quay lại kiểm tra bài nạp .sof và payload runtime.
Giá trị sensor bất thường | Lỗi phần cảm biến, lỗi I2C hoặc logic gom dữ liệu trên DE10. | Tách bài kiểm tra thành sensor side, UART side rồi MQTT side.

# 3. Phần 2 - Hệ thống AI Camera Edge: OV2640 + FPGA DE10 + AI Light + MQTT -> Web

## 3.1. Mục tiêu

• Ghép nối phần cứng an toàn module camera OV2640 vào DE10-Nano qua bus dữ liệu song song 8-bit.

• Hiểu rõ các tín hiệu thời gian quan trọng như Pixel Clock (PCLK), Horizontal Sync (HSYNC), Vertical Sync (VSYNC) và External Clock (XCLK).

• Hiểu cơ chế chuyển mức điện áp của bus Serial Camera Control Bus (SCCB) giữa miền 3.3 V của FPGA và miền 2.8 V của camera.

• Nạp file .sof qua JTAG, kiểm tra các test point và xác nhận luồng AI Light -> UART -> MQTT -> web.

## 3.2. Thông số camera và năng lượng cần nhớ

Thông số | Giá trị | Ý nghĩa thực hành
Bus dữ liệu hình ảnh | DVP 8-bit | Camera phát dữ liệu song song CAM_D0 đến CAM_D7.
XCLK cấp cho camera | 24 MHz | Xung do FPGA cấp để camera chạy đúng mode.
PCLK của camera | Tối đa khoảng 36 MHz | Dùng để chốt dữ liệu ảnh theo từng pixel.
SCCB phía camera | 2.8 V | Phải qua level shifter trước khi sang phía FPGA 3.3 V.
Công suất module OV2640 | Khoảng 125 đến 140 mW | Dùng để đánh giá tải nguồn và nhiệt.

## 3.3. Mapping chân camera trên header JP7

Chân JP7 | Tín hiệu | Hướng dữ liệu | Ghi chú
JP7-01 đến JP7-08 | CAM_D0 đến CAM_D7 | FPGA IN | Bus dữ liệu hình ảnh.
JP7-09 | CAM_PCLK | FPGA IN | Xung nhịp pixel từ camera.
JP7-10 | CAM_HSYNC | FPGA IN | Xung đồng bộ dòng.
JP7-13 | CAM_VSYNC | FPGA IN | Xung đồng bộ khung hình.
JP7-14 | CAM_XCLK | FPGA OUT | Xung 24 MHz cấp cho camera.
JP7-15 | CAM_RESET | FPGA OUT | Đường reset camera.
JP7-33 | CAM_SCCB_SCL | FPGA BI | Bus cấu hình camera, phía FPGA 3.3 V.
JP7-34 | CAM_SCCB_SDA | FPGA BI | Bus cấu hình camera, phía FPGA 3.3 V.

## 3.4. Cảnh báo phần cứng đặc biệt của camera

• Bus SCCB ở phía FPGA và bus SCCB ở phía camera không cùng điện áp. Phía FPGA là 3.3 V; phía camera là 2.8 V.

• Mạch level shifter Q1, Q2 là bắt buộc để bảo vệ camera và đảm bảo giao tiếp ổn định.

• J1-03 phải nối với CAM_SIOD và J1-05 phải nối với CAM_SIOC theo đúng thiết kế của project.

• Không đưa trực tiếp tín hiệu 3.3 V vào miền 2.8 V của camera.

## 3.5. Trình tự thực hành camera AI

1. Nạp file .sof của bài lab camera qua JTAG theo Mục 1.

2. Kiểm tra các đầu nối camera, cáp và chiều gắn module OV2640.

3. Cấp nguồn cho hệ thống, quan sát các tín hiệu trạng thái trên board.

4. Dùng dao động ký đo Test Point CAM_XCLK để xác nhận có xung 24 MHz.

5. Dùng dao động ký đo Test Point CAM_PCLK để xác nhận camera đang phát dữ liệu theo mode hiện hành.

6. Theo dõi Test Point TP_FPGA_TX_TO_ESP_RX để xem có gói runtime chuyển sang ESP32 hay không.

7. Quan sát dashboard trên web để kiểm tra kết quả AI Light đã được publish qua MQTT.

## 3.6. Bảng test point và điểm xác nhận

Điểm đo / nơi quan sát | Dấu hiệu đúng | Ý nghĩa
TP_CAM_XCLK | Có xung vuông khoảng 24 MHz. | FPGA đã cấp clock ra camera.
TP_CAM_PCLK | Có xung pixel phụ thuộc mode, tối đa khoảng 36 MHz. | Camera đang phát dữ liệu hình ảnh.
TP_FPGA_TX_TO_ESP_RX | Có gói runtime dạng chuỗi hoặc burst dữ liệu. | Khối AI / runtime đã gửi kết quả sang ESP32.
Web dashboard | Xuất hiện trạng thái hoặc nhãn inference mới. | Chuỗi MQTT end-to-end đang hoạt động.

## 3.7. Kết quả mong đợi và xử lý lỗi

Hiện tượng quan sát | Nguyên nhân thường gặp | Cách xử lý đầu tiên
Không thấy CAM_XCLK | Sai file .sof, khối clock chưa chạy hoặc chân mapping sai. | Nạp lại .sof và kiểm tra mapping chân.
Có CAM_XCLK nhưng không thấy CAM_PCLK | Camera chưa được reset đúng, SCCB cấu hình lỗi hoặc cáp camera lắp sai. | Kiểm tra reset, SCCB và hướng cáp.
Có UART runtime nhưng web không cập nhật | ESP32 chưa kết nối broker hoặc publish sai topic. | Kiểm tra log Wi-Fi và topic MQTT.
Ảnh hoặc inference không ổn định | Nhiễu nguồn, dây camera không chắc hoặc timing chưa ổn. | Kiểm tra nguồn camera và đầu nối.
Camera phản ứng bất thường sau khi cắm lại | Đã tác động sai vào miền 2.8 V hoặc cáp lỏng. | Ngắt nguồn ngay, kiểm tra lại wiring và mạch level shifter.

## 3.8. Mã nguồn mẫu cho phần 2

Phần 2 của manual trước đây đã mô tả kiến trúc và quy trình nạp cấu hình qua JTAG, nhưng chưa nhúng bộ mã nguồn khởi động để sinh viên quan sát luồng dữ liệu Camera -> FPGA -> UART -> ESP32 -> MQTT. Mục này bổ sung bộ mã nguồn tối thiểu theo hướng sư phạm: dễ đọc, dễ build và đủ để sinh viên thấy tín hiệu runtime đi từ DE10-Nano sang ESP32 gateway.

Cần nhấn mạnh: các đoạn mã dưới đây là starter code cho buổi lab. Chúng không thay thế toàn bộ project camera AI production. Cấu hình thanh ghi OV2640 qua Serial Camera Control Bus (SCCB), bộ thu dữ liệu ảnh đầy đủ và nhân AI Light của project có thể vẫn được giảng viên cung cấp dưới dạng file Quartus hoặc file .sof build sẵn.

### 3.8.1. Cấu trúc file đề xuất

- `top_camera_ai_demo.v`: top-level tối thiểu cho bài lab camera.
- `uart_tx.v`: bộ phát Universal Asynchronous Receiver/Transmitter (UART) một chiều từ FPGA sang ESP32.
- `pll_cam_xclk`: IP tạo xung 24 MHz cho chân CAM_XCLK. Tạo bằng Intel Quartus Prime IP Catalog dựa trên clock hệ thống của board.
- `ov2640_sccb_init.v` hoặc block tương đương: khởi tạo thanh ghi camera nếu lớp học muốn đi sâu hơn vào cấu hình OV2640.

### 3.8.2. Mã nguồn uart_tx.v

Module dưới đây phát dữ liệu ASCII từ FPGA sang ESP32 ở tốc độ 921600 baud. Tham số `CLKS_PER_BIT` cần tính lại nếu clock đầu vào khác 50 MHz.

module uart_tx #(

parameter integer CLKS_PER_BIT = 54

)(

input wire clk,

input wire rst_n,

input wire start,

input wire [7:0] data_in,

output reg tx,

output reg busy,

output reg done

);

reg [3:0] bit_idx;

reg [15:0] clk_cnt;

reg [9:0] shift_reg;

always @(posedge clk or negedge rst_n) begin

if (!rst_n) begin

tx <= 1'b1;

busy <= 1'b0;

done <= 1'b0;

bit_idx <= 4'd0;

clk_cnt <= 16'd0;

shift_reg <= 10'h3FF;

end else begin

done <= 1'b0;

if (!busy) begin

tx <= 1'b1;

if (start) begin

busy <= 1'b1;

bit_idx <= 4'd0;

clk_cnt <= 16'd0;

shift_reg <= {1'b1, data_in, 1'b0}; // stop, data[7:0], start

tx <= 1'b0;

end

end else begin

if (clk_cnt == CLKS_PER_BIT - 1) begin

clk_cnt <= 16'd0;

bit_idx <= bit_idx + 1'b1;

shift_reg <= {1'b1, shift_reg[9:1]};

tx <= shift_reg[1];

if (bit_idx == 4'd9) begin

busy <= 1'b0;

done <= 1'b1;

tx <= 1'b1;

end

end else begin

clk_cnt <= clk_cnt + 1'b1;

end

end

end

end

endmodule

### 3.8.3. Mã nguồn top_camera_ai_demo.v

Top-level sau đây tạo xung 24 MHz cho camera, quan sát tín hiệu VSYNC để biết camera đã có frame, rồi gửi một payload JSON tối thiểu qua UART sang ESP32. Đây là bản demo rất phù hợp cho bài lab mở đầu, vì sinh viên có thể kiểm tra tuần tự: JTAG ok, XCLK ok, camera có frame, UART có dữ liệu, MQTT có dữ liệu.

module top_camera_ai_demo (

input wire CLOCK_50,

input wire RESET_N,

input wire CAM_PCLK,

input wire CAM_HSYNC,

input wire CAM_VSYNC,

input wire [7:0] CAM_D,

output wire CAM_XCLK,

output wire UART_TX,

output reg [1:0] LED

);

wire clk_24m;

wire pll_locked;

// Tạo bằng IP Catalog trong Quartus: 50 MHz -> 24 MHz

pll_cam_xclk u_pll (

.refclk (CLOCK_50),

.rst (~RESET_N),

.outclk_0 (clk_24m),

.locked (pll_locked)

);

assign CAM_XCLK = clk_24m;

reg cam_vsync_d;

reg frame_seen;

always @(posedge CLOCK_50 or negedge RESET_N) begin

if (!RESET_N) begin

cam_vsync_d <= 1'b0;

frame_seen <= 1'b0;

end else begin

cam_vsync_d <= CAM_VSYNC;

if (CAM_VSYNC && !cam_vsync_d)

frame_seen <= 1'b1;

end

end

localparam integer HEARTBEAT_MAX = 50_000_000;

reg [25:0] heartbeat_cnt;

reg send_request;

always @(posedge CLOCK_50 or negedge RESET_N) begin

if (!RESET_N) begin

heartbeat_cnt <= 26'd0;

send_request <= 1'b0;

end else begin

send_request <= 1'b0;

if (heartbeat_cnt == HEARTBEAT_MAX - 1) begin

heartbeat_cnt <= 26'd0;

if (frame_seen && pll_locked)

send_request <= 1'b1;

end else begin

heartbeat_cnt <= heartbeat_cnt + 1'b1;

end

end

end

reg tx_start;

reg [7:0] tx_data;

wire tx_busy;

wire tx_done;

uart_tx #(

.CLKS_PER_BIT(54)

) u_uart_tx (

.clk (CLOCK_50),

.rst_n (RESET_N),

.start (tx_start),

.data_in(tx_data),

.tx (UART_TX),

.busy (tx_busy),

.done (tx_done)

);

reg sending;

reg [5:0] msg_idx;

function [7:0] msg_byte;

input [5:0] idx;

begin

case (idx)

6'd0 : msg_byte = 8'h7B; // {

6'd1 : msg_byte = 8'h22; // "

6'd2 : msg_byte = "c";

6'd3 : msg_byte = "a";

6'd4 : msg_byte = "m";

6'd5 : msg_byte = "e";

6'd6 : msg_byte = "r";

6'd7 : msg_byte = "a";

6'd8 : msg_byte = 8'h22; // "

6'd9 : msg_byte = 8'h3A; // :

6'd10: msg_byte = 8'h22; // "

6'd11: msg_byte = "o";

6'd12: msg_byte = "k";

6'd13: msg_byte = 8'h22; // "

6'd14: msg_byte = 8'h2C; // ,

6'd15: msg_byte = 8'h22; // "

6'd16: msg_byte = "a";

6'd17: msg_byte = "i";

6'd18: msg_byte = 8'h22; // "

6'd19: msg_byte = 8'h3A; // :

6'd20: msg_byte = 8'h22; // "

6'd21: msg_byte = "d";

6'd22: msg_byte = "e";

6'd23: msg_byte = "m";

6'd24: msg_byte = "o";

6'd25: msg_byte = 8'h22; // "

6'd26: msg_byte = 8'h7D; // }

6'd27: msg_byte = 8'h0A; // newline

default: msg_byte = 8'h20;

endcase

end

endfunction

localparam integer MSG_LEN = 28;

always @(posedge CLOCK_50 or negedge RESET_N) begin

if (!RESET_N) begin

sending <= 1'b0;

msg_idx <= 6'd0;

tx_start <= 1'b0;

tx_data <= 8'h00;

LED <= 2'b00;

end else begin

tx_start <= 1'b0;

LED[0] <= pll_locked;

LED[1] <= frame_seen;

if (!sending && send_request && !tx_busy) begin

sending <= 1'b1;

msg_idx <= 6'd0;

tx_data <= msg_byte(6'd0);

tx_start <= 1'b1;

end else if (sending && tx_done) begin

if (msg_idx == MSG_LEN - 1) begin

sending <= 1'b0;

end else begin

msg_idx <= msg_idx + 1'b1;

tx_data <= msg_byte(msg_idx + 1'b1);

tx_start <= 1'b1;

end

end

end

end

endmodule

### 3.8.4. Lưu ý rất quan trọng khi dùng source code mẫu

- `pll_cam_xclk` không phải là module viết tay. Sinh viên hoặc giảng viên cần tạo IP PLL trong Intel Quartus Prime để sinh ra đúng xung 24 MHz cho OV2640.
- Code mẫu trên gửi payload JSON cố định `{"camera":"ok","ai":"demo"}` nhằm xác minh đường truyền runtime. Khi tích hợp nhân AI Light thật, chỉ cần thay nội dung payload bằng nhãn nhận diện hoặc trạng thái thật.
- Nếu sinh viên tự đóng gói payload JSON trong FPGA, phải giữ đúng dấu ngoặc kép `"` theo chuẩn JSON. Thiếu ngoặc kép là lỗi rất hay gặp và làm ESP32 hoặc dashboard web parse sai dữ liệu.
- Bus SCCB của camera đi qua mạch chuyển mức 3.3 V sang 2.8 V. Không được đưa trực tiếp tín hiệu 3.3 V vào phía 2.8 V của OV2640.
- File `.sof` là file cấu hình bay hơi. Sau khi tắt nguồn DE10-Nano, phải nạp lại nếu chưa chuyển sang cơ chế lưu cấu hình khác.

# 4. Phụ lục

## 4.1. Checklist 15 phút cho sinh viên

Bước | Việc phải làm | Tích
1 | Kiểm tra nguồn, Ground chung và chiều gắn mask.
2 | Nạp đúng file .sof qua JTAG.
3 | Nạp code cho ESP32 gateway.
4 | Mở Serial Monitor 115200 và kiểm tra log.
5 | Kiểm tra UART runtime có payload.
6 | Kiểm tra MQTT Broker hoặc dashboard.
7 | Ghi lại kết quả đo / inference và lỗi gặp phải.

## 4.2. Lưu ý cho giảng viên hoặc mentor

• Nên phát file .sof, địa chỉ MQTT Broker và topic chuẩn trước giờ lab để tiết kiệm thời gian.

• Khi sinh viên báo lỗi, luôn tách kiểm tra theo thứ tự: nguồn -> JTAG -> runtime UART -> MQTT -> dashboard.

• Không cho sinh viên thay đổi đồng thời nhiều biến trong một lần thử; nên khóa trước phần cứng, sau đó mới cho sửa phần mềm.

• Nếu lớp chia hai buổi, buổi đầu chỉ nên chốt đường truyền cảm biến và MQTT; buổi sau mới mở phần camera AI.

## 4.3. Kết luận ngắn

Giá trị học tập cốt lõi của manual này không chỉ nằm ở việc 'thấy dữ liệu trên web', mà ở việc sinh viên hiểu được vai trò tách bạch của từng khối trong một hệ thống AIoT thật: DE10-Nano xử lý phần cứng, mask tổ chức ngoại vi, ESP32 giữ vai trò mạng, còn MQTT làm lớp phân phối dữ liệu để quan sát và giám sát.

AIoT Vision Mask Lab Manual - DE10-Nano / Sensor / Camera / MQTT
