ctw-design-team/aiot-mask-de10-nano-v2/Manual/AIoT_Vision_Mask_Current_Map.pdf

AIoT Vision Mask — Current Map v2 clean

AIoT Vision Mask for DE10-Nano | Page 1

# AIoT Vision Mask — Current Map v2 clean

## Per-page, per-wire, and per-device current summary and review budget

Version v2 clean. Scope covers the active electrical sheets S1 through S5; S6 debug/test adds observability only and does not introduce a new current source or sink. Open-drain buses have exact LOW-state currents from the pull-up resistors. Push-pull logic nets are dynamic and are listed only as engineering estimates for review.

# Page-by-page summary

Page | Main current picture | Status / interpretation
S1_POWER_TREE | V3V3_SYS must support ESP32 RF peaks plus camera branch and sensors | Project target ≥ 500 mA continuous capability
S2_CAMERA_OV2640_FPC | OV2640 module power class 125–140 mW typical depending on mode | Aggregate published module value; rail split is a design budget assumption
S3_SCCB_LEVEL_SHIFTER | Each SCCB line sinks a resistor-defined current only while LOW | Exact from pull-up values
S4_ESP32_MODULE | ESP32 RF current varies strongly with mode; worst entry used here is 379 mA peak | Published module value
S5_SENSORS_I2C | Sensor silicon currents are small; bus pull-up currents dominate when LOW | Exact for pull-ups; device currents are planning values
S6_DEBUG_AND_TEST_ZONE | Only mirrors existing nets for measurement access | No new current source or sink beyond replicated nets

# Per-device current map

Device / block | Current / power value | Type | Notes
U7 MCP1826S | 120 µA typ. quiescent; 1000 mA max output capability | Published | Chosen 3.3 V system LDO
ESP32-WROOM-32E | TX 802.11b: 239 mA avg / 379 mA peak; RX 20 MHz: 112 mA | Published | Design supply should have ≥500 mA capability
OV2640 module | 125 mW typ. (UXGA YUV, 15 fps); 140 mW typ. (UXGA compressed, 15 fps) | Published aggregate | Not a per-rail split
AHT20 sensor core | ≈23 µA measurement-average; ≈0.25 µA sleep | Planning value | Use as order-of-magnitude estimate
BH1750 sensor core | ≈190 µA active; ≈1.0 µA power-down | Published family material | Tiny compared with ESP32
Sensor I2C pull-up pair (4.7 kΩ, 3.3 V) | 0.702 mA per line while LOW; 1.404 mA if both LOW | Exact | Applies to S5 bus
Camera SCCB pull-up pair (2.2 kΩ to 3.3 V and 2.2 kΩ to 2.8 V) | 2.773 mA per active LOW line | Exact | Applies to S3 level shifter

# S1 — Power Tree current budget

Item | Value | Type | Notes
V3V3_SYS regulator capability target | ≥ 500 mA continuous | Project requirement | Chosen for ESP32 RF margin
U7 output capability | 1000 mA max | Published | Margin beyond project minimum
Estimated heavy-use system average | ~281 mA | Engineering budget | 239 mA ESP32 TX avg + ~42 mA camera branch + tiny sensors
Estimated heavy-use system peak | ~421 mA | Engineering budget | 379 mA ESP32 peak + ~42 mA camera branch + tiny sensors
Estimated V5_IN current into linear 3.3 V stage | Same order as 3.3 V output current | Engineering budget | For an LDO, input current roughly tracks output current

The camera branch number above is a working upstream budget, not a published per-rail split. It is suitable for regulator sizing and review, but it should not be treated as final laboratory sign-off until measured on the chosen module.

# S2 — Camera OV2640 FPC (per wire / branch)

Item | Value | Type | Notes
V2V8_CAM + V1V2_CAM aggregate camera load | ~45–50 mA equivalent at camera rails | Engineering budget | Derived from 125–140 mW aggregate module power
CAM_XCLK | ~0.67 mA at 2.8 V, 24 MHz, 10 pF | Engineering estimate | Dynamic charging current into camera clock input
CAM_PCLK | ~2.5 mA at 2.8 V, 36 MHz, 25 pF | Engineering estimate | Representative worst-case capacitive load
Each CAM_Dx line | Sub-mA to a few mA instantaneous depending on activity | Engineering estimate | Data-dependent dynamic current
CAM_RESET / CAM_PWDN | Near 0 mA static; event-driven | Qualitative | Control inputs, not rail budget drivers

# S3 — SCCB Level Shifter

Item | Value | Type | Notes
CAM_SCCB_SCL / CAM_SIOC when LOW | 3.3/2.2k + 2.8/2.2k = 2.773 mA | Exact | LOW-state sink current through both pull-ups
CAM_SCCB_SDA / CAM_SIOD when LOW | 3.3/2.2k + 2.8/2.2k = 2.773 mA | Exact | LOW-state sink current through both pull-ups
Either SCCB line when HIGH | ~0 mA DC | Exact idealized | Only leakage remains

# S4 — ESP32 Module

Item | Value | Type | Notes
ESP32 V3V3 rail | 112 mA RX to 239 mA avg / 379 mA peak TX | Published | Mode-dependent RF current
Runtime UART lines | Very small DC; dynamic edge charging only | Engineering estimate | Not a rail budget driver
ESP_EN / ESP_IO0 pull-ups (10 kΩ to 3.3 V) | 0.33 mA each only when actively forced LOW | Exact | Otherwise ~0 mA DC

# S5 — Sensors I2C

Item | Value | Type | Notes
I2C_SCL when LOW | 3.3/4.7k = 0.702 mA | Exact | Sensor bus pull-up current
I2C_SDA when LOW | 3.3/4.7k = 0.702 mA | Exact | Sensor bus pull-up current
Both I2C lines LOW together | 1.404 mA | Exact | Sum of the two pull-ups
AHT20 active average | ~23 µA | Planning value | Small compared with pull-up current during bus LOW
BH1750 active | ~190 µA | Published family material | Small compared with ESP32 current

# Practical interpretation

Sizing is dominated by the 3.3 V rail and the ESP32 RF peak. Sensor pull-up currents are exact and small. Camera signal-line currents should be treated as dynamic edge-charging estimates rather than fixed DC values.
