ctw-design-team/aiot-mask-de10-nano-v2/Manual/AIoT_Vision_Mask_Frequency_Map.pdf

AIoT Vision Mask — Frequency Map v2 clean

AIoT Vision Mask for DE10-Nano | Page 1

# AIoT Vision Mask — Frequency Map v2 clean

## Per-page, per-wire, and per-device operating frequency summary

Version v2 clean. Scope covers the active electrical sheets S1 through S5. S6 debug/test only mirrors existing nets for observability, so it is listed in the page summary but omitted from the per-wire operating tables. Values are labeled as frozen, device-property, working-range, or engineering-estimate where appropriate.

# Page-by-page summary

Page | Main frequency items | Status / interpretation
S1_POWER_TREE | V5_IN, V3V3_SYS, V3V3_CAM, V2V8_CAM, V1V2_CAM are DC rails | 0 Hz nominal; no single AC operating frequency
S2_CAMERA_OV2640_FPC | CAM_XCLK 24 MHz; CAM_PCLK up to ~36 MHz; frame classes 15/30/60 fps | XCLK frozen; PCLK/frame cadence mode-dependent
S3_SCCB_LEVEL_SHIFTER | Camera SCCB practical range 100–400 kHz | Working design range; 400 kHz practical ceiling
S4_ESP32_MODULE | 40 MHz crystal, CPU 80–240 MHz, Wi■Fi 2.4 GHz, runtime UART 921600 baud | Runtime UART frozen; other values are device properties
S5_SENSORS_I2C | I2C 100 kHz default, 400 kHz max | AHT20/BH1750 shared 3.3 V I2C
S6_DEBUG_AND_TEST_ZONE | Only mirrors existing nets for observability | No new operating frequency; omitted from per-wire analysis

# Per-device frequency map

Device / block | Key frequencies | Notes
U7 MCP1826S 3.3 V LDO | 0 Hz nominal | Linear regulator; no switching clock
U2 2.8 V LDO | 0 Hz nominal | Linear regulator; no switching clock
U3 1.2 V LDO | 0 Hz nominal | Linear regulator; no switching clock
OV2640 camera | XCLK 24 MHz exact; PCLK up to ~36 MHz; 15/30/60 fps classes | PCLK and sync cadence depend on active mode and blanking
ESP32-WROOM-32E | 40 MHz crystal; CPU 80–240 MHz; Wi■Fi/Bluetooth 2.4 GHz | Runtime UART is system-defined, not intrinsic
AHT20 | I2C 10–400 kHz recommended; sample cycle >1 s recommended | Higher polling can self-heat sensor
BH1750 | I2C fast mode 400 kHz; H-resolution ~120 ms; L-resolution ~16 ms | Measurement time acts like update cadence

# S1 — Power Tree (per wire)

Wire / net | Nominal frequency | Classification | Notes
V5_IN | 0 Hz | DC rail | 5 V input from DE10-Nano header
V3V3_SYS | 0 Hz | DC rail | Main system 3.3 V rail
V3V3_CAM | 0 Hz | DC rail | Camera branch after ferrite bead
V2V8_CAM | 0 Hz | DC rail | Camera analog + I/O rail in this design
V1V2_CAM | 0 Hz | DC rail | Camera core rail

# S2 — Camera OV2640 FPC (per wire)

Wire / net | Frequency | Status | Notes
CAM_XCLK | 24 MHz exact | Frozen | Clock from FPGA to camera
CAM_PCLK | Mode-dependent, up to ~36 MHz | Device-dependent | Pixel clock from camera
CAM_VSYNC | 15 / 30 / 60 Hz frame cadence class | Mode-dependent | One frame sync per frame
CAM_HSYNC | Approx. 17–18 kHz active line cadence | Engineering estimate | Order-of-magnitude review value
CAM_D0…CAM_D7 | Synchronous with CAM_PCLK | Mode-dependent | Bit activity depends on image content
CAM_RESET | 0 Hz nominal / event-driven | Static control | Toggles only during init / recovery
CAM_PWDN | 0 Hz nominal / event-driven | Static control | Toggles only during power sequencing / recovery

# S3 — SCCB Level Shifter (per wire)

Wire / net | Frequency range | Status | Notes
CAM_SCCB_SCL / CAM_SIOC | 100 kHz default; 400 kHz max practical | Working design range | Same traffic mirrored across shifter
CAM_SCCB_SDA / CAM_SIOD | 100 kHz default; 400 kHz max practical | Working design range | Open-drain data line

# S4 — ESP32 Module (per wire)

Wire / net | Frequency | Status | Notes
ESP_UART0_TX / RX | 115200 baud typical programming default | Configuration-dependent | Programming header traffic
FPGA_TX_TO_ESP_RX / FPGA_RX_FROM_ESP_TX 921600 baud, 8N1 | | Frozen design value | Runtime UART link
ESP_EN | 0 Hz nominal / event-driven | Static control | Reset / enable
ESP_IO0 | 0 Hz nominal / event-driven | Static control | Boot strap

# S5 — Sensors I2C (per wire)

Wire / net | Frequency | Status | Notes
I2C_SCL | 100 kHz default; 400 kHz max | Frozen working range | Shared sensor bus
I2C_SDA | 100 kHz default; 400 kHz max | Frozen working range | Shared sensor bus
BH1750 update cadence | ~8.3 Hz typical at 120 ms; ~62.5 Hz at 16 ms | Mode-dependent | Measurement time dependent
AHT20 update cadence | >1 s recommended polling interval | Recommended usage | Avoid self-heating

# Practical interpretation

For layout and timing review, the only nets that should be treated as high-speed review items are CAM_XCLK, CAM_PCLK, and the camera data bus CAM_D0…CAM_D7. I2C and SCCB are comparatively slow control buses. Power rails remain 0 Hz nominal DC rails even though they carry ripple, transients, and radio-noise content.
