ctw-design-team/aiot-mask-de10-nano-v2/Manual/AIoT_Vision_Mask_PinMap_Freeze.pdf

AIoT Vision Mask — Pin Map Freeze v2 clean

AIoT Vision Mask for DE10-Nano | Page 1

# AIoT Vision Mask — Pin Map Freeze v2 clean

## Connector-level freeze for the revised schematic set

Version v2 clean. This revision removes ambiguity in the camera control-line notes, keeps the SCCB 3.3 V ↔ 2.8 V split explicit, and presents the design as a connector-level freeze. GPIO_1_Dxx aliases can still be back-annotated later without changing the connector pin assignments.

# Locked design decisions

OV2640 DVP 8-bit camera. CAM_XCLK = 24 MHz. Sensor bus I2C 3.3 V shared by AHT20 and BH1750. Camera SCCB kept separate and level-shifted between 3.3 V and 2.8 V. ESP32 runtime UART kept separate from UART0 programming. DOVDD = 2.8 V.

# JP7 connector freeze

JP7 pin | Signal | Direction | Domain | Series R | TP | Notes
01 | CAM_D0 | FPGA_IN | 3.3 V | Yes | Yes | OV2640 D2
02 | CAM_D1 | FPGA_IN | 3.3 V | Yes | Optional | OV2640 D3
03 | CAM_D2 | FPGA_IN | 3.3 V | Yes | Optional | OV2640 D4
04 | CAM_D3 | FPGA_IN | 3.3 V | Yes | Optional | OV2640 D5
05 | CAM_D4 | FPGA_IN | 3.3 V | Yes | Optional | OV2640 D6
06 | CAM_D5 | FPGA_IN | 3.3 V | Yes | Optional | OV2640 D7
07 | CAM_D6 | FPGA_IN | 3.3 V | Yes | Optional | OV2640 D8
08 | CAM_D7 | FPGA_IN | 3.3 V | Yes | Optional | OV2640 D9
09 | CAM_PCLK | FPGA_IN | 3.3 V | Yes | Yes | Pixel clock from camera
10 | CAM_HSYNC | FPGA_IN | 3.3 V | No | Yes | HSYNC
11 | NC / Reserved | — | — | — | — | Spare
12 | NC / Reserved | — | — | — | — | Spare
13 | CAM_VSYNC | FPGA_IN | 3.3 V | No | Yes | VSYNC
14 | CAM_XCLK | FPGA_OUT | 3.3 V | Yes | Yes | 24 MHz from FPGA

JP7 pin | Signal | Direction | Domain | Series R | TP | Notes
15 | CAM_RESET | FPGA_OUT | 3.3 V driver | No | Yes | Control line to camera
16 | CAM_PWDN | FPGA_OUT | 3.3 V driver | No | Optional | Control line to camera
17–29 | NC / Reserved | — | — | — | — | Spare range
30 | GND | — | 0 V | — | RecommendedCommon return
31 | I2C_SCL | FPGA_BI | 3.3 V | No | Yes | Sensor I2C bus
32 | I2C_SDA | FPGA_BI | 3.3 V | No | Yes | Sensor I2C bus
33 | CAM_SCCB_SCL | FPGA_BI | 3.3 V | No | Yes | Camera SCCB, FPGA side
34 | CAM_SCCB_SDA | FPGA_BI | 3.3 V | No | Yes | Camera SCCB, FPGA side
35–40 | RESERVED_SPARE | — | — | — | — | Future expansion

# Camera connector J1 (24 pin)

J1 pin | Net schematic | Domain / class | Notes
01 | NC | — | No connect
02 | GND | 0 V | AGND
03 | CAM_SIOD | 2.8 V I/O | SIO_D, camera side of SCCB
04 | V2V8_CAM | 2.8 V | AVDD
05 | CAM_SIOC | 2.8 V I/O | SIO_C, camera side of SCCB
06 | CAM_RESET | Control input | Driven from FPGA side; verify module tolerance / add option if needed
07 | CAM_VSYNC | 2.8 V I/O | VS
08 | CAM_PWDN | Control input | Driven from FPGA side; verify module tolerance / add option if needed
09 | CAM_HSYNC | 2.8 V I/O | HS
10 | V1V2_CAM | 1.2 V | DVDD
11 | V2V8_CAM | 2.8 V | DOVDD = 2.8 V
12 | CAM_D7 | 2.8 V I/O | OV2640 D9
13 | CAM_XCLK | 2.8 V I/O | MCLK
14 | CAM_D6 | 2.8 V I/O | OV2640 D8
15 | GND | 0 V | DGND
16 | CAM_D5 | 2.8 V I/O | OV2640 D7
17 | CAM_PCLK | 2.8 V I/O | PCLK
18 | CAM_D4 | 2.8 V I/O | OV2640 D6
19 | CAM_D0 | 2.8 V I/O | OV2640 D2
20 | CAM_D3 | 2.8 V I/O | OV2640 D5
21 | CAM_D1 | 2.8 V I/O | OV2640 D3
22 | CAM_D2 | 2.8 V I/O | OV2640 D4

J1 pin | Net schematic | Domain / class | Notes
23 | NC | — | No connect
24 | NC | — | No connect
SH1 | GND | 0 V | Shield
SH2 | GND | 0 V | Shield

# OV2640 data mapping

Project logic name | OV2640 original pin
CAM_D0 | OV2640_D2
CAM_D1 | OV2640_D3
CAM_D2 | OV2640_D4
CAM_D3 | OV2640_D5
CAM_D4 | OV2640_D6
CAM_D5 | OV2640_D7
CAM_D6 | OV2640_D8
CAM_D7 | OV2640_D9

# SCCB level shifter

Source | 3.3 V side | Shift element | 2.8 V side | Camera pin
JP7-33 | CAM_SCCB_SCL | Q1 high-side | CAM_SIOC | J1-05
JP7-34 | CAM_SCCB_SDA | Q2 high-side | CAM_SIOD | J1-03

R5 and R6 pull up to V3V3_SYS. R7 and R8 pull up to V2V8_CAM. Q1 and Q2 are bidirectional MOSFET shifters with gate tied to V2V8_CAM. J1-03 must remain CAM_SIOD and J1-05 must remain CAM_SIOC.

# ESP32 and external connectors

Point | Net | Meaning | Notes
ESP32 IO16 | FPGA_TX_TO_ESP_RX | Runtime RX at ESP32 | 0 Ω option in series
ESP32 IO17 | FPGA_RX_FROM_ESP_TX | Runtime TX from ESP32 | 0 Ω option in series
J_PROG-06 | V3V3_SYS | Programming header supply reference | Use only if needed
J_PROG-05 | GND | Programming header ground | Common return
J_PROG-04 | ESP_UART0_TX | Programming UART0 TX | Header side
J_PROG-03 | ESP_UART0_RX | Programming UART0 RX | Header side
J_PROG-02 | ESP_EN | Boot / reset control | 10 kΩ pull-up + RC
J_PROG-01 | ESP_IO0 | Boot strap | 10 kΩ pull-up, no large cap
Point | Net | Meaning
JP7-31 | I2C_SCL | Sensor I2C clock, 3.3 V
JP7-32 | I2C_SDA | Sensor I2C data, 3.3 V
J_SENSOR-1 | V3V3_SYS | External sensor header power
J_SENSOR-2 | GND | External sensor header ground
J_SENSOR-3 | I2C_SCL | External sensor header SCL
J_SENSOR-4 | I2C_SDA | External sensor header SDA
BH1750 ADDR | GND | Address fixed at 0x23

# Power rails

Rail | Origin | Function
V5_IN | Input from DE10-Nano | 5 V source
V3V3_SYS | U7 output | Main system 3.3 V for ESP32 + sensors + 3.3 V comms
V3V3_CAM | After ferrite bead L1 | Camera branch / isolation source
V2V8_CAM | U2 output | OV2640 AVDD + DOVDD + camera-side SCCB pull-up
V1V2_CAM | U3 output | OV2640 DVDD core rail

# Minimum debug / test-point set

Test point | Net
TP_V5_IN | V5_IN
TP_V3V3_SYS | V3V3_SYS
TP_V3V3_CAM | V3V3_CAM
TP_V2V8_CAM | V2V8_CAM
TP_V1V2_CAM | V1V2_CAM
TP_CAM_XCLK | CAM_XCLK
TP_CAM_PCLK | CAM_PCLK
TP_CAM_VSYNC | CAM_VSYNC
TP_CAM_HSYNC | CAM_HSYNC
TP_CAM_RESET | CAM_RESET
TP_CAM_D0 | CAM_D0
TP_CAM_SCCB_SCL | CAM_SCCB_SCL
TP_CAM_SCCB_SDA | CAM_SCCB_SDA
TP_CAM_SIOC | CAM_SIOC

Test point | Net
TP_CAM_SIOD | CAM_SIOD
TP_I2C_SCL | I2C_SCL
TP_I2C_SDA | I2C_SDA
TP_FPGA_TX_TO_ESP_RX | FPGA_TX_TO_ESP_RX
TP_FPGA_RX_FROM_ESP_TX | FPGA_RX_FROM_ESP_TX
TP_ESP_UART0_TX | ESP_UART0_TX
TP_ESP_UART0_RX | ESP_UART0_RX
TP_ESP_EN | ESP_EN
TP_ESP_IO0 | ESP_IO0
TP_GND_PWR | GND
TP_GND_CAM | GND
TP_GND_COMMS | GND
