ctw-design-team/aiot-mask-de10-nano-v2/SCHEMATIC/123456.pdf

01 | 01 02 | 02 03 | 03 04 | 04 05 | 05 06 | 06

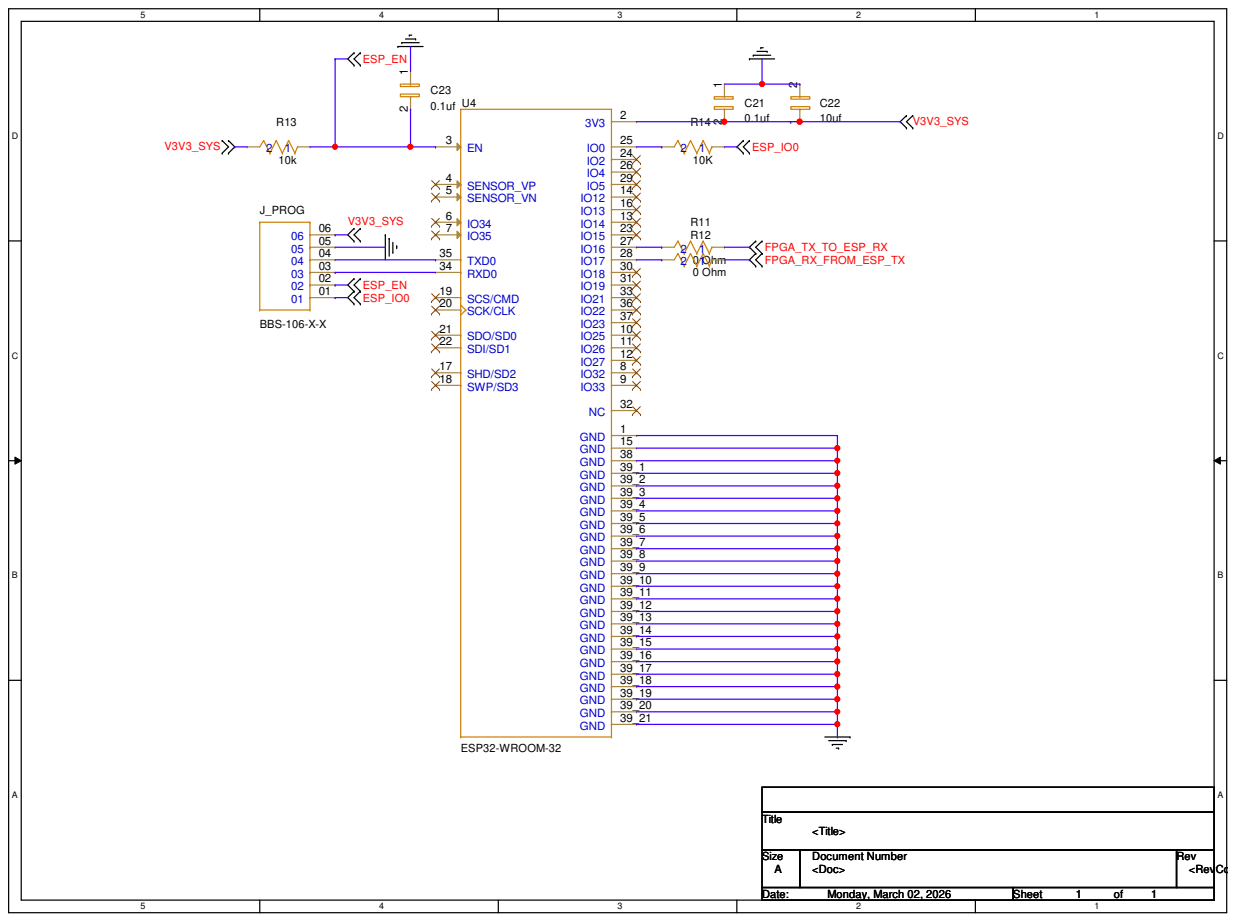
[picture p19: page 1]
V3V3_SYS; FPGA_TX_TO_ESP_RX FPGA_RX_FROM_ESP_TX; ESP_EN; ESP_IO0; ESP_EN ESP_IO0; Title; Size; Document Number; Rev; Date:; Sheet; <Doc>; <RevCo; <Title>; 1Monday, March 02, 2026; 0 Ohm; ESP32-WROOM-32; GND; SENSOR_VP; SENSOR_VN; SHD/SD2 17 SWP/SD3 18; SCS/CMD 19 SCK/CLK 20; SDO/SD0 21 SDI/SD1 22; RXD0 34; TXD0 35; J_PROG; BBS-106-X-X
