ctw-design-team/aiot-mask-de10-nano-v2/SCHEMATIC/S0_TOP.pdf

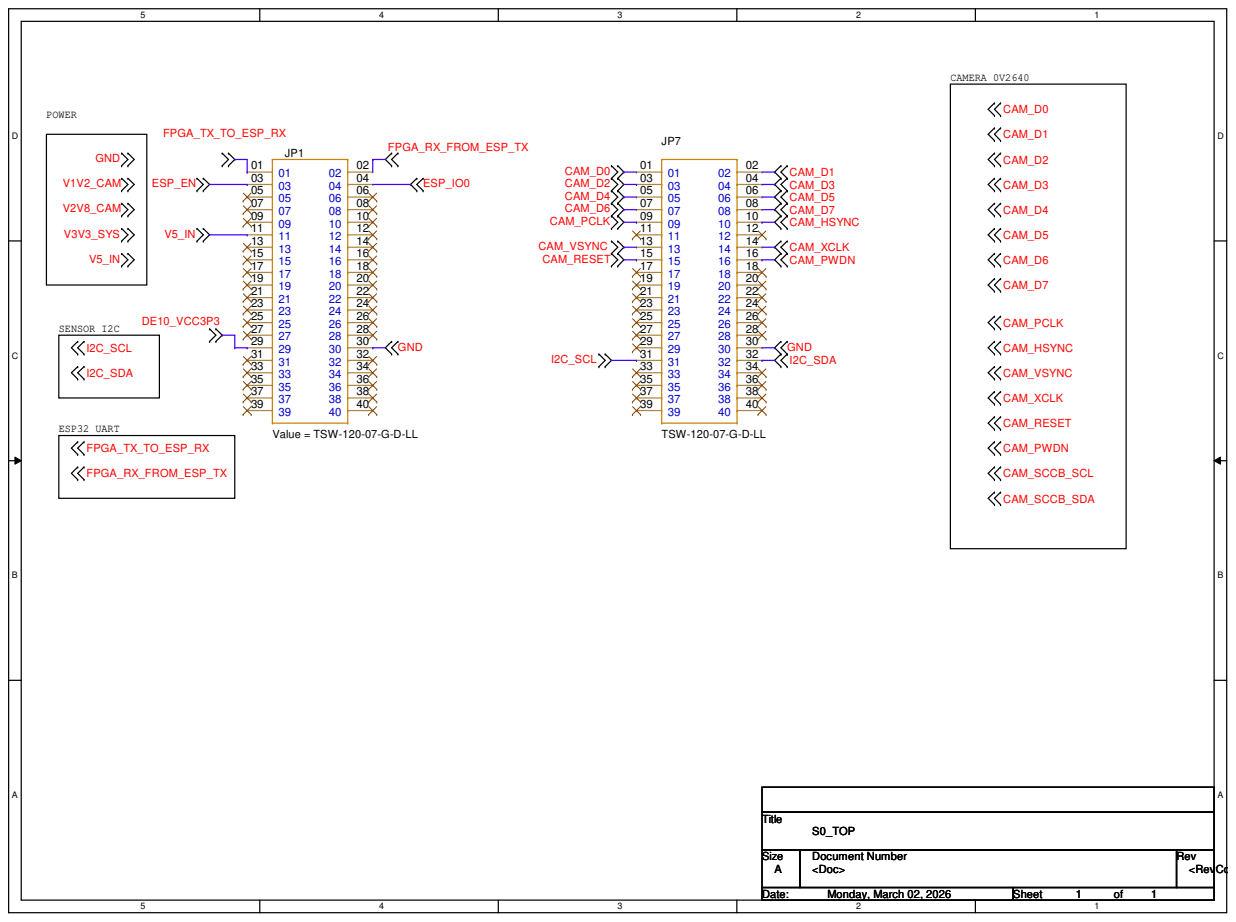
[picture p21: page 1]
POWER; SENSOR I2C; ESP32 UART; CAMERA 0V2640; V3V3_SYS; V2V8_CAM; V1V2_CAM; GND; I2C_SCL; I2C_SDA; FPGA_TX_TO_ESP_RX; FPGA_RX_FROM_ESP_TX; CAM_D0; CAM_D1; CAM_D2; CAM_D3; CAM_D4; CAM_D5; CAM_D6; CAM_D7; CAM_PCLK; CAM_HSYNC; CAM_VSYNC; CAM_XCLK; CAM_RESET; CAM_PWDN; CAM_SCCB_SCL; CAM_SCCB_SDA; CAM_D6 CAM_PCLK; ESP_EN; ESP_IO0; DE10_VCC3P3; Title; Size; Document Number; Rev; Date:; Sheet; <Doc>; <RevCo; S0_TOP; 1 1Monday, March 02, 2026; TSW-120-07-G-D-LL

Value = TSW-120-07-G-D-LL
