ctw-design-team/aiot-mask-de10-nano-v2/SCHEMATIC/S1_POWER_TREE.pdf

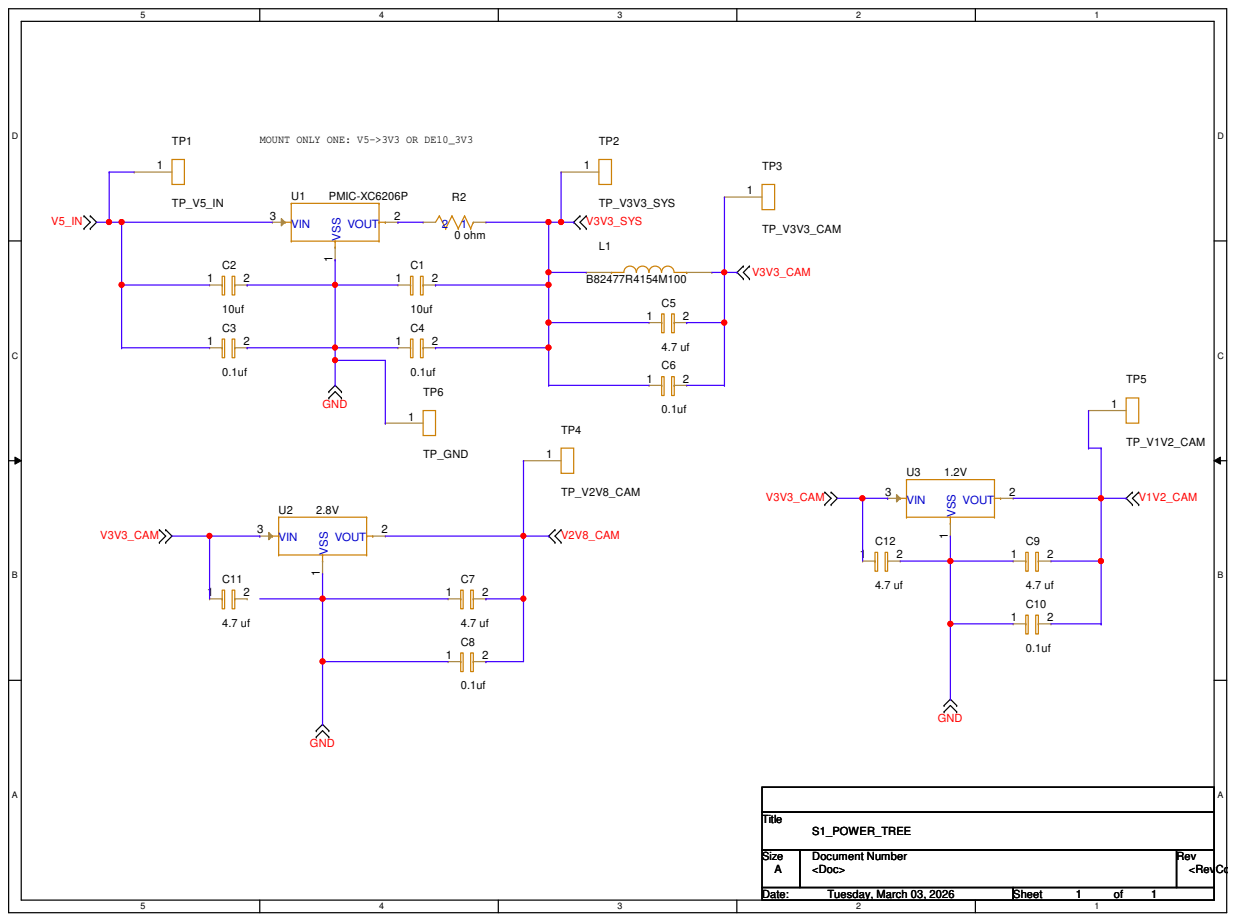
[picture p23: page 1]

MOUNT ONLY ONE: V5->3V3 OR DE10_3V3
