ctw-design-team/aiot-mask-de10-nano-v2/SCHEMATIC/S5_SENSORS_I2C.pdf

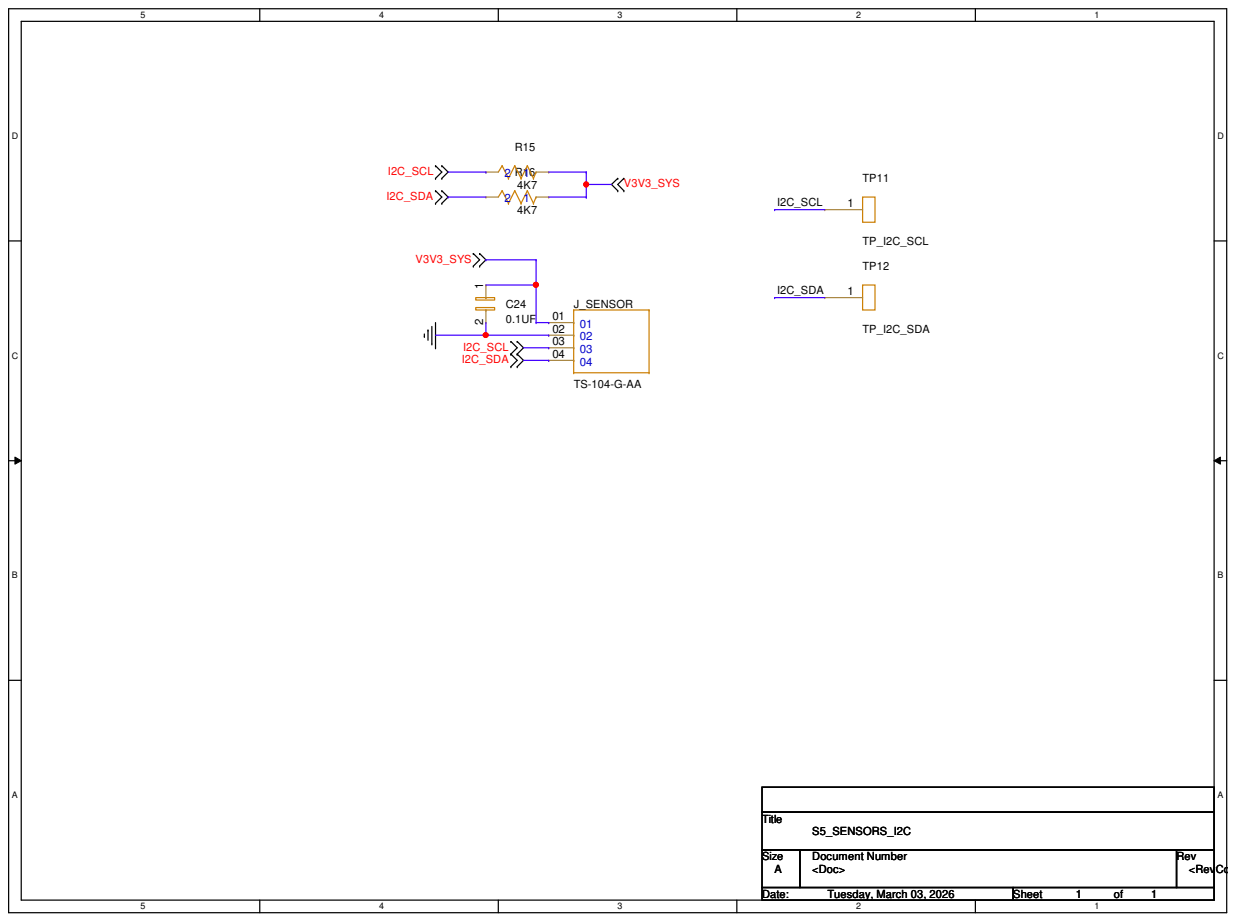
[picture p24: page 1]
V3V3_SYS; I2C_SCL; I2C_SDA; Title; Size; Document Number; Rev; Date:; Sheet; <Doc>; <RevCo; S5_SENSORS_I2C; 1Tuesday, March 03, 2026; J_SENSOR; TP_I2C_SDA; TP_I2C_SCL
