ctw-design-team/aiot-mask-de10-nano-v2/SCHEMATIC/S2_CAMERA_OV2640_FPC.pdf

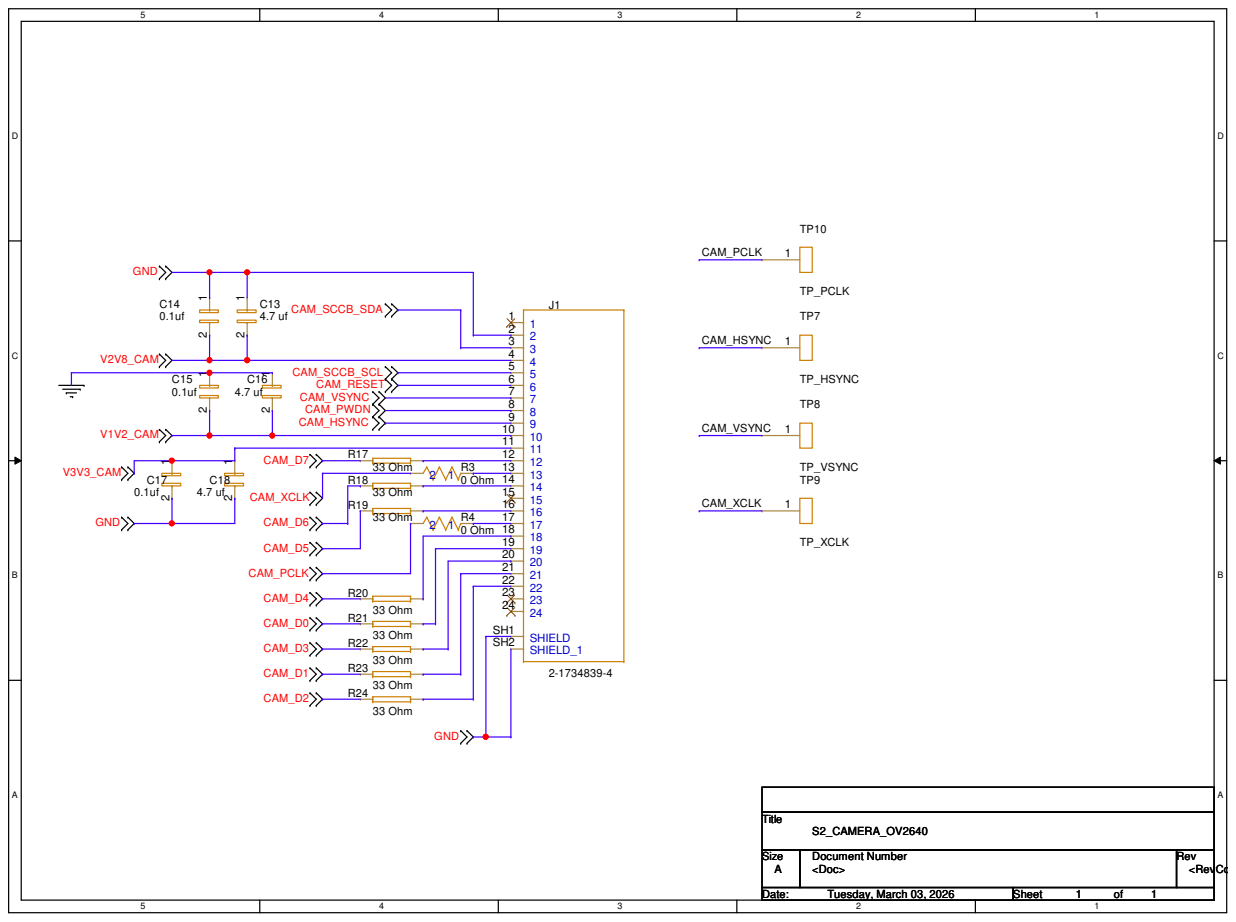
[picture p25: page 1]
