ctw-design-team/aiot-mask-de10-nano-v2/SCHEMATIC/S2_CAMERAOV2640.pdf

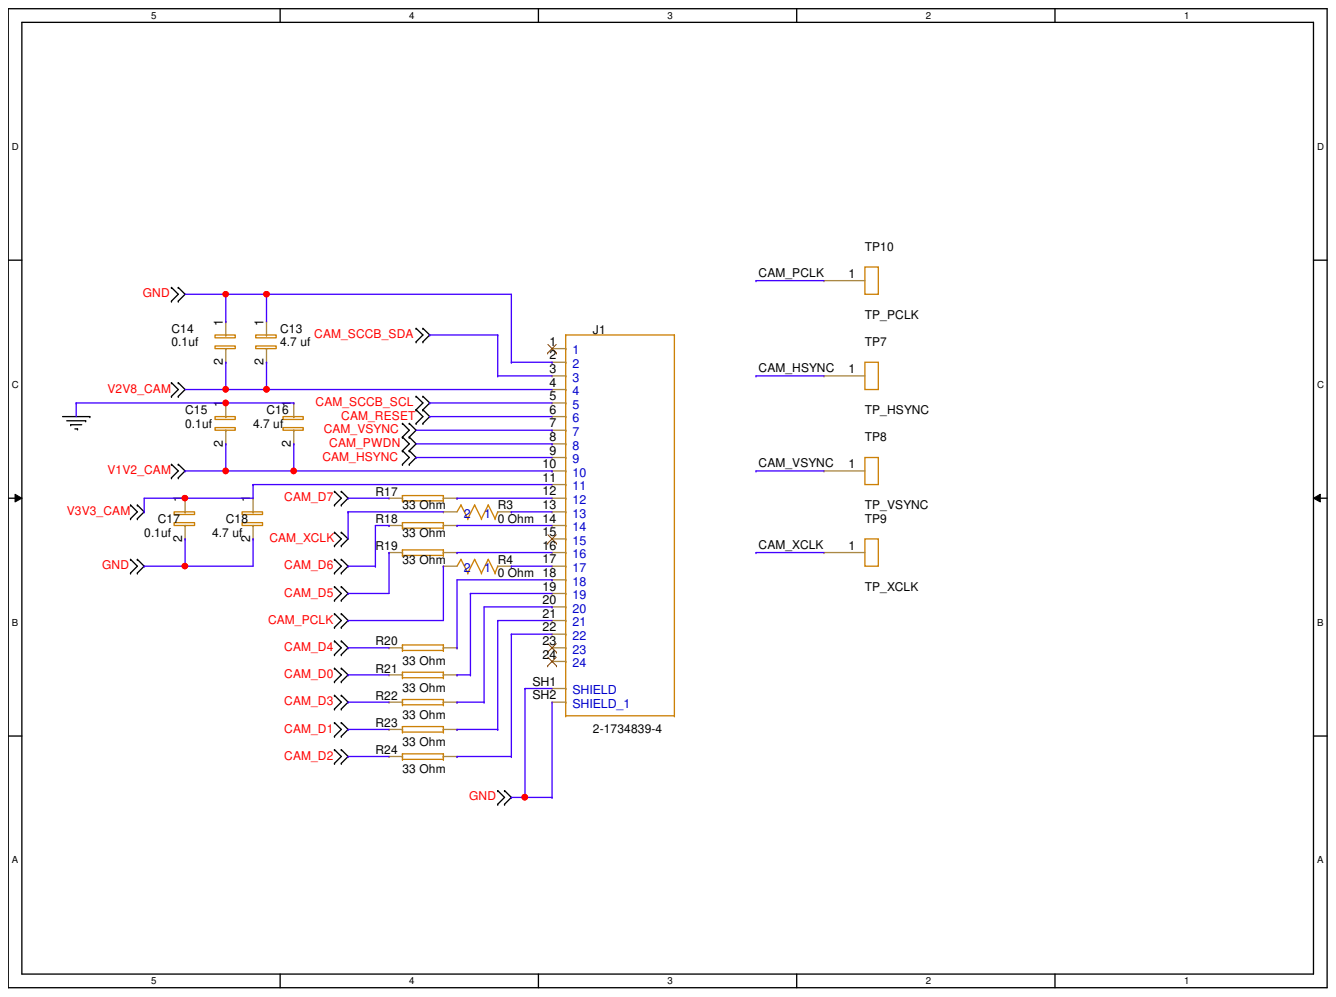
[picture p26: page 1]
