ctw-design-team/aiot-mask-de10-nano-v2/SCHEMATIC/S3_SCCB_LEVEL_SHIFTER.pdf

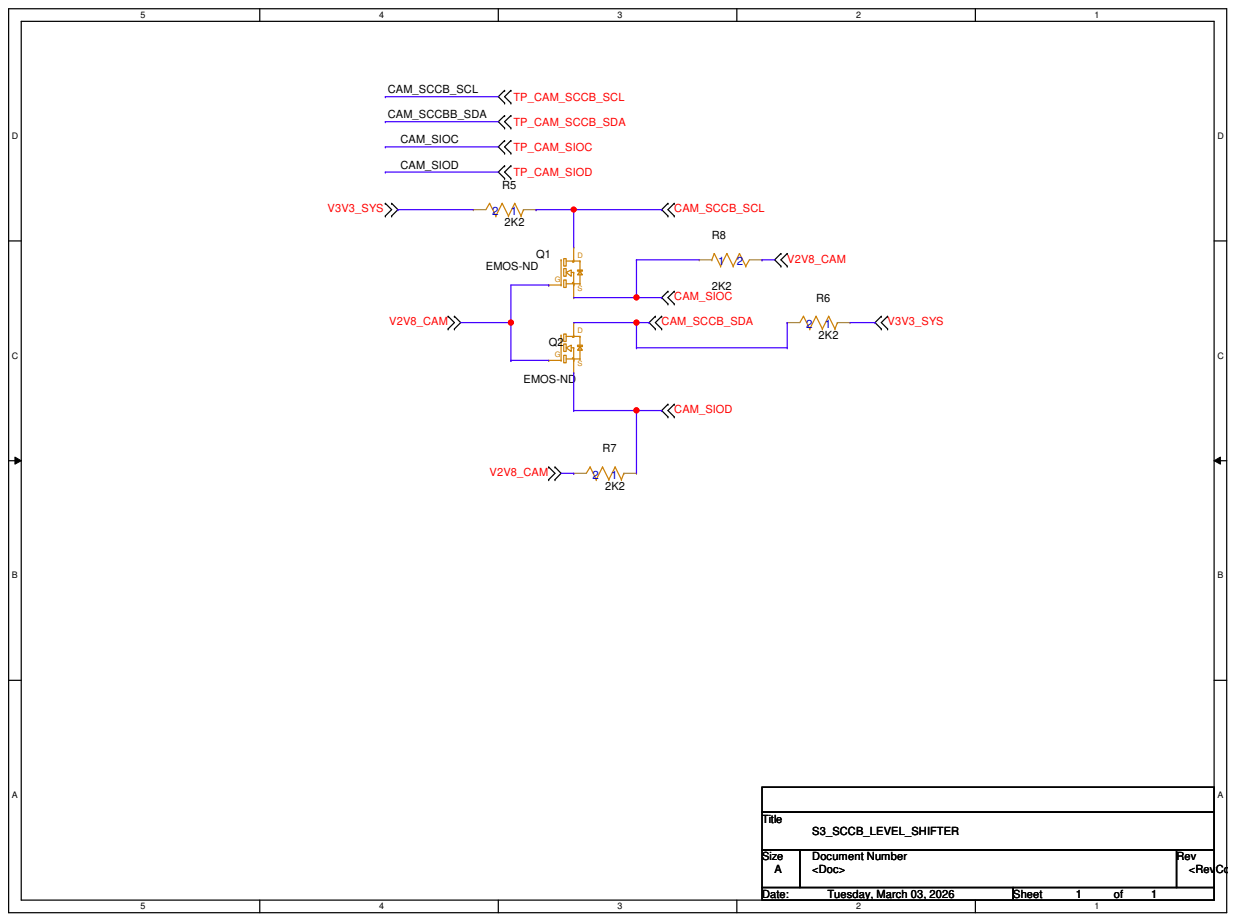
[picture p27: page 1]
V2V8_CAM; CAM_SCCB_SDA; CAM_SIOD; CAM_SIOC; CAM_SCCB_SCL; V3V3_SYS; TP_CAM_SCCB_SCL; TP_CAM_SCCB_SDA; TP_CAM_SIOC; TP_CAM_SIOD; Title; Size; Document Number; Rev; Date:; Sheet; <Doc>; <RevCo; S3_SCCB_LEVEL_SHIFTER; 1Tuesday, March 03, 2026; EMOS-ND; CAM_SCCBB_SDA
