ctw-design-team/aiot-mask-de10-nano-v2/SCHEMATIC/S4_ESP32.pdf

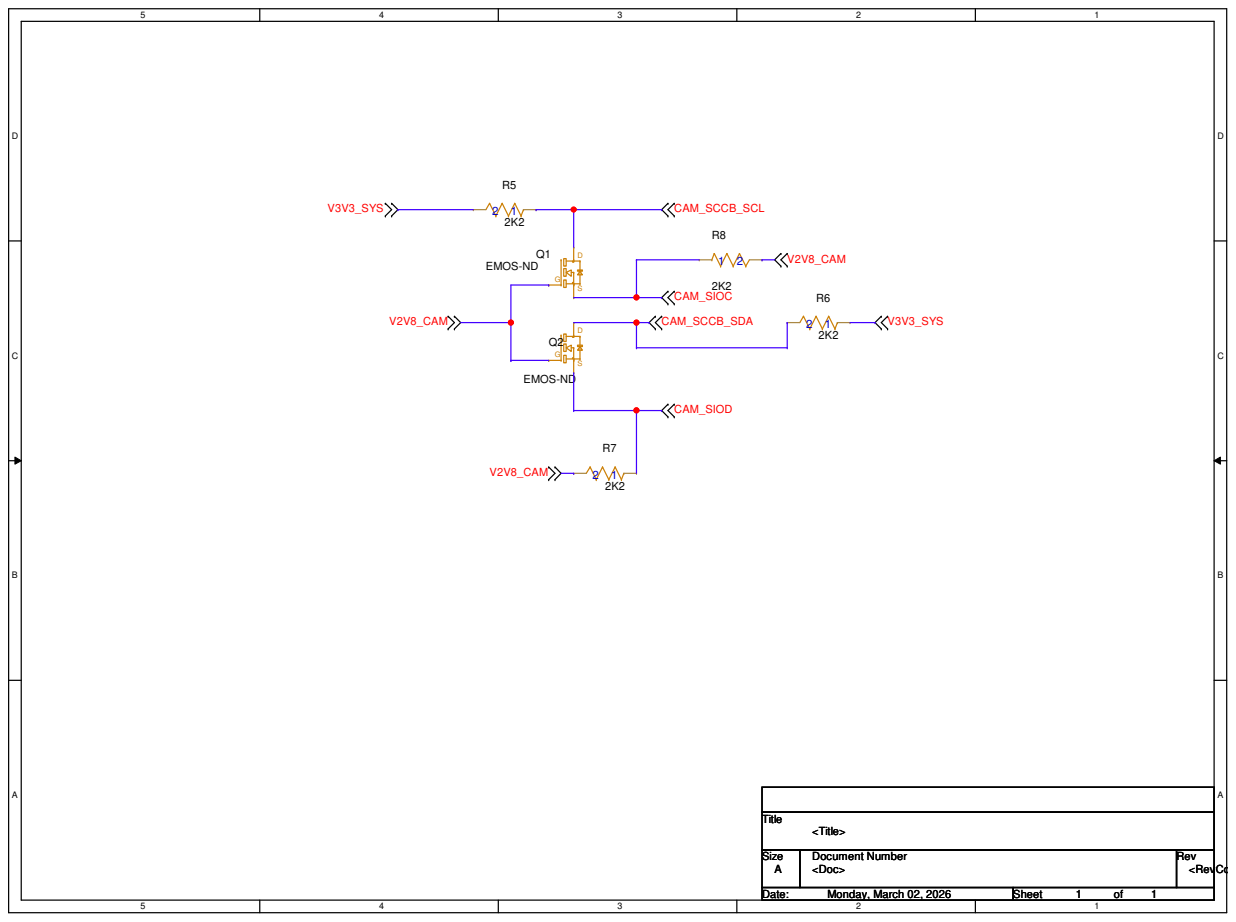
[picture p28: page 1]
V2V8_CAM; CAM_SCCB_SDA; CAM_SIOD; CAM_SIOC; CAM_SCCB_SCL; V3V3_SYS; Title; Size; Document Number; Rev; Date:; Sheet; <Doc>; <RevCo; <Title>; 1Monday, March 02, 2026; EMOS-ND
