ctw-design-team/aiot-mask-de10-nano-v2/SCHEMATIC/S4_ESP32_MODULE.pdf

01 | 01 02 | 02 03 | 03 04 | 04 05 | 05 06 | 06

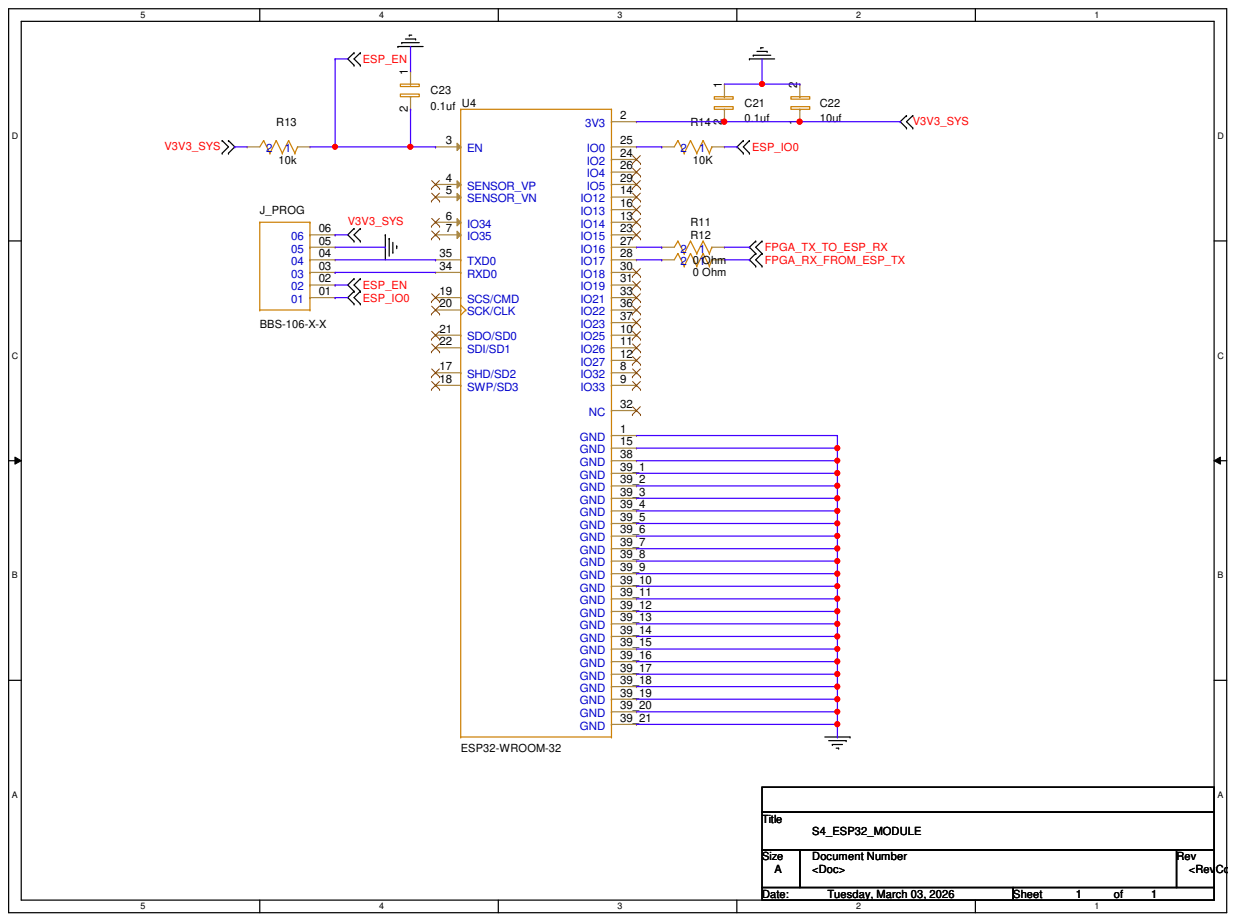
[picture p29: page 1]
