ctw-design-team/aiot-mask-de10-nano-v2/(list of files, drawings)

Other design files:
BOARD/1.dsn
SCHEMATIC/123456.DSN
SCHEMATIC/123456.opj
SCHEMATIC/LIBRARY1.OLB
SYMBOL/AHT20.OLB
SYMBOL/BH1750FVI-TR.OLB
SYMBOL/CAM HEADER.OLB
SYMBOL/CAM HEADER.opj
SYMBOL/CAPACITOR.OLB
SYMBOL/CAPACITOR.opj
SYMBOL/DIODE.OLB
SYMBOL/DIODE.opj
SYMBOL/ESP32-WROOM-32.OLB
SYMBOL/esp32-wroom-32.opj
SYMBOL/FCB-0402-101A.OLB
SYMBOL/fcb-0402-101a.opj
SYMBOL/FPC_24.OLB
SYMBOL/HEADER 4X1.OLB
SYMBOL/HEADER 6X1.OLB
SYMBOL/HEADER 40X2 .OLB
SYMBOL/HEADER 40X2 .opj
SYMBOL/INDUCTOR.OLB
SYMBOL/MCP1826S-3302EDB.OLB
SYMBOL/MOSFET FDN337N.OLB
SYMBOL/PMIC-LDO-XC6206P332MR-GSOT23.OLB
SYMBOL/RESISTOR_0805.OLB
SYMBOL/SMD-RES-33R-1-110W0603.OLB
SYMBOL/TSW-120-07-G-D-LL.OLB
