ctw-design-team/aiot-mask-de10-nano-v2/(notices)

Notices in the files:
README.md:
License: CERN-OHL-S-2.0
FOOTPRINT/FCB-0402-101A.stp:
author */ ('License CC BY-ND 4.0'),
